CarolinaVasquez2000/FarmaBot/README.md

<!-- Imagen del encabezado centrada -->
<p align="center">
  FarmaBot Banner
</p>

# 💊 FarmaBot

**FarmaBot** El proyecto consiste en el desarrollo de un robot capaz de realizar la recolección de cajas de medicamentos específicos desde una estantería de farmacia, basándose en las instrucciones proporcionadas por un usuario. El robot navegará a lo largo de un camino predefinido y será capaz de manipular y transportar los medicamentos solicitados hasta una zona de recepción.
<p align="center">
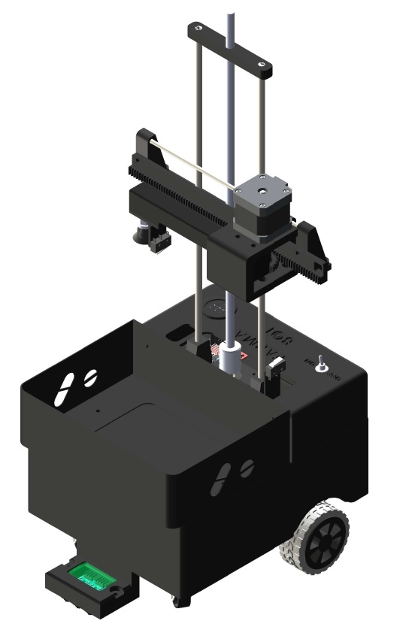
[picture p1: Imagenes y videos/CARRO FARMABOT.jpg]
FarmaBot Banner
  
</p>
<p align="center">
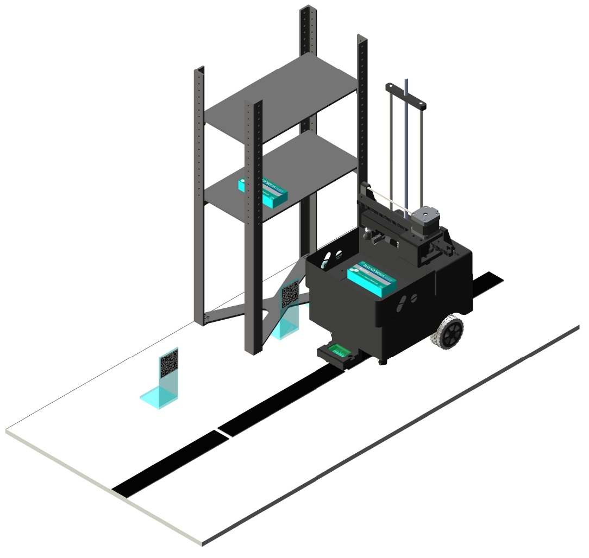
[picture p2: Imagenes y videos/CARRO CON ESTANTERIA.jpg]
  
</p>
<p align="center">
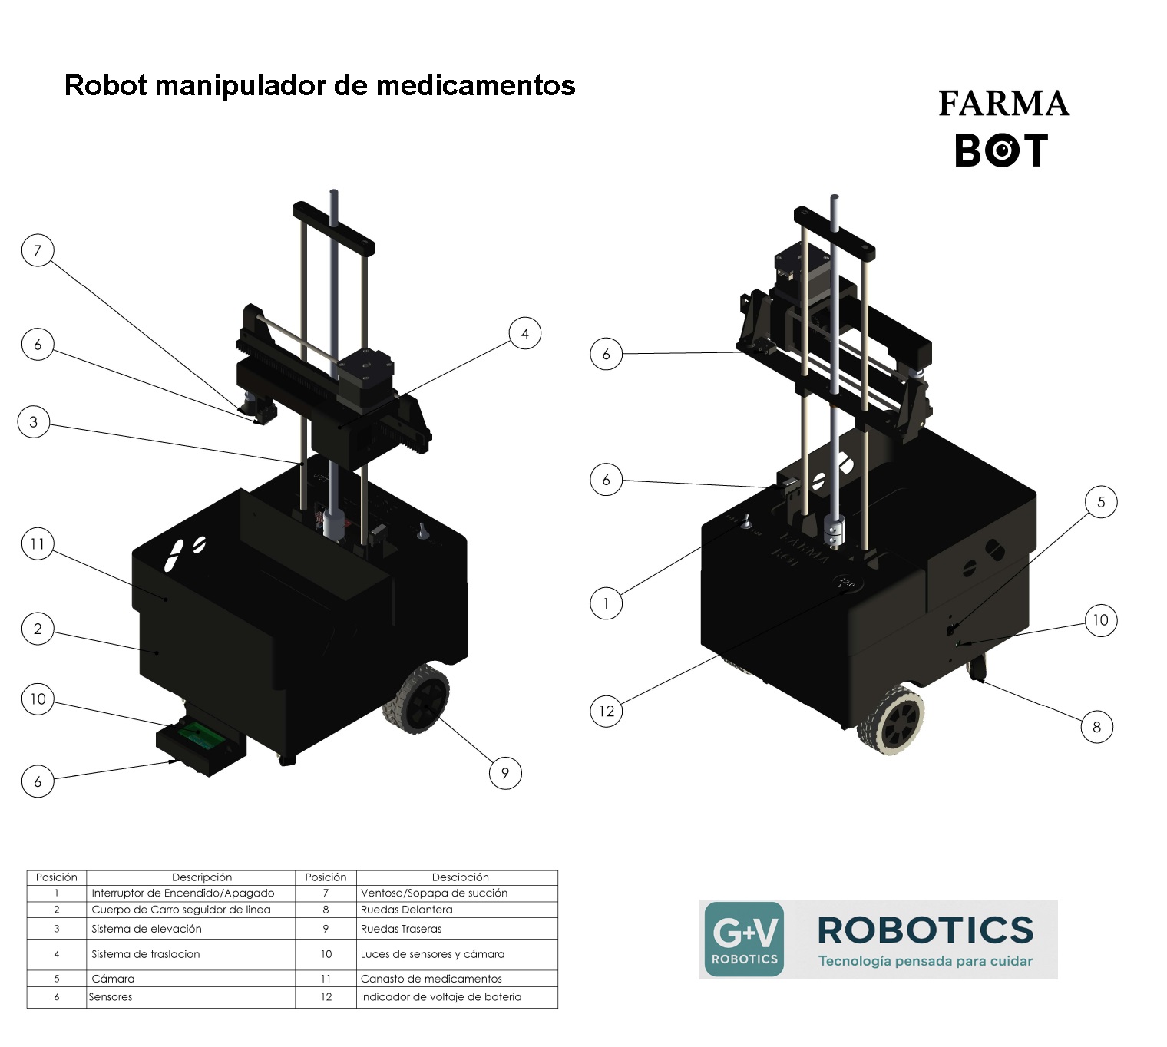
[picture p3: Imagenes y videos/PARTES.jpg]
  
</p>
---

## 👥 Integrantes

- Matías Nicolás Gabio  
- Carolina Vasquez

---

## 👨‍🏫 Profesores

- Ezequiel Blanca  
- Cristian Leandro Lukaszewicz  
- Juan Ignacio Szombach
