CarolinaVasquez2000/FarmaBot/Planos e informacion mécanica/Especificación técnica de productos comerciales mecanicos/29 - RUEDA LIBRE.pdf

DATASHEET GENERADO A PARTIR DE LA INFORMACION DE LA PAGINA DEL FABRICANTE

## Rueda Loca Tipo Pivot

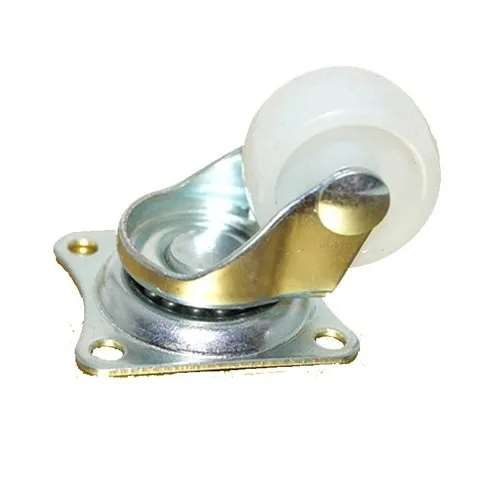
[picture p45: figure]

Altura: 35mm
Diámetro rueda: 24mm
Ancho rueda: 13mm
Peso: 32,6 g

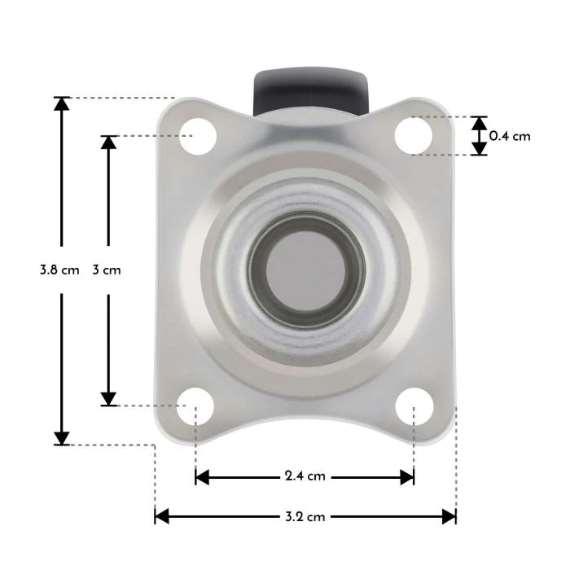
[picture p46: figure]
