CarolinaVasquez2000/FarmaBot/Planos e informacion mécanica/Especificación técnica de productos comerciales mecanicos/30 - LLANTA DE RUEDA MOTRIZ.pdf

DATASHEET GENERADO A PARTIR DE LA INFORMACION DE LA PAGINA DEL FABRICANTE

## Rueda Para Motor Con Encastre Roboca Arduino

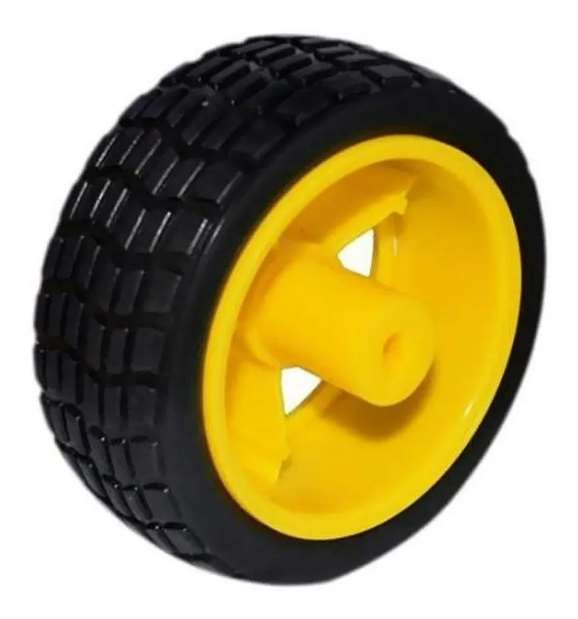
[picture p47: figure]

Agujero central: 5.3 x 3.66mm Tamaño de llanta: 65 x 28mm Peso: 32gr
