CarolinaVasquez2000/FarmaBot/Planos e informacion mécanica/Especificación técnica de productos comerciales mecanicos/39 - 50 - VARILLA ROSCADA ASCENSO - TUERCA THSTL 8 MM TIPO ACME TRAPEZOIDAL.pdf

DATASHEET GENERADO A PARTIR DE LA INFORMACION DE LA PAGINA DEL FABRICANTE

## Husillo Eje Z Con Tuerca Original Ender 3 V2

Largo 380 mm
THSTL 8 mm po ACME

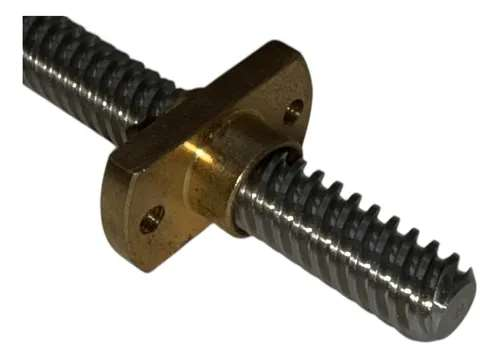
[picture p48: figure]
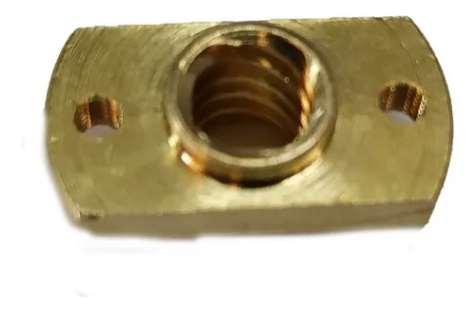
[picture p49: figure]

Tuerca para Varilla Tornillo THSL T8
