CarolinaVasquez2000/FarmaBot/Planos e informacion mécanica/Especificación técnica de productos comerciales mecanicos/41 - RACORD M8 ACOPLE.pdf

DATASHEET GENERADO A PARTIR DE LA INFORMACION DE LA PAGINA DEL FABRICANTE

## Acople Racor M8

CARACTERISTICAS:

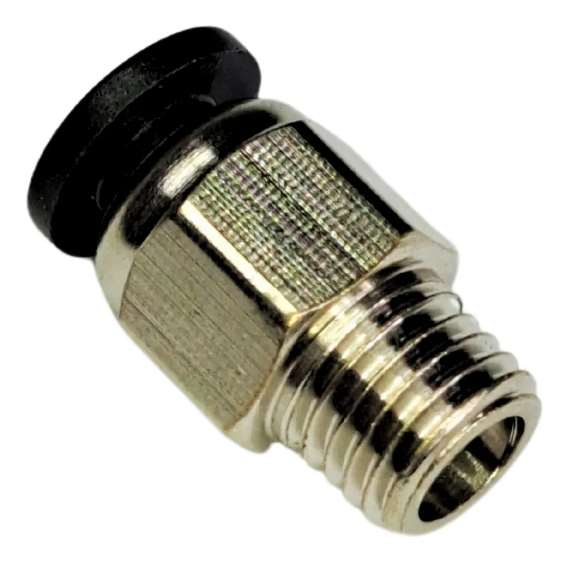
[picture p50: figure]

Acople neumaco racor modelo M6 SIN TOPE de rosca M8 para manguera de 4mm

DESCRIPCION:
Modelo:M8 SIN TOPE
Rosca: M8
Para Manguera: 4mm
Material: Bronce
