CarolinaVasquez2000/FarmaBot/Planos e informacion mécanica/Especificación técnica de productos comerciales mecanicos/45 - PLACA PERFORADA.pdf

DATASHEET GENERADO A PARTIR DE LA INFORMACION DE LA PAGINA DEL FABRICANTE

## Pcb Placa Protoboard Doble Faz 4x6 Cm Protopo

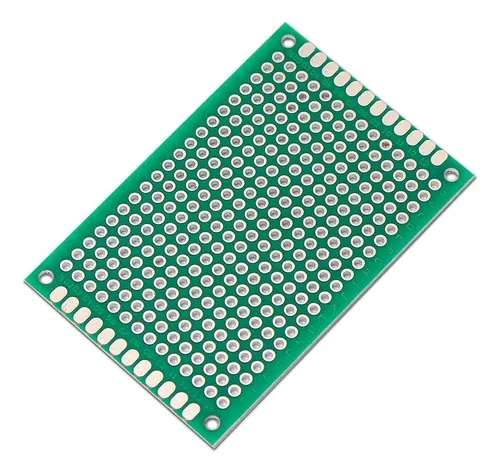
[picture p51: figure]

Pcb Placa Protoboard Doble Faz 4x6 Cm Protopo Fr4 Placa protopo 4x6cm doble faz FR4
