CarolinaVasquez2000/FarmaBot/Planos e informacion mécanica/Especificación técnica de productos comerciales mecanicos/51 - ACOPLE RIGIDO.pdf

DATASHEET GENERADO A PARTIR DE LA INFORMACION DE LA PAGINA DEL FABRICANTE

## Acople Rígido Impresora 3d Creality

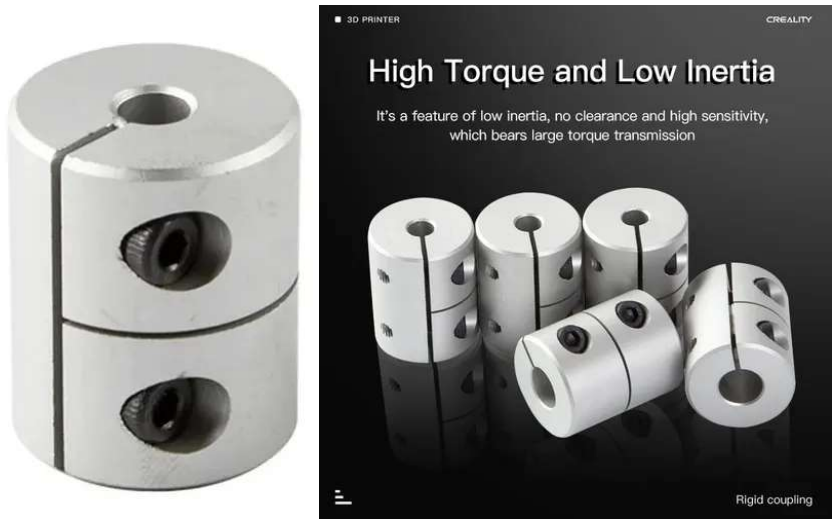
[picture p52: figure]

Descripción:
Alto: 25 mm
Diámetro: 20 mm
Diámetro de orificios: 7,5 mm y 4,5 mm (ajustables) Material: aluminio
