CarolinaVasquez2000/FarmaBot/Planos e informacion mécanica/Especificación técnica de productos comerciales mecanicos/52 - ENGRANAJE HOBBED MK8 MOLETEADO.pdf

DATASHEET GENERADO A PARTIR DE LA INFORMACION DE LA PAGINA DEL FABRICANTE

## Rueda Dentada Hobbed Mk8 Creality 40 Dientes Extrusor

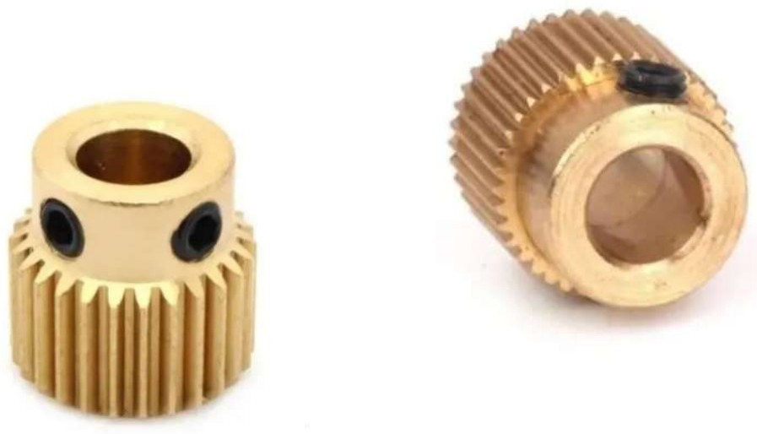
[picture p53: figure]

RUEDA DENTADA DE EXTRUSOR

Color: Dorado
Material: Bronce
Diametro Interior: 5mm
Diametro Exterior: 11mm
Altura: 11mm

### 40 dientes
