CarolinaVasquez2000/FarmaBot/Planos e información eléctrica/Especificación técnica de productos comerciales eléctricos/35 - BATERIA 12 V 4 AMPHORA.pdf

DATASHEET GENERADO A PARTIR DE LA INFORMACION DE LA PAGINA DEL FABRICANTE

BATERIA DE GEL 12V 4A PRESS MICROSWICH LLAVE SIMPLE INVERSORA 5A 250V CON PALANCA 15mm 1° CALIDAD

DISTANCIA AGUJERO A AGUJERO : 10mm

BATERIA GEL 12VOLT 4Ah
MODELO: PR1240

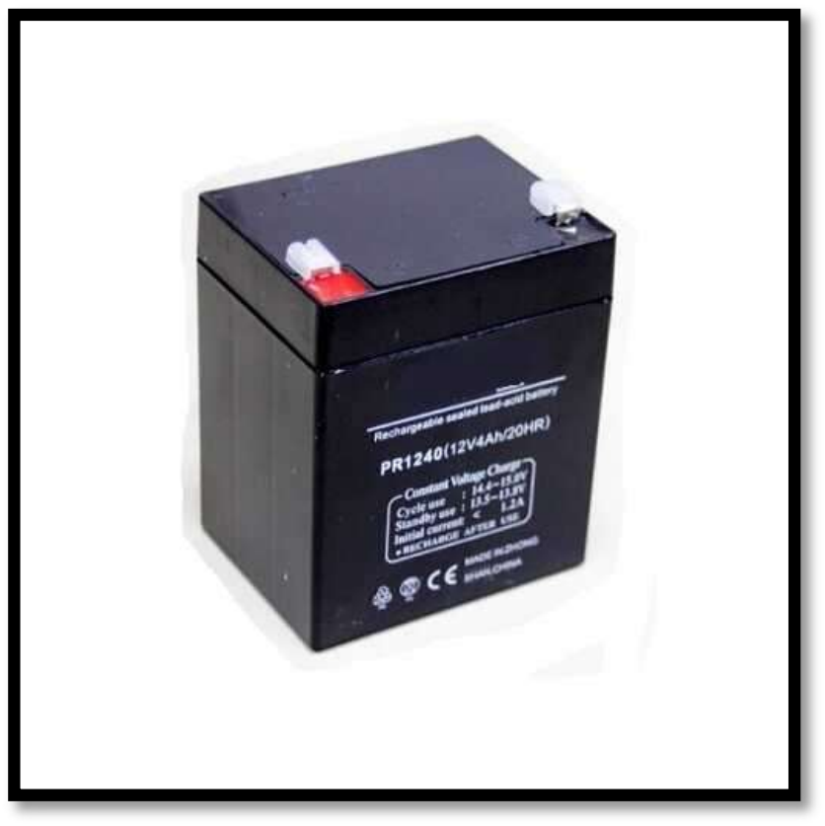
[picture p54: figure]

BATERIA MARCA PRESS 12V 4A PLOMO ACIDO
SELLADA DE PLOMO CALCIO

CARGA FLOTANTE: 13.5 - 13.8 CORRIENTE INICIAL: SIN LÍMITE CARGA CÍCLICA: 14,4 - 15v CORRIENTE INICIAL: 1,2A Max

Largo:90MM
Ancho:70MM
Altura:101MM
Tipo de conector: FO-01
