CarolinaVasquez2000/FarmaBot/Planos e información eléctrica/Especificación técnica de productos comerciales eléctricos/47 - INDICADOR DE VOLTAJE.pdf

DATASHEET GENERADO A PARTIR DE LA INFORMACION DE LA PAGINA DEL FABRICANTE

## Medidor Voltaje Panel Digital 3 Digitos 30mm 4v A 100v

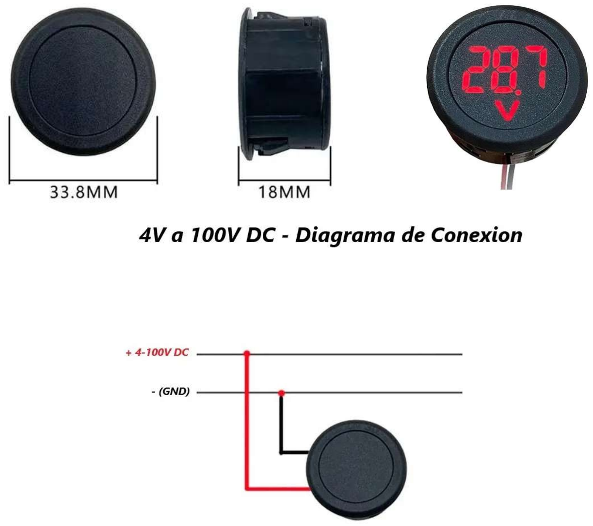
[picture p55: figure]

Especificaciones:
- Volmetro Digital
- 3 Dígitos
- Cables de Conexión: 2 (Dos)
- Tamaño: 30mm
- Voltaje de Alimentación: 3.8V a 100V DC
- Voltaje de Medición en Led: 4V a 100V DC
- Consumo: 15mA
- Margen de error volmetro: 0.1%
- Tiempo de refresco: 300ms
- Largo de Cable: 20cm
- Dimensión para Montaje: 30mm
- Peso: 26gr
