CarolinaVasquez2000/FarmaBot/Planos e información eléctrica/Especificación técnica de productos comerciales eléctricos/48 - MOTOR PASO A PASO NEMA 17 42-40.pdf

DATASHEET GENERADO A PARTIR DE LA INFORMACION DE LA PAGINA DEL FABRICANTE

## MOTOR PASO A PASO NEMA 17 42-40 CREALITY

ESPECIFICACIONES:
Ángulo de paso: 1,8 grados Pasos: 200
Tensión nominal: 4.83V
Clasificación actual: 1.5A

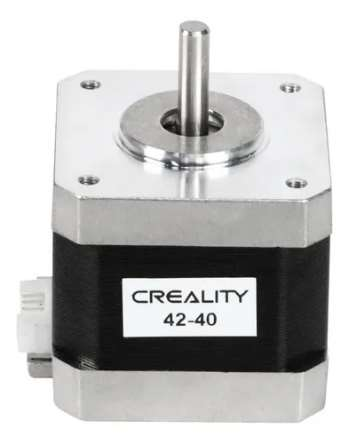
[picture p56: figure]

Velocidad nominal: 1-1000rpm Velocidad nominal: 1-1000tpm Par de torsión nominal: 0.4NM Temperatura de trabajo: -20 - 50C Longitud: 40mm
Peso 290 g

DATASHEET GENERADO A PARTIR DE LA INFORMACION DE LA PAGINA DEL FABRICANTE

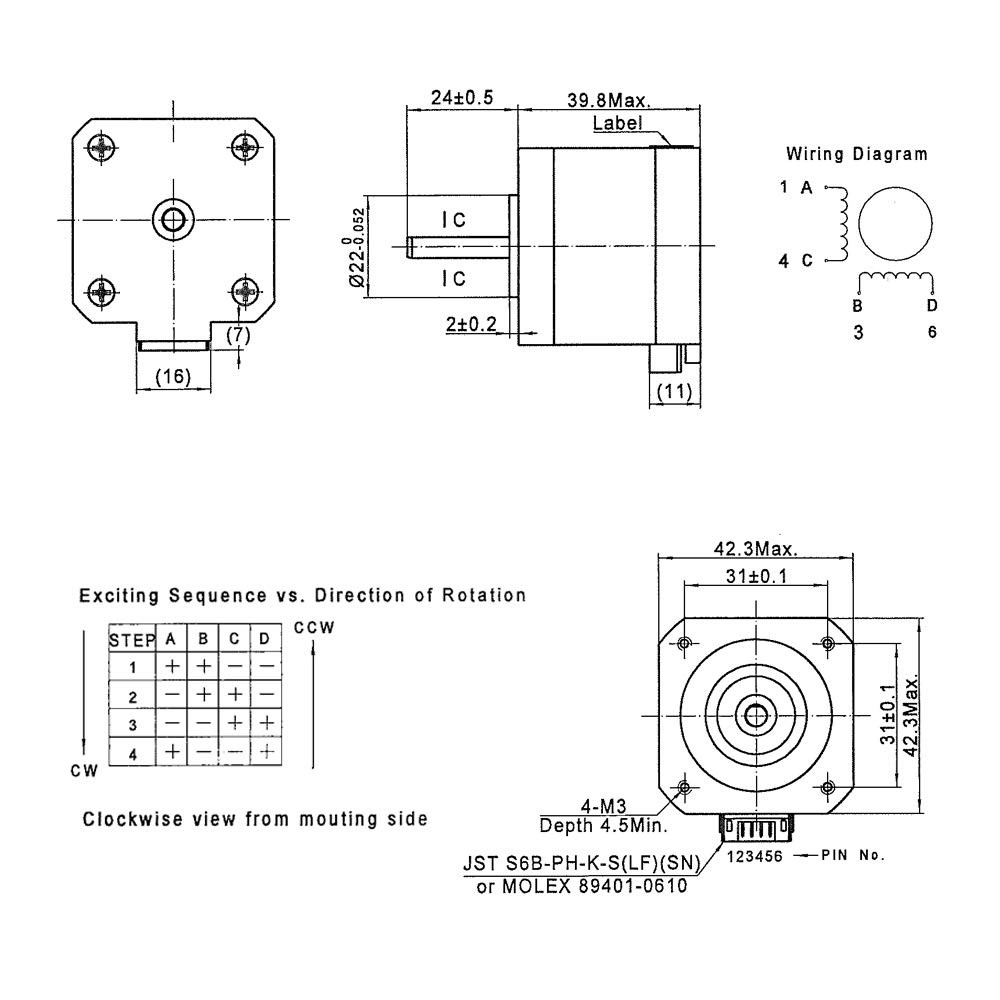
[picture p57: figure]
