CarolinaVasquez2000/FarmaBot/Planos e información eléctrica/Especificación técnica de productos comerciales eléctricos/49 - MOTOR PASO A PASO NEMA 17 42-34.pdf

## MOTOR PASO A PASO NEMA 17 42-34

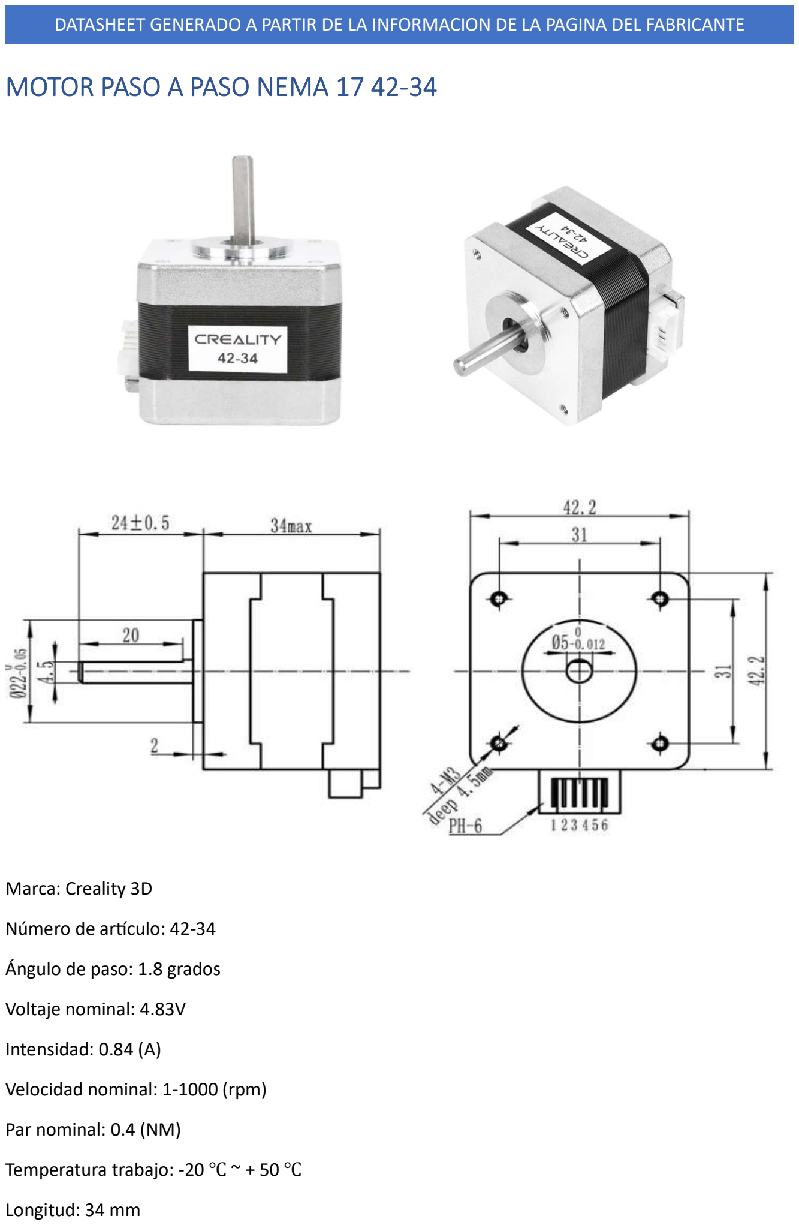
[picture p58: page 1]

DATASHEET GENERADO A PARTIR DE LA INFORMACION DE LA PAGINA DEL FABRICANTE

Marca: Creality 3D
Número de arculo: 42-34
Ángulo de paso: 1.8 grados Voltaje nominal: 4.83V
Intensidad: 0.84 (A)
Velocidad nominal: 1-1000 (rpm) Par nominal: 0.4 (NM)
Temperatura trabajo: -20 ℃ ~ + 50 ℃ Longitud: 34 mm
