CarolinaVasquez2000/FarmaBot/Consultas realizadas/CONSTANCIA DE CONSULTA REALIZADA A MARTIN GONZALEZ.pdf

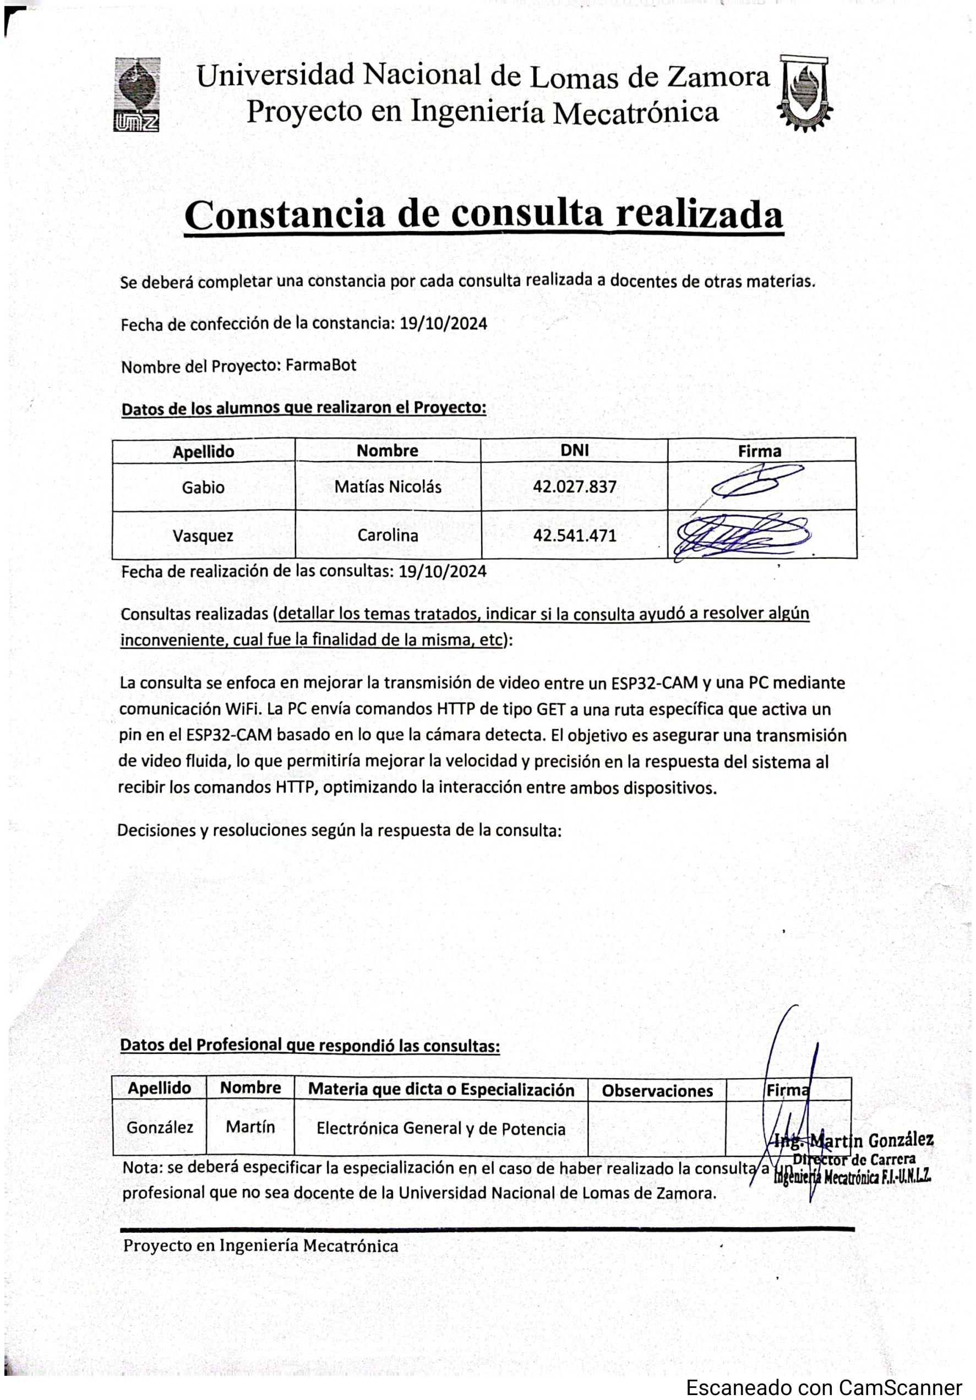
[picture p59: page 1]
