CarolinaVasquez2000/FarmaBot/Consultas realizadas/CONSTANCIA DE CONSULTA REALIZADA A MATIAS JOEL HIRAK.pdf

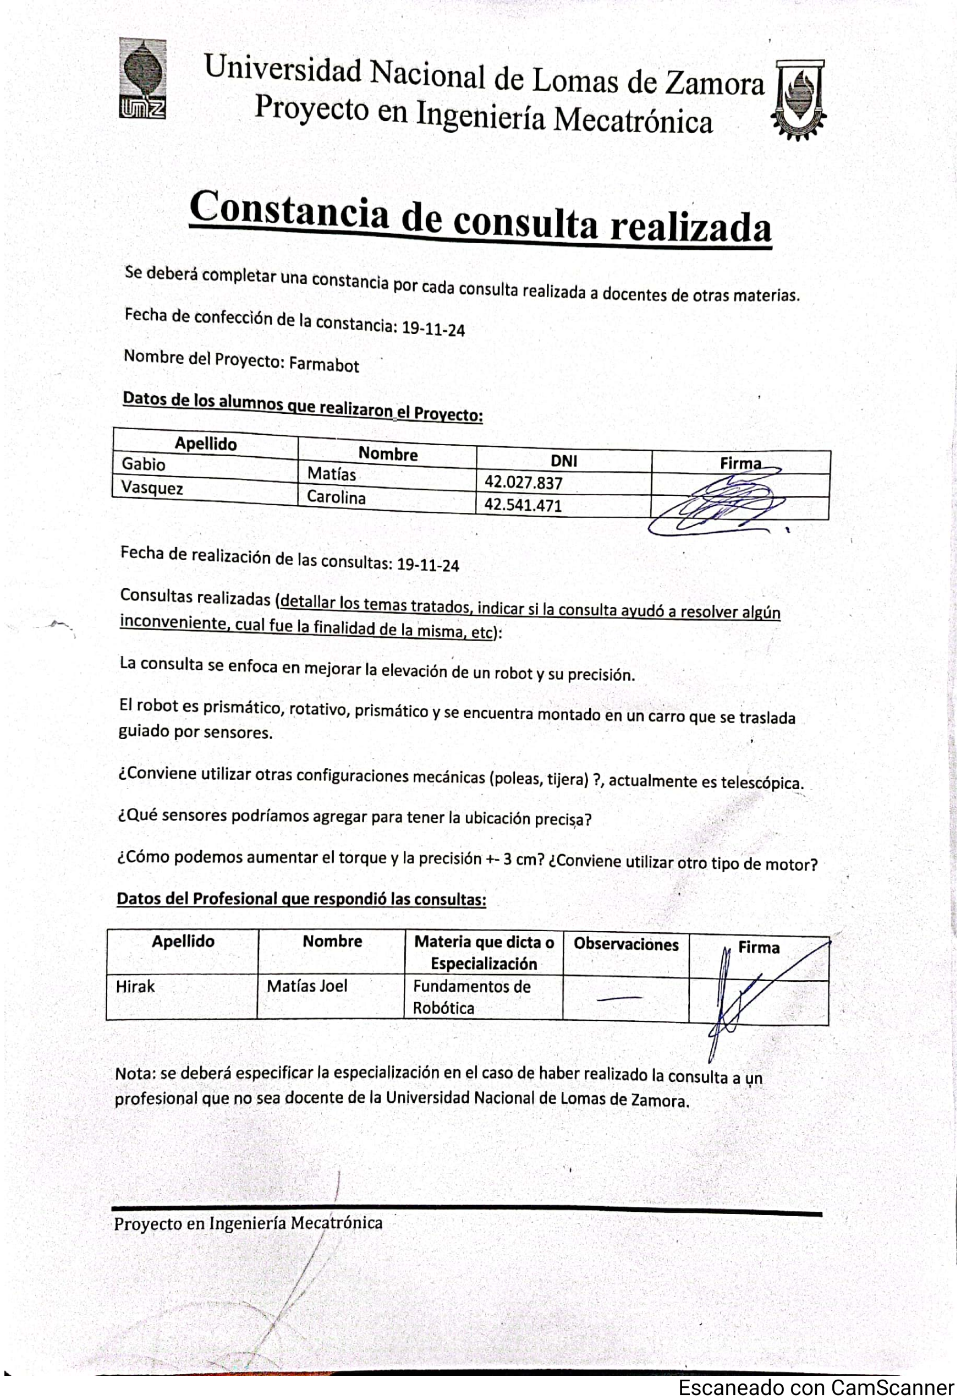
[picture p60: page 1]
