CarolinaVasquez2000/FarmaBot/Planos e informacion mécanica/Planos Mecanicos/01 - BASE DE CARRO.pdf

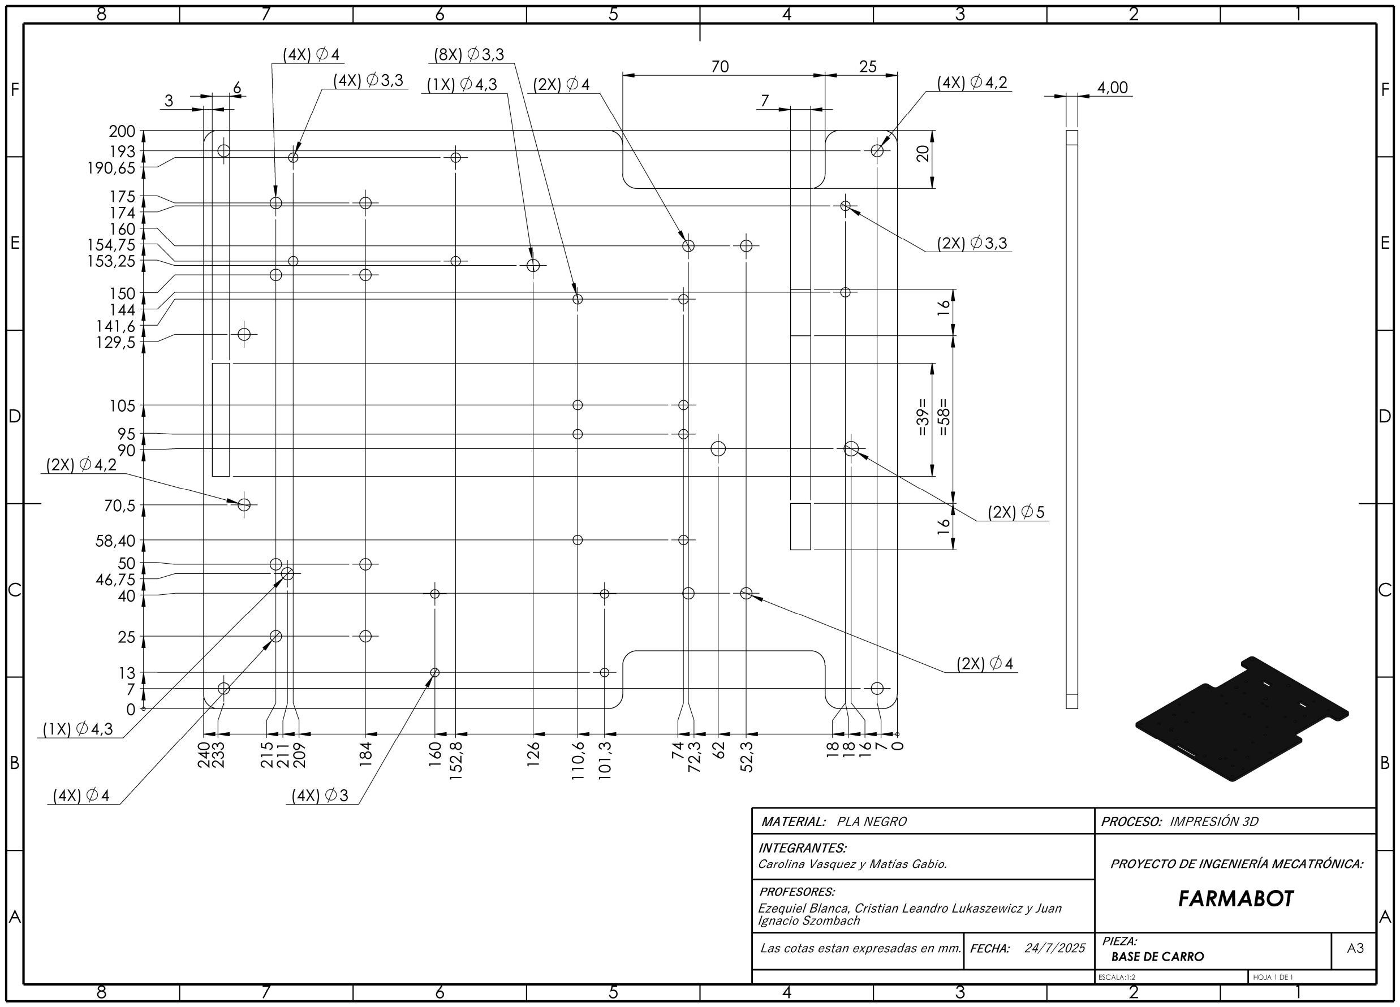
[picture p61: page 1]
