CarolinaVasquez2000/FarmaBot/Planos e informacion mécanica/Planos Mecanicos/02 - SOPORTE DE RUEDAS.pdf

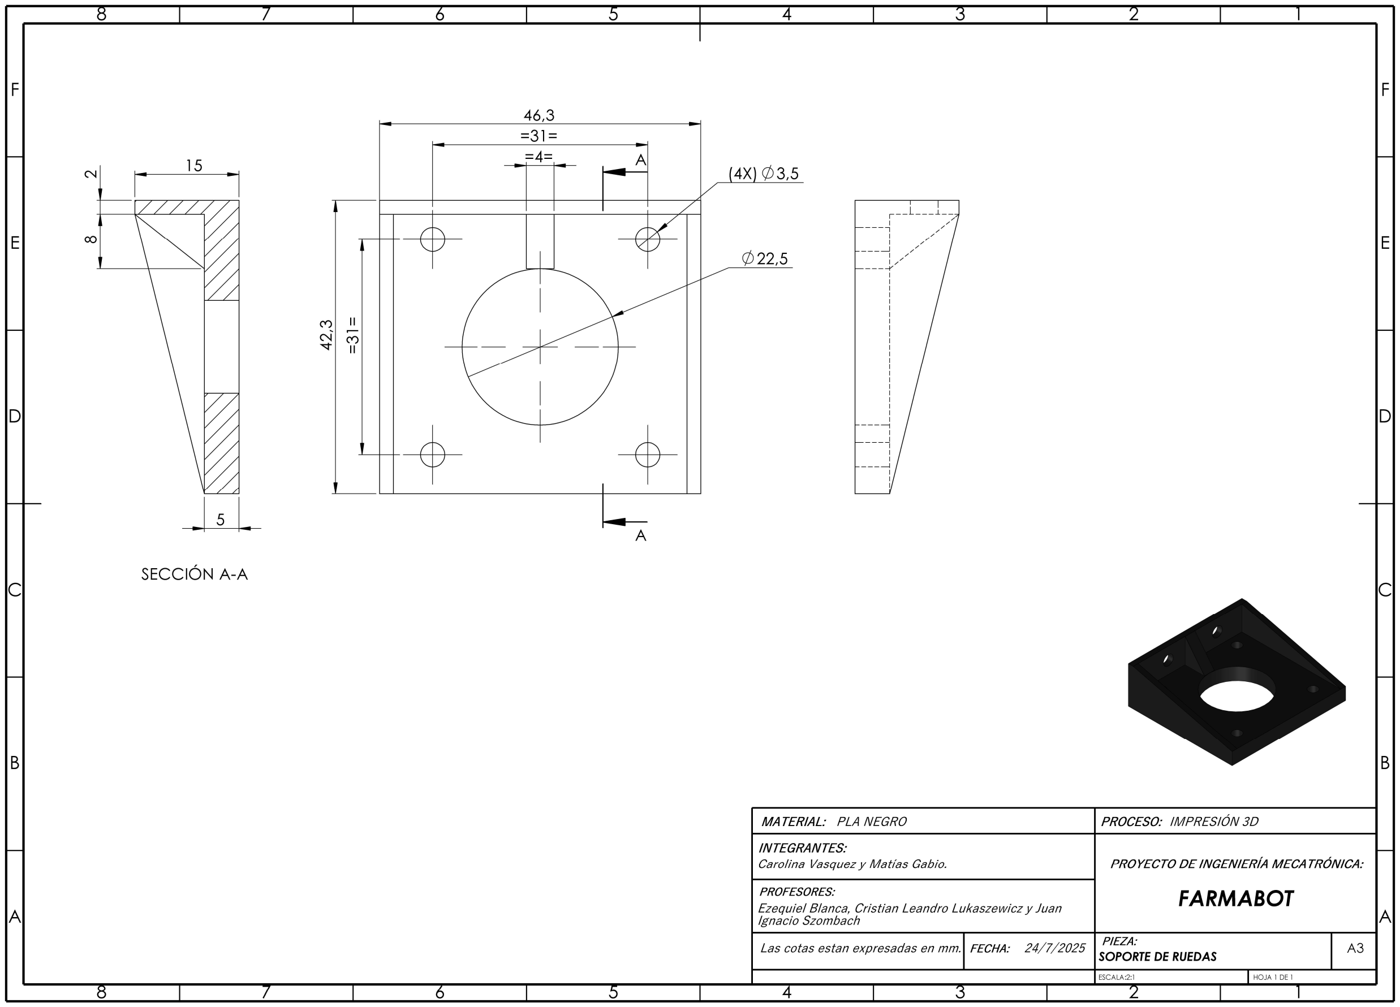
[picture p62: page 1]
