CarolinaVasquez2000/FarmaBot/Planos e informacion mécanica/Planos Mecanicos/04 - SOPORTE DE SENSORES.pdf

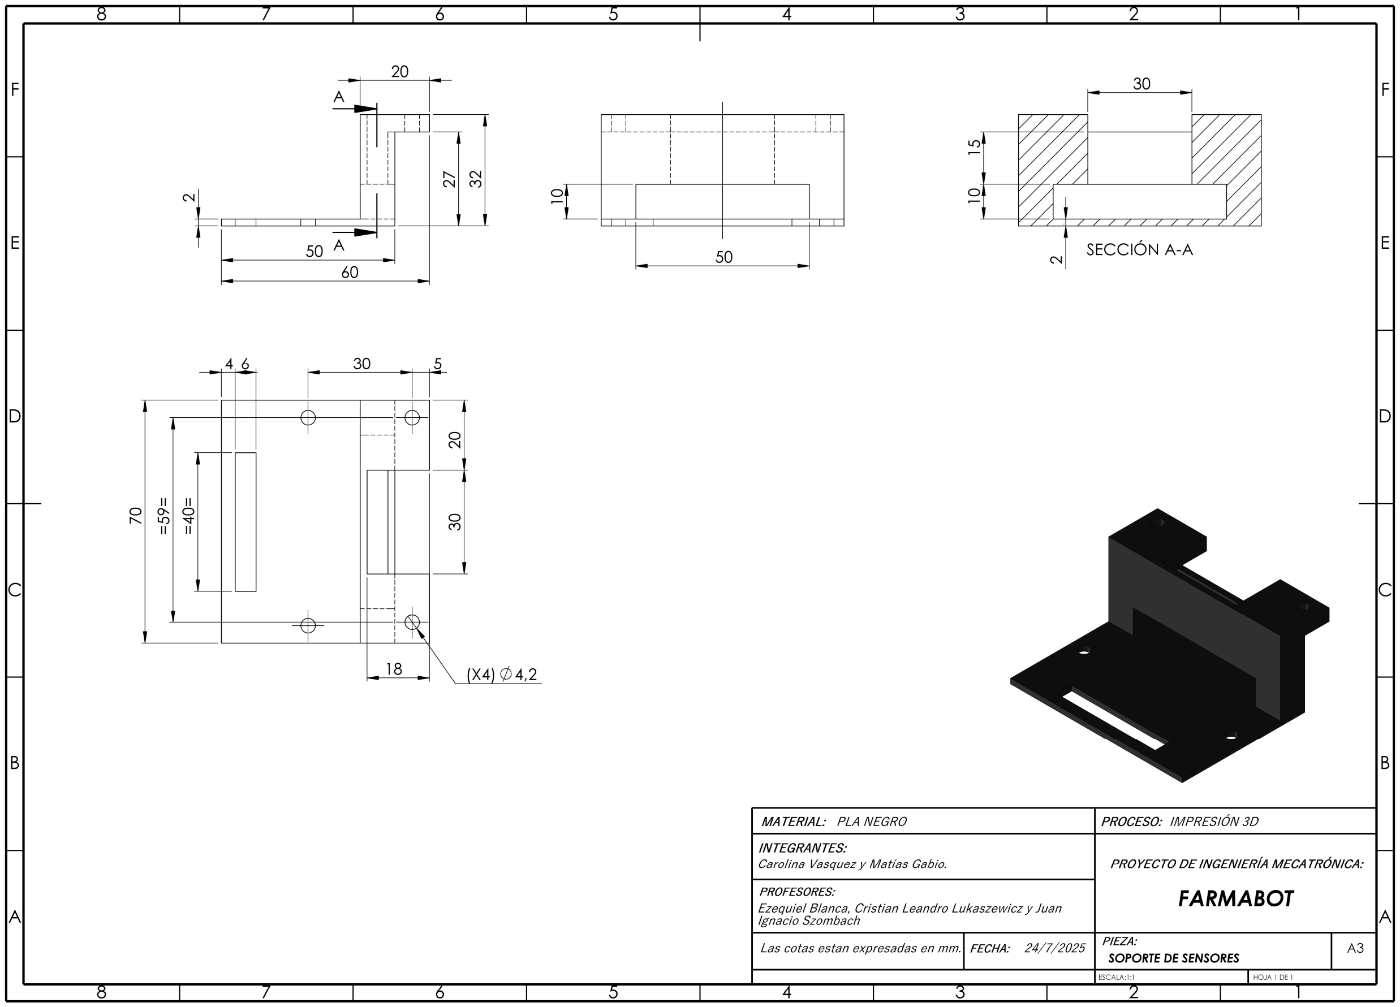
[picture p63: page 1]
