CarolinaVasquez2000/FarmaBot/Planos e informacion mécanica/Planos Mecanicos/05 - BASE DE RUEDA.pdf

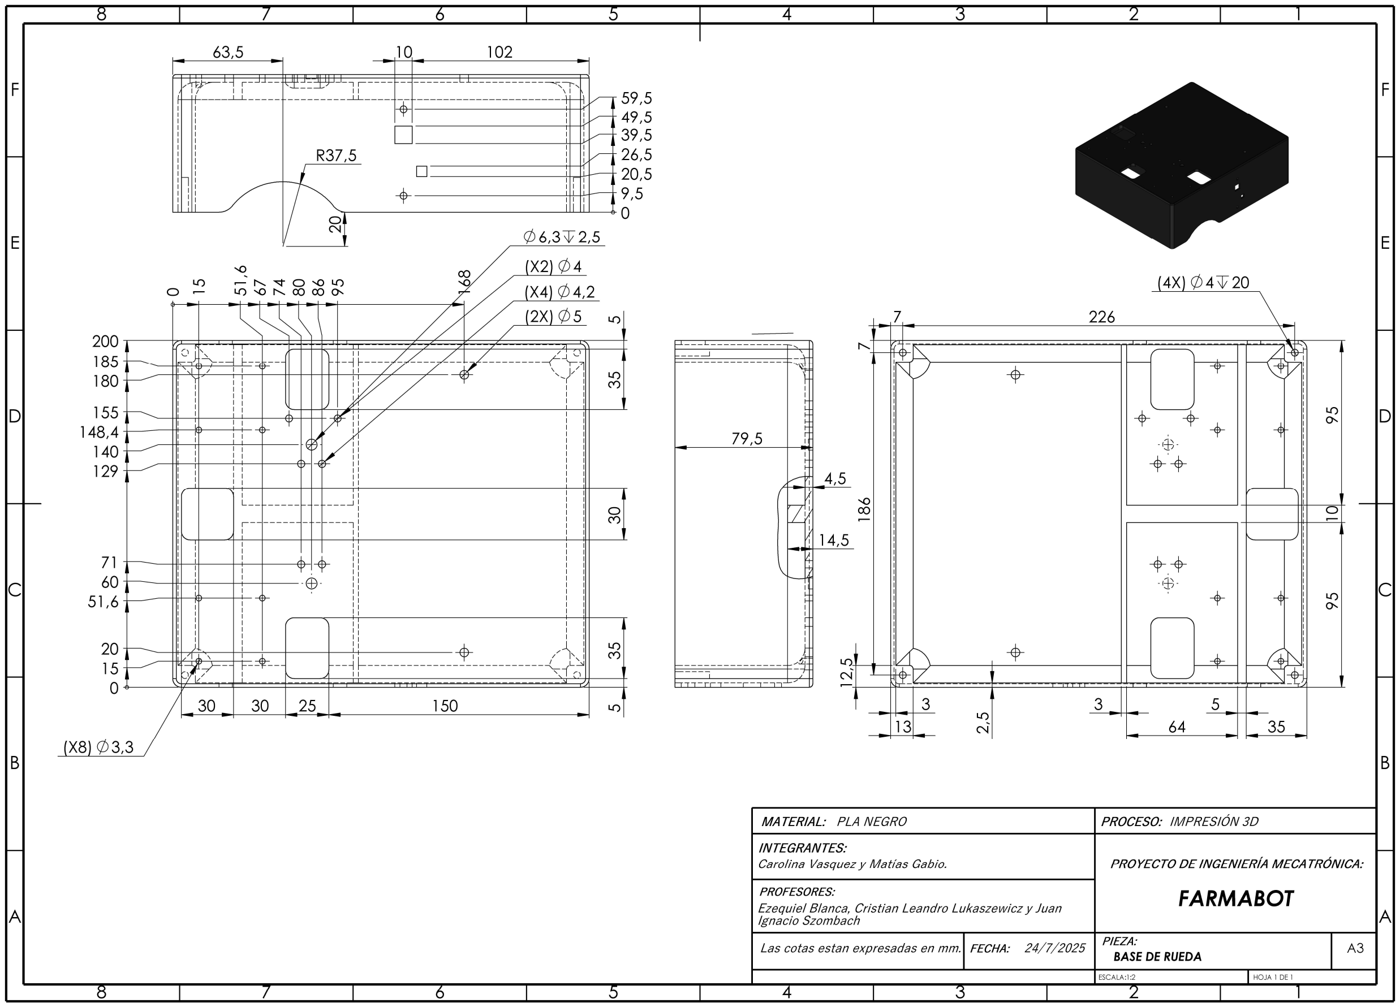
[picture p64: page 1]
