CarolinaVasquez2000/FarmaBot/Planos e informacion mécanica/Planos Mecanicos/06 - FIJACION DE MOTOR DE ASCENSO.pdf

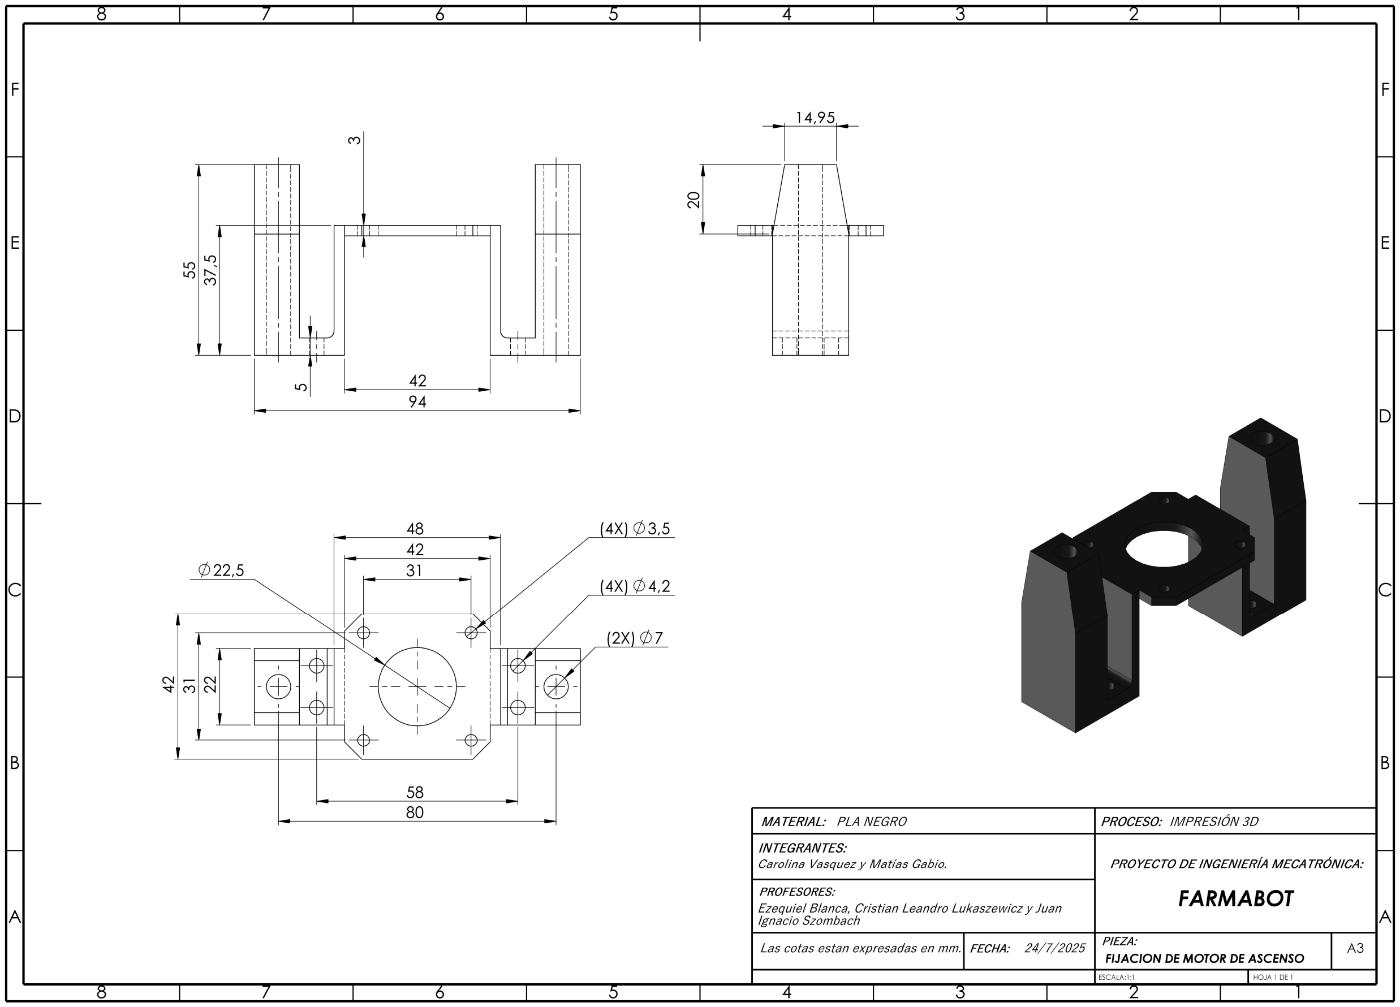
[picture p65: page 1]
