CarolinaVasquez2000/FarmaBot/Planos e informacion mécanica/Planos Mecanicos/07 - LLANTA Y ACOPLE DE RUEDA MOTRIZ.pdf

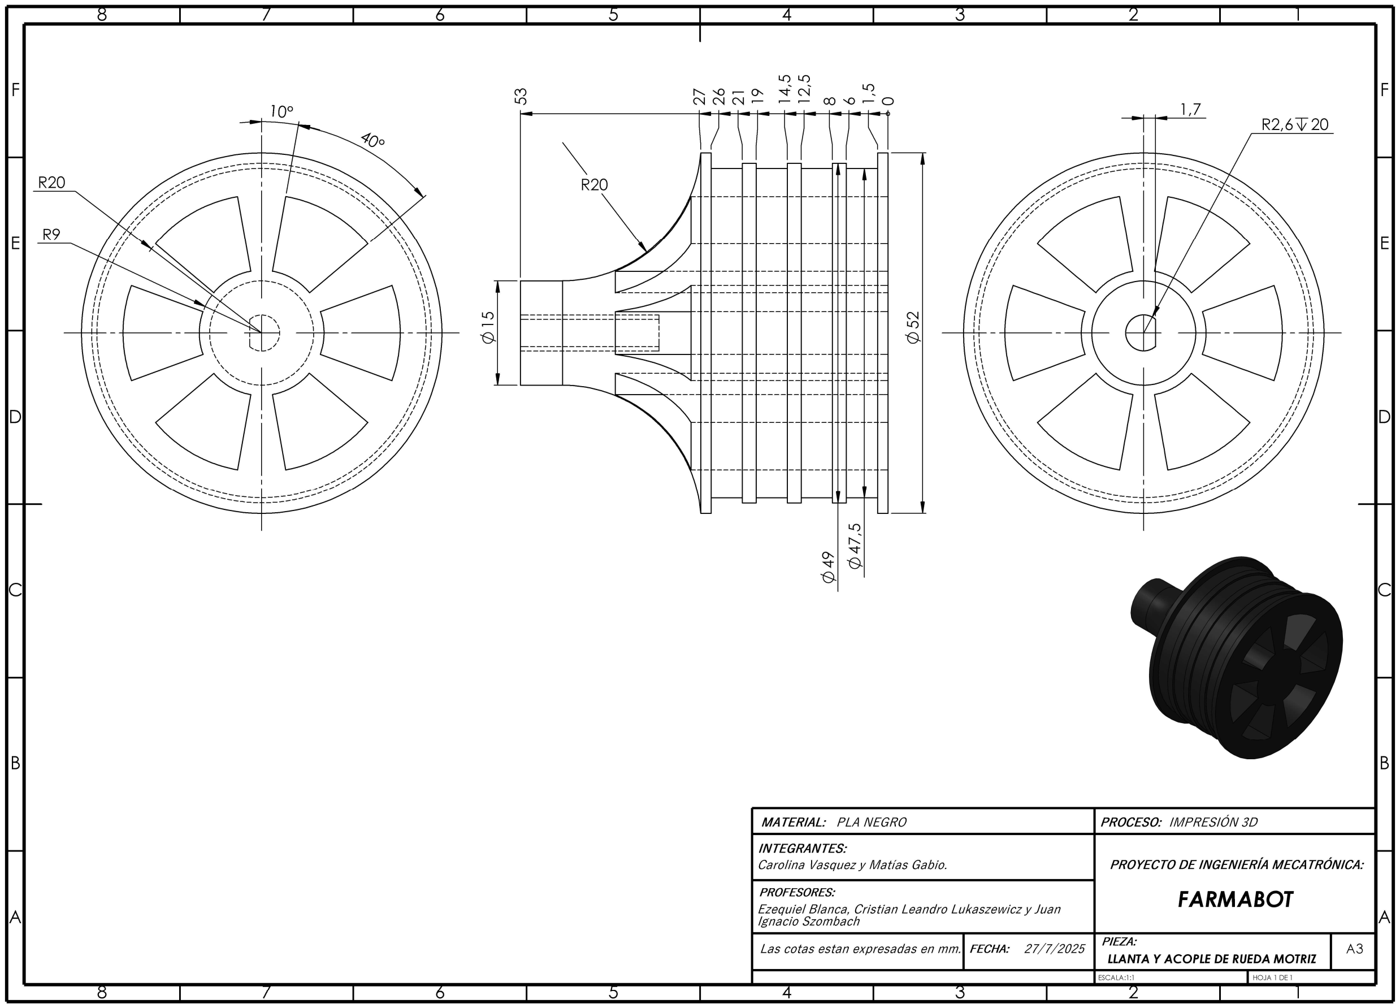
[picture p66: page 1]
