CarolinaVasquez2000/FarmaBot/Planos e informacion mécanica/Planos Mecanicos/08 - CAJON DE MEDICAMENTOS.pdf

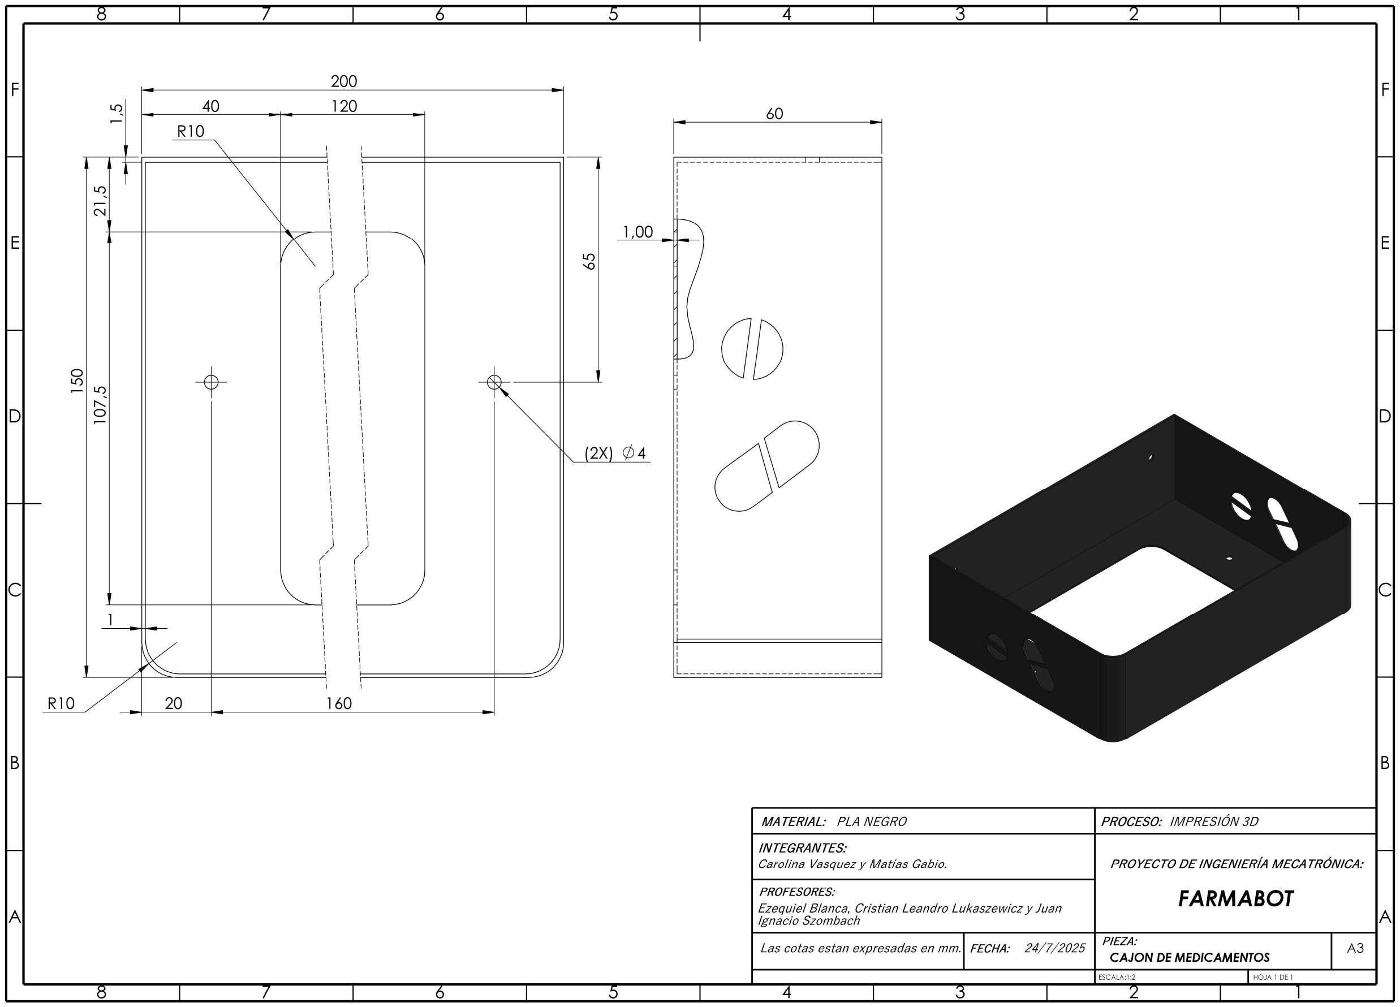
[picture p67: page 1]
