CarolinaVasquez2000/FarmaBot/Planos e informacion mécanica/Planos Mecanicos/09 - SOPORTE MEDIO.pdf

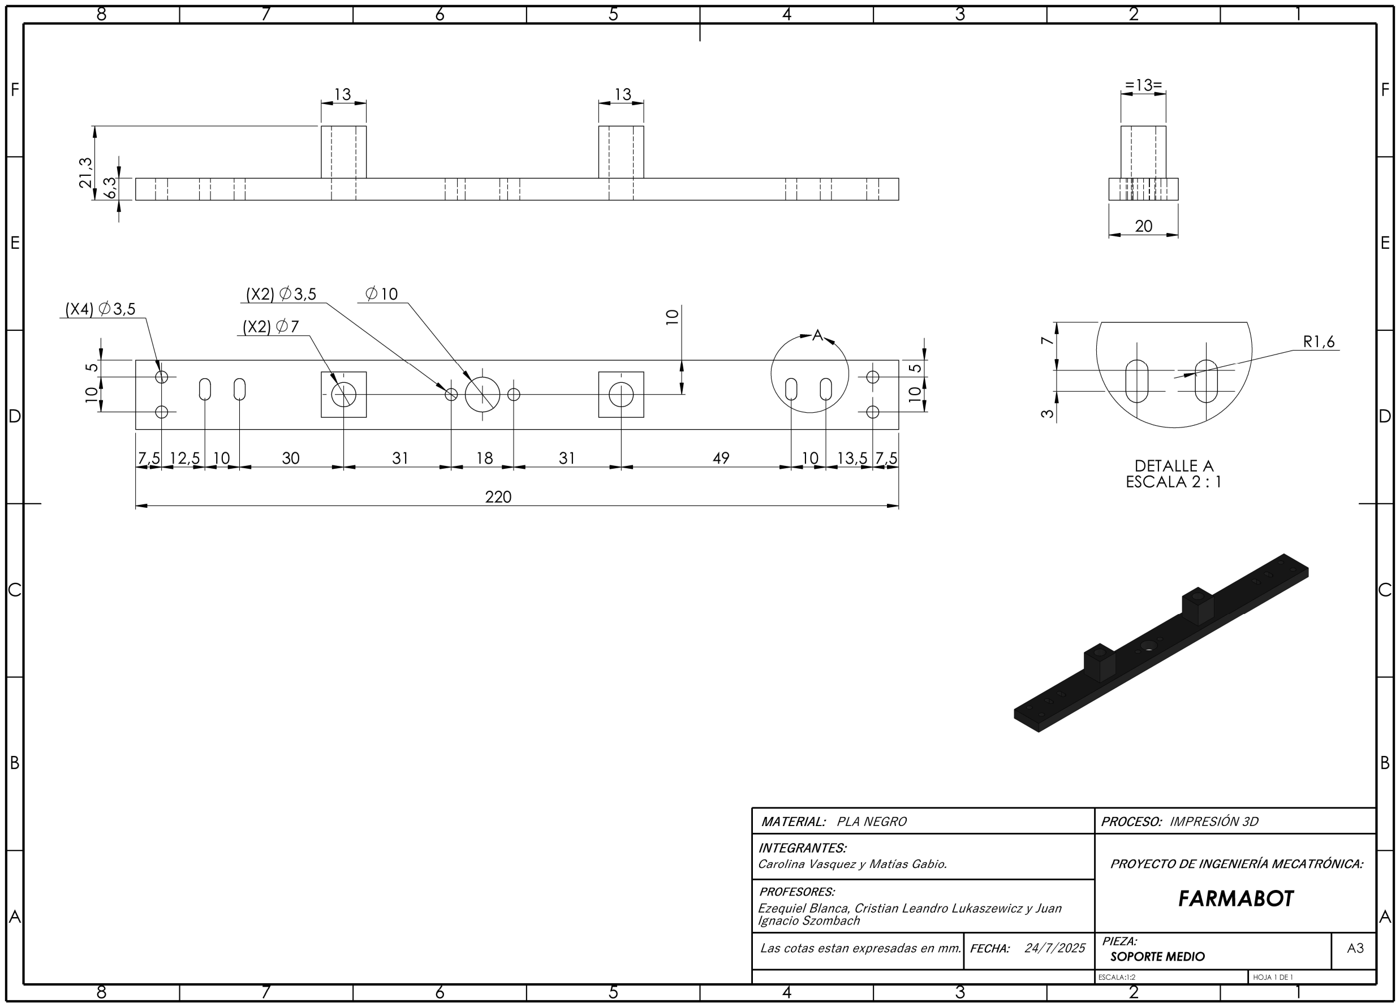
[picture p68: page 1]
