CarolinaVasquez2000/FarmaBot/Planos e informacion mécanica/Planos Mecanicos/10 - CREMALLERA.pdf

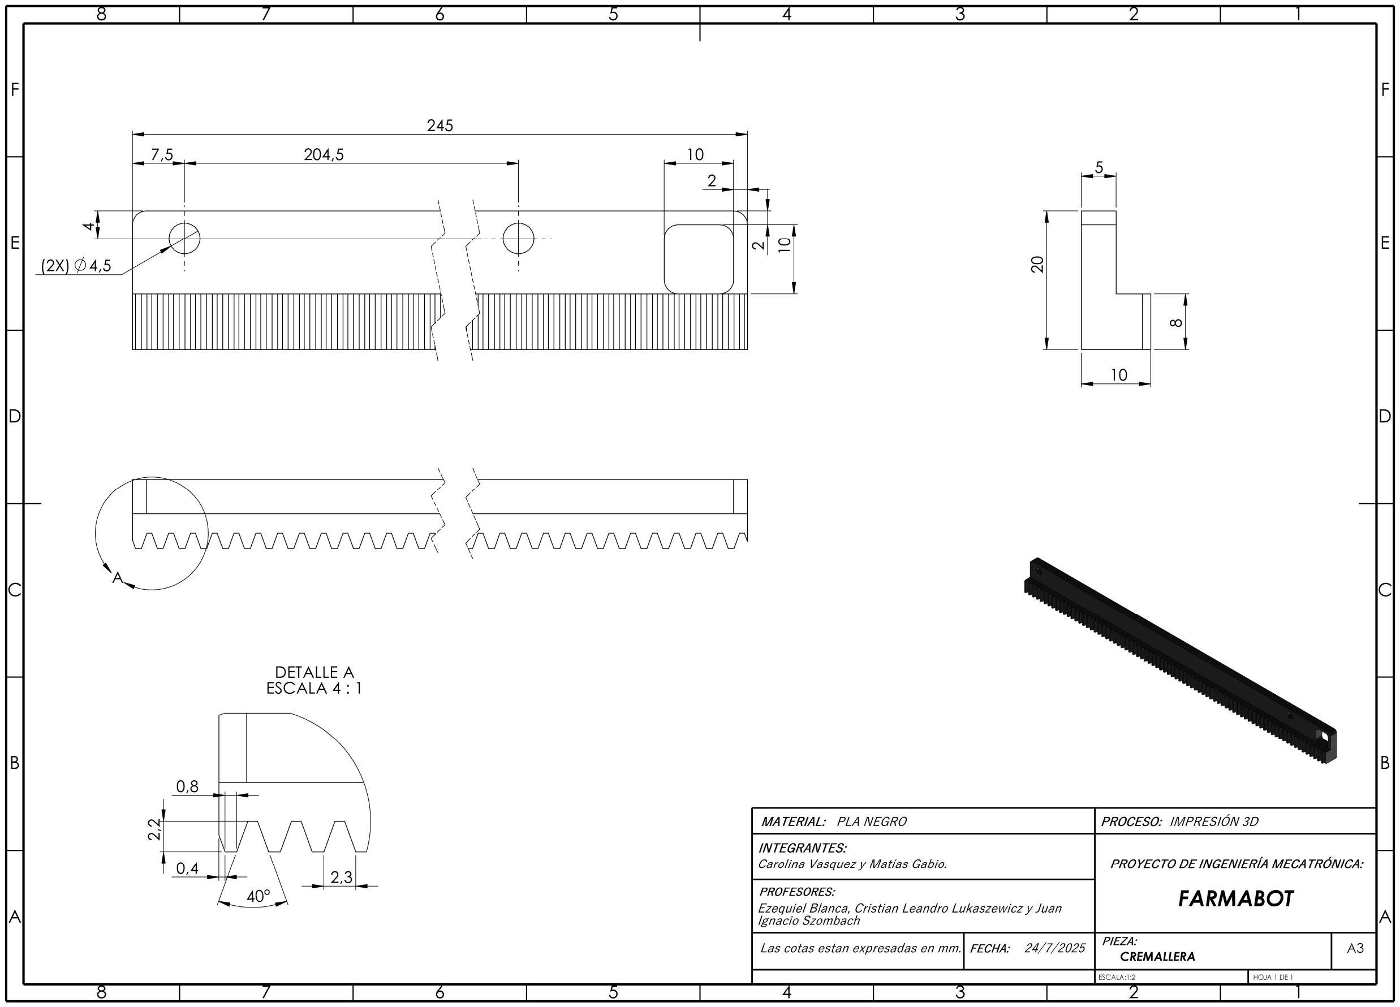
[picture p69: page 1]
