CarolinaVasquez2000/FarmaBot/Planos e informacion mécanica/Planos Mecanicos/11 - ENGRANAJE DE CREMALLERA CON ACOPLE.pdf

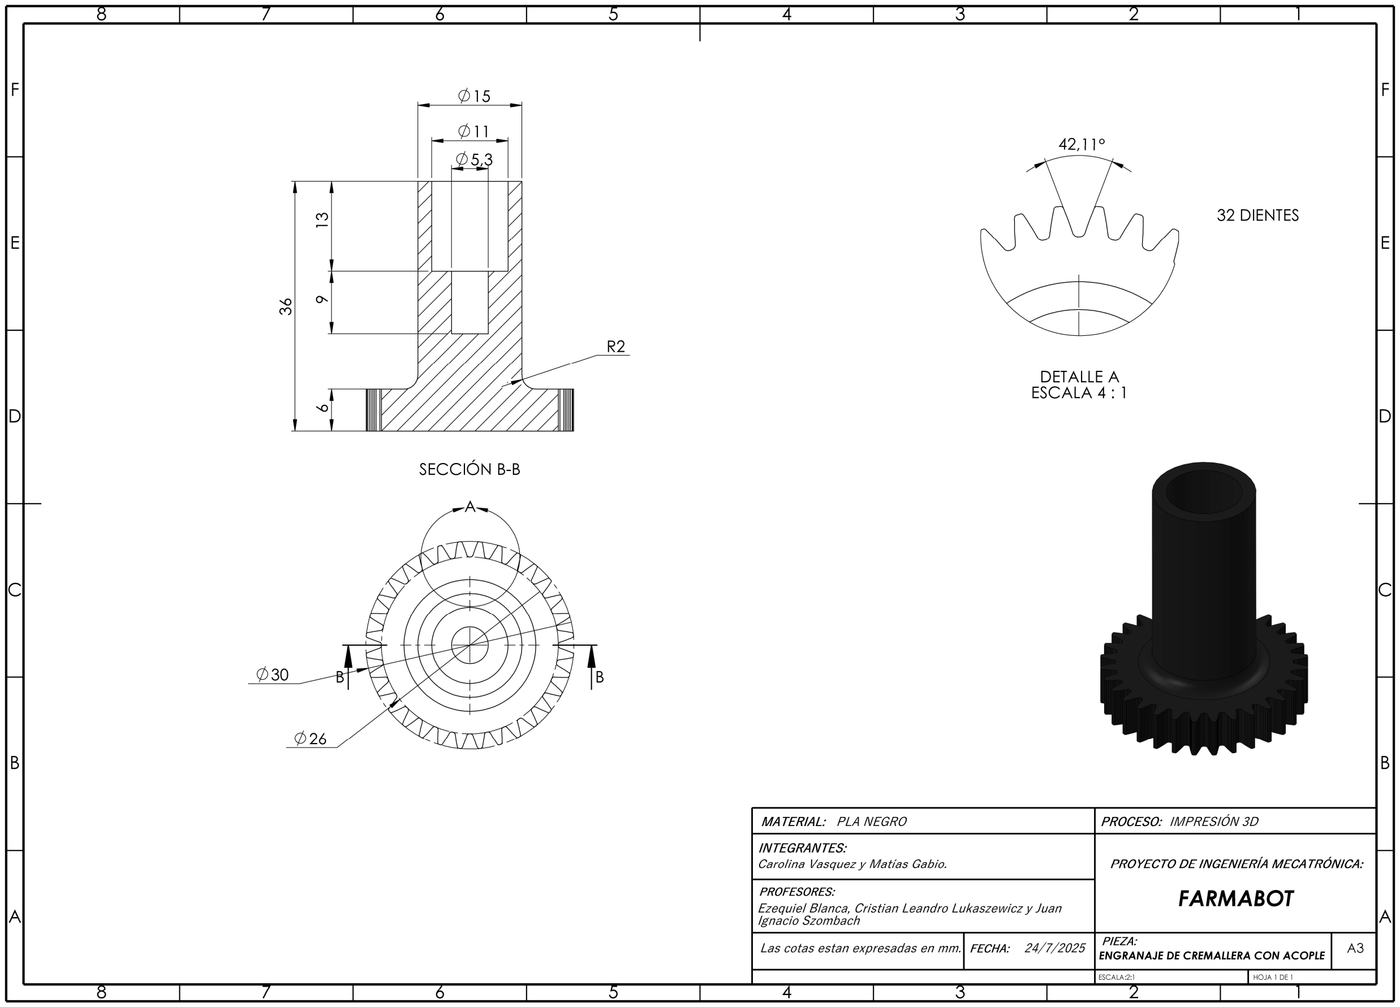
[picture p70: page 1]
