CarolinaVasquez2000/FarmaBot/Planos e informacion mécanica/Planos Mecanicos/12 - SOPORTE DE SUCCION.pdf

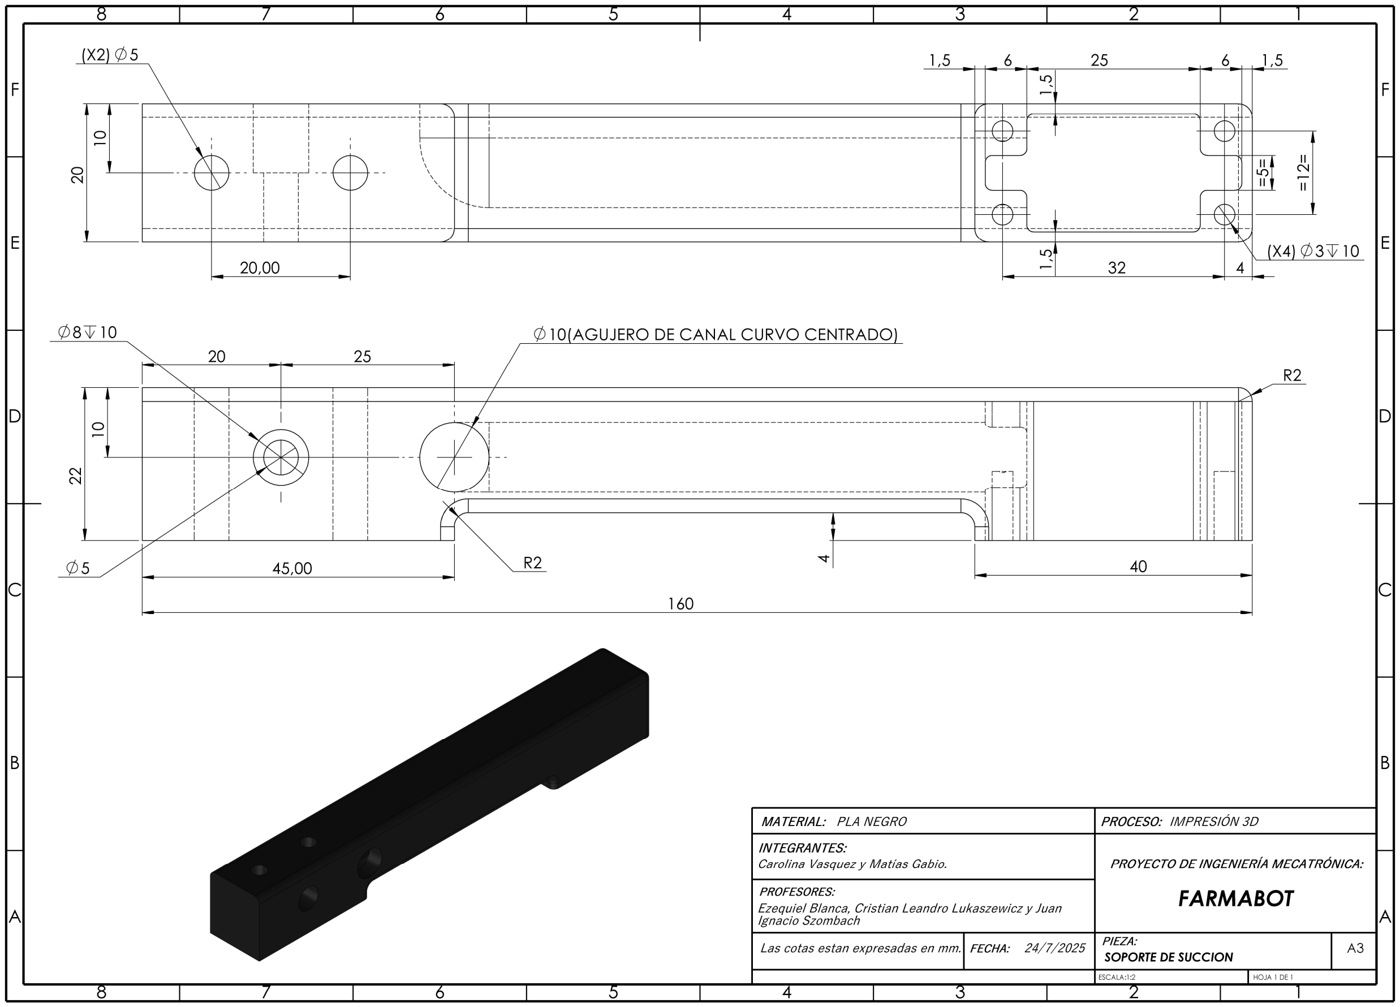
[picture p71: page 1]
