CarolinaVasquez2000/FarmaBot/Planos e informacion mécanica/Planos Mecanicos/13 - SOPORTE DE SOPAPA Y MICROSWITCH.pdf

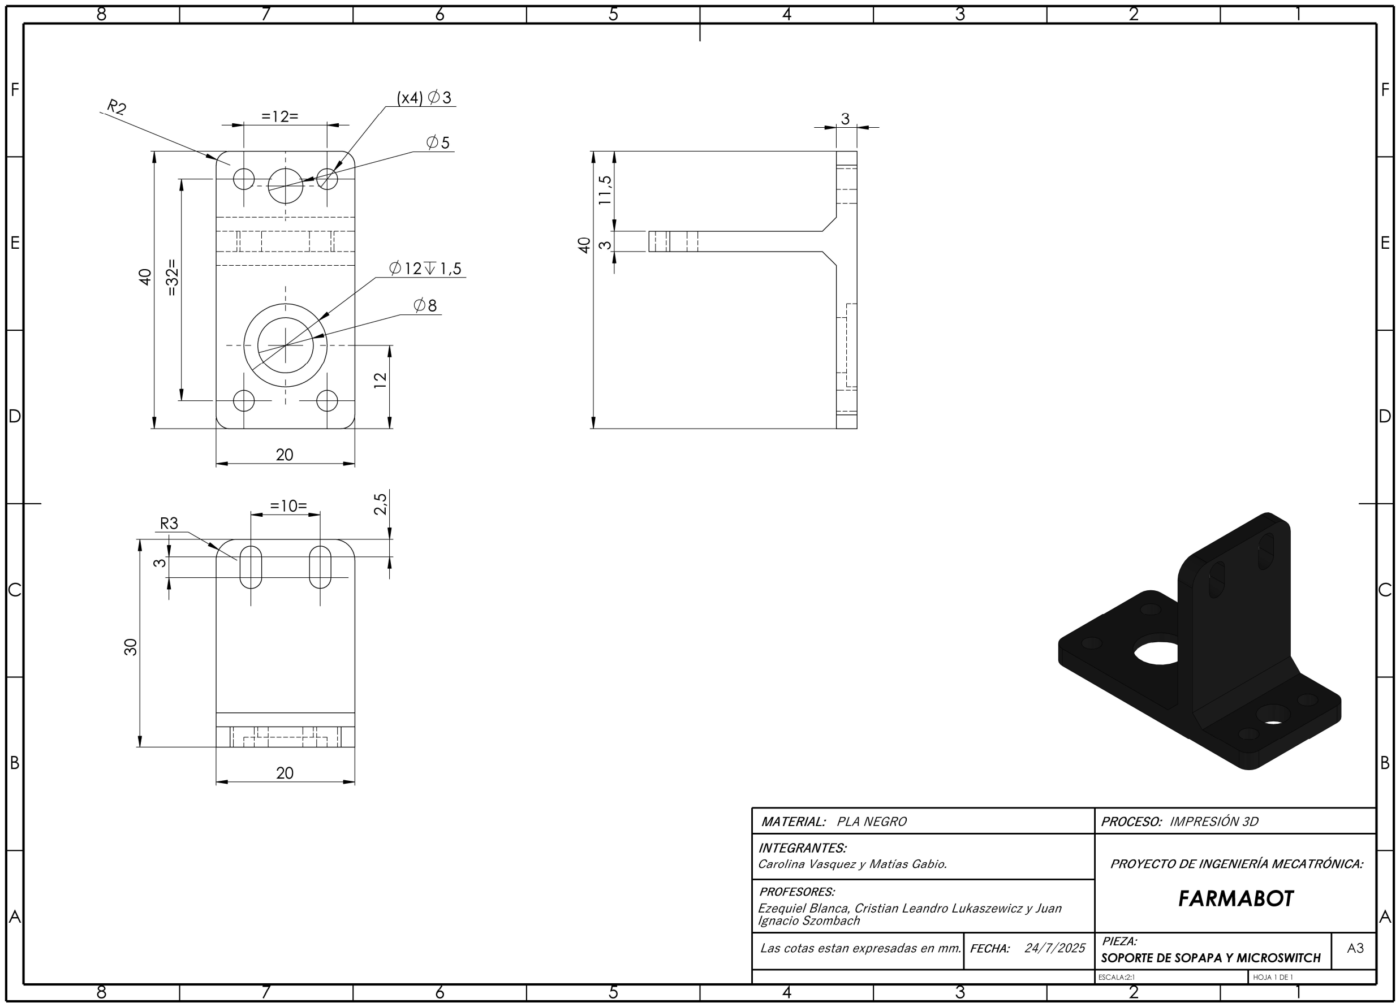
[picture p72: page 1]
