CarolinaVasquez2000/FarmaBot/Planos e informacion mécanica/Planos Mecanicos/14 - DISTANCIADOR DE VARILLAS DERECHO.pdf

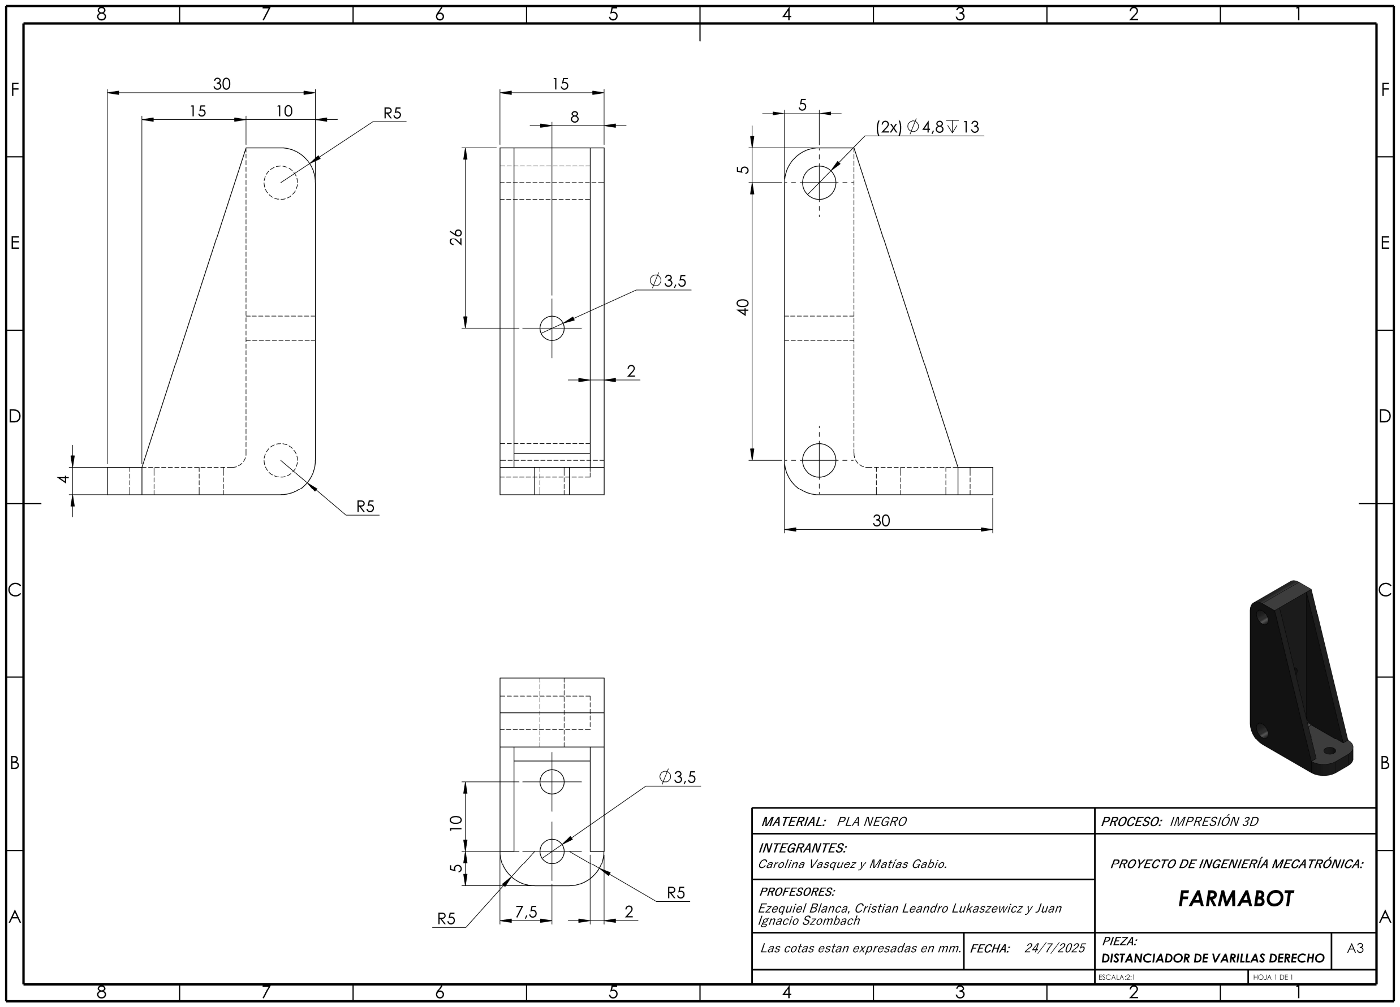
[picture p73: page 1]
