CarolinaVasquez2000/FarmaBot/Planos e informacion mécanica/Planos Mecanicos/15 - DISTANCIADOR DE VARILLAS IZQUIERDO.pdf

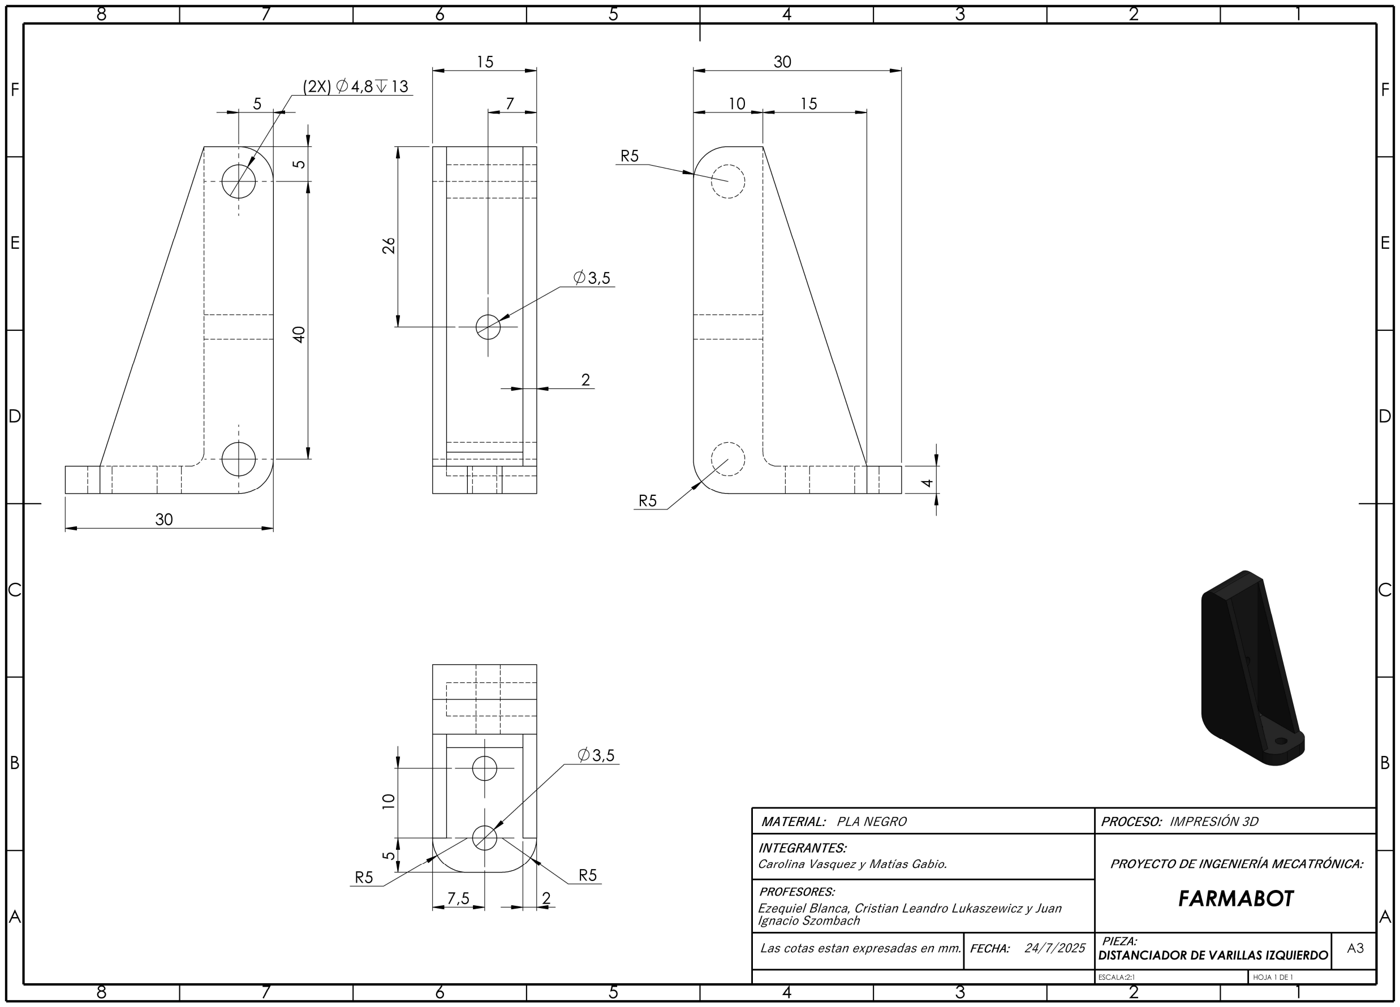
[picture p74: page 1]
