CarolinaVasquez2000/FarmaBot/Planos e informacion mécanica/Planos Mecanicos/16 - SOPORTE DE MOTOR.pdf

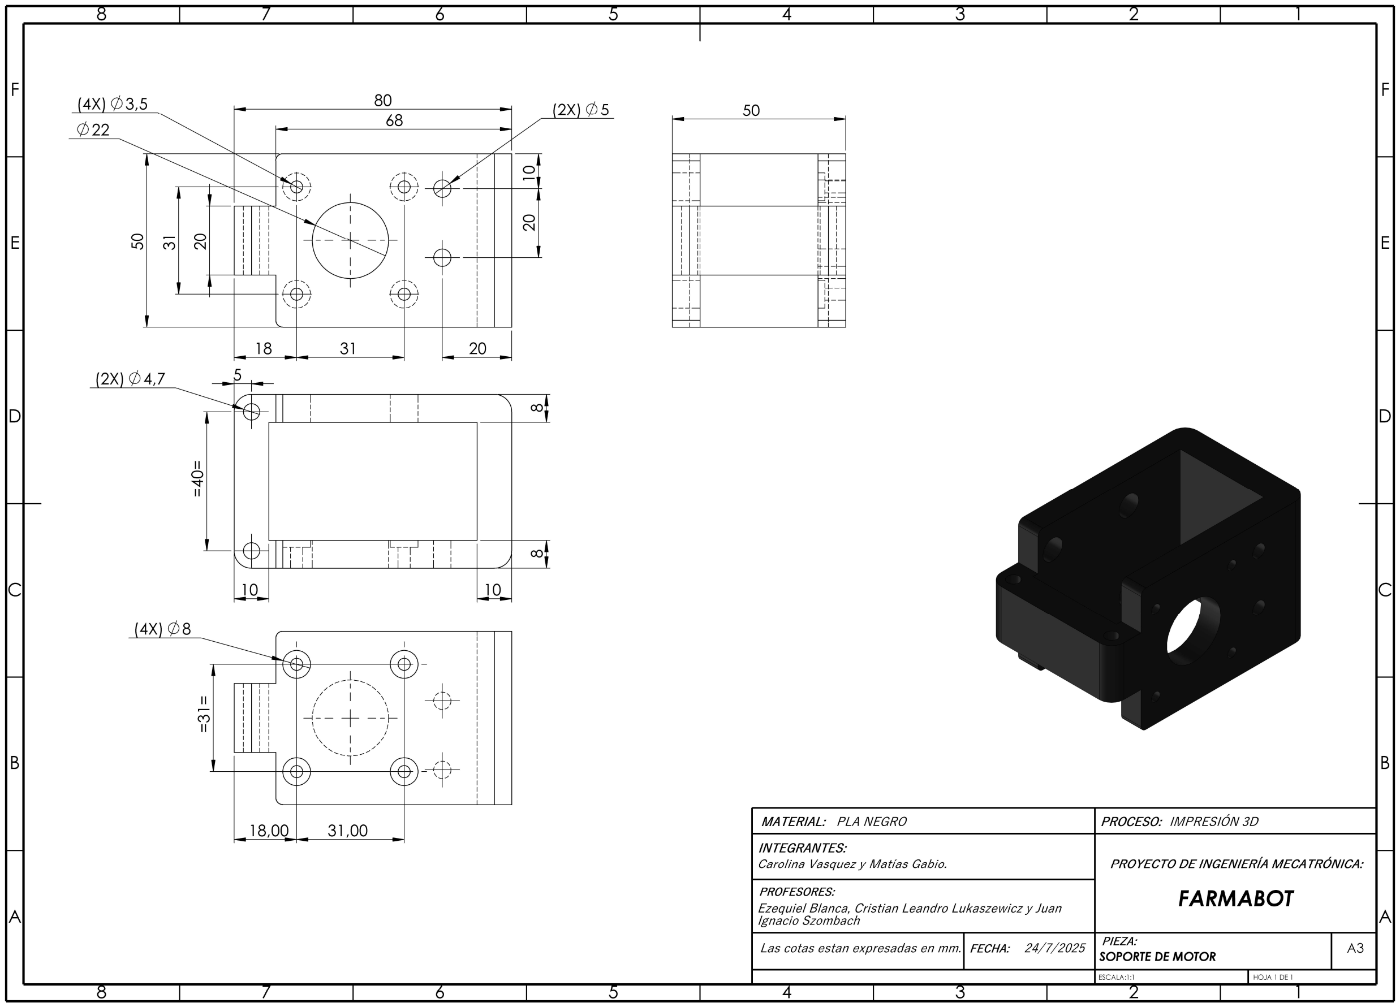
[picture p75: page 1]
