CarolinaVasquez2000/FarmaBot/Planos e informacion mécanica/Planos Mecanicos/17 - UNION DE VARILLAS.pdf

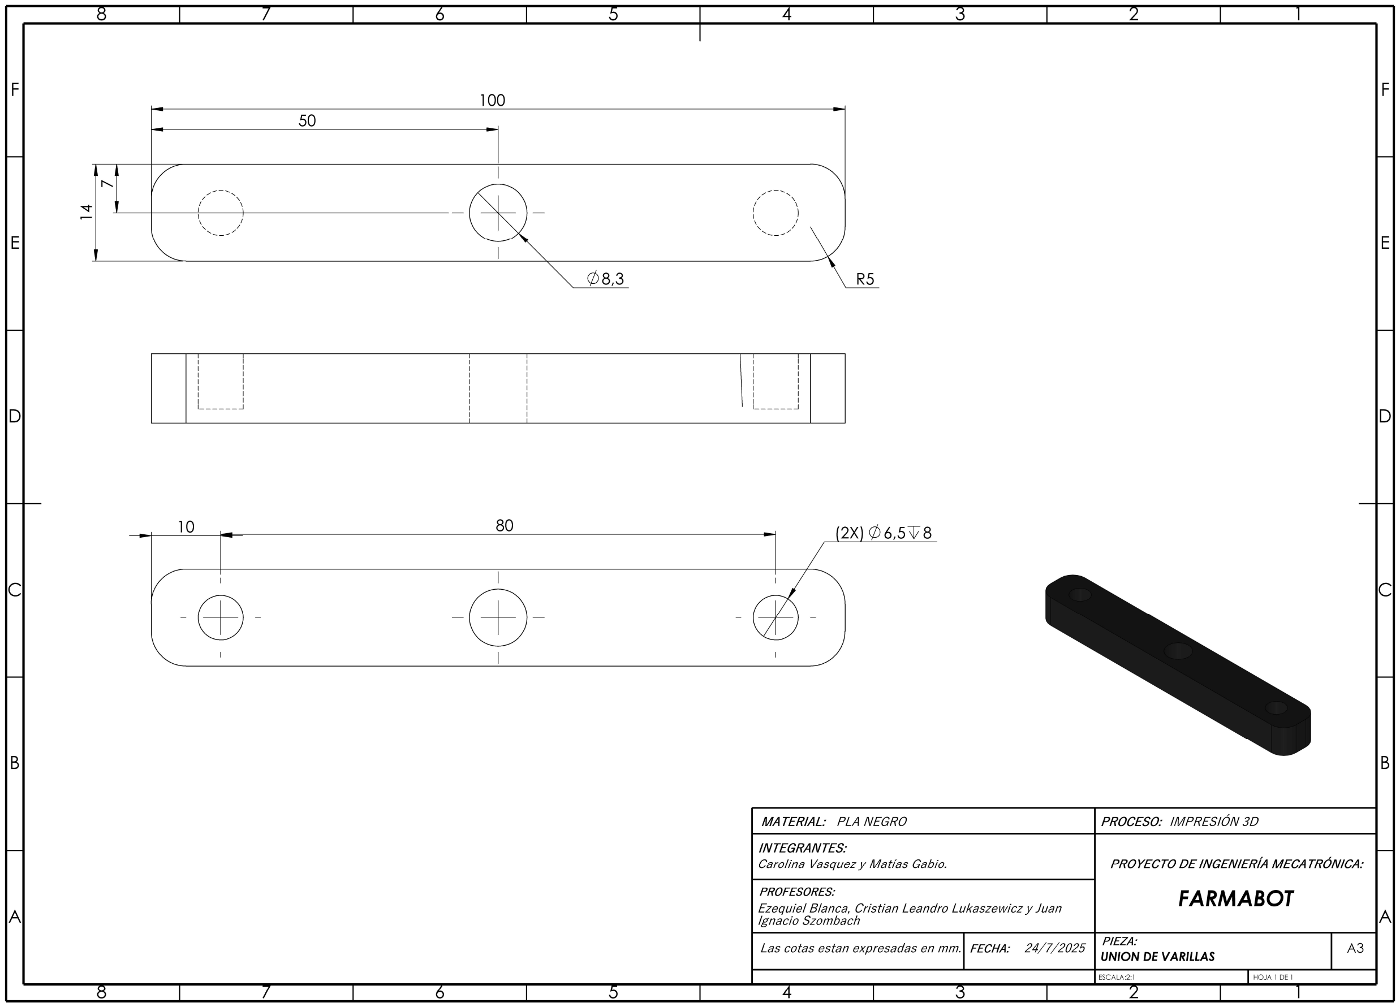
[picture p76: page 1]
