CarolinaVasquez2000/FarmaBot/Planos e informacion mécanica/Planos Mecanicos/18 - SOPORTE DE ESP 32 CAM.pdf

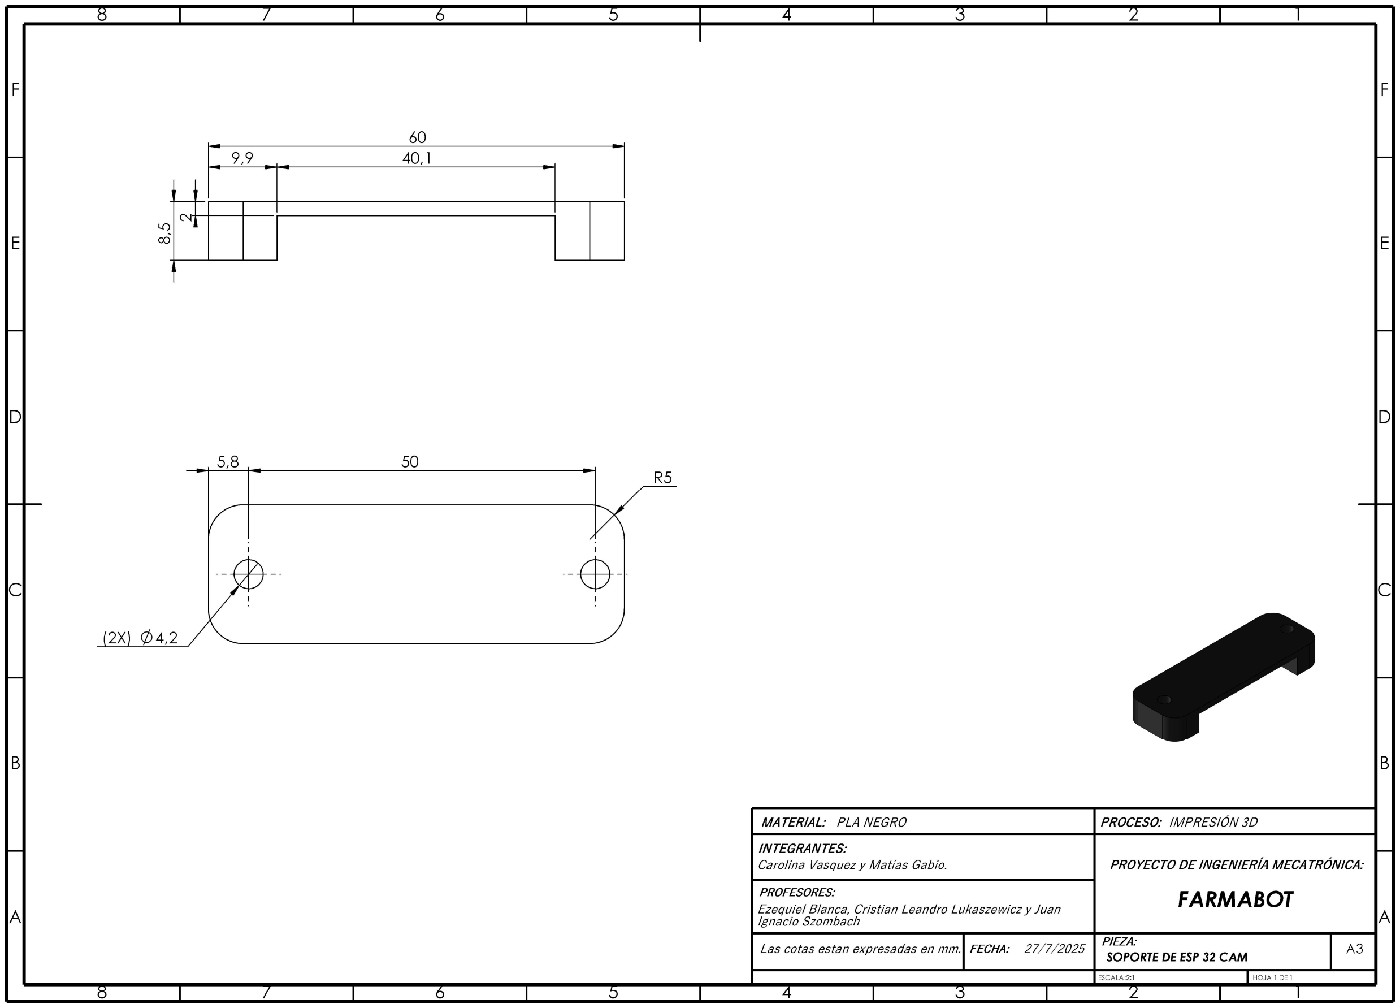
[picture p77: page 1]
