CarolinaVasquez2000/FarmaBot/Planos e informacion mécanica/Planos Mecanicos/19 - SOPORTE DE MICROSWITCH.pdf

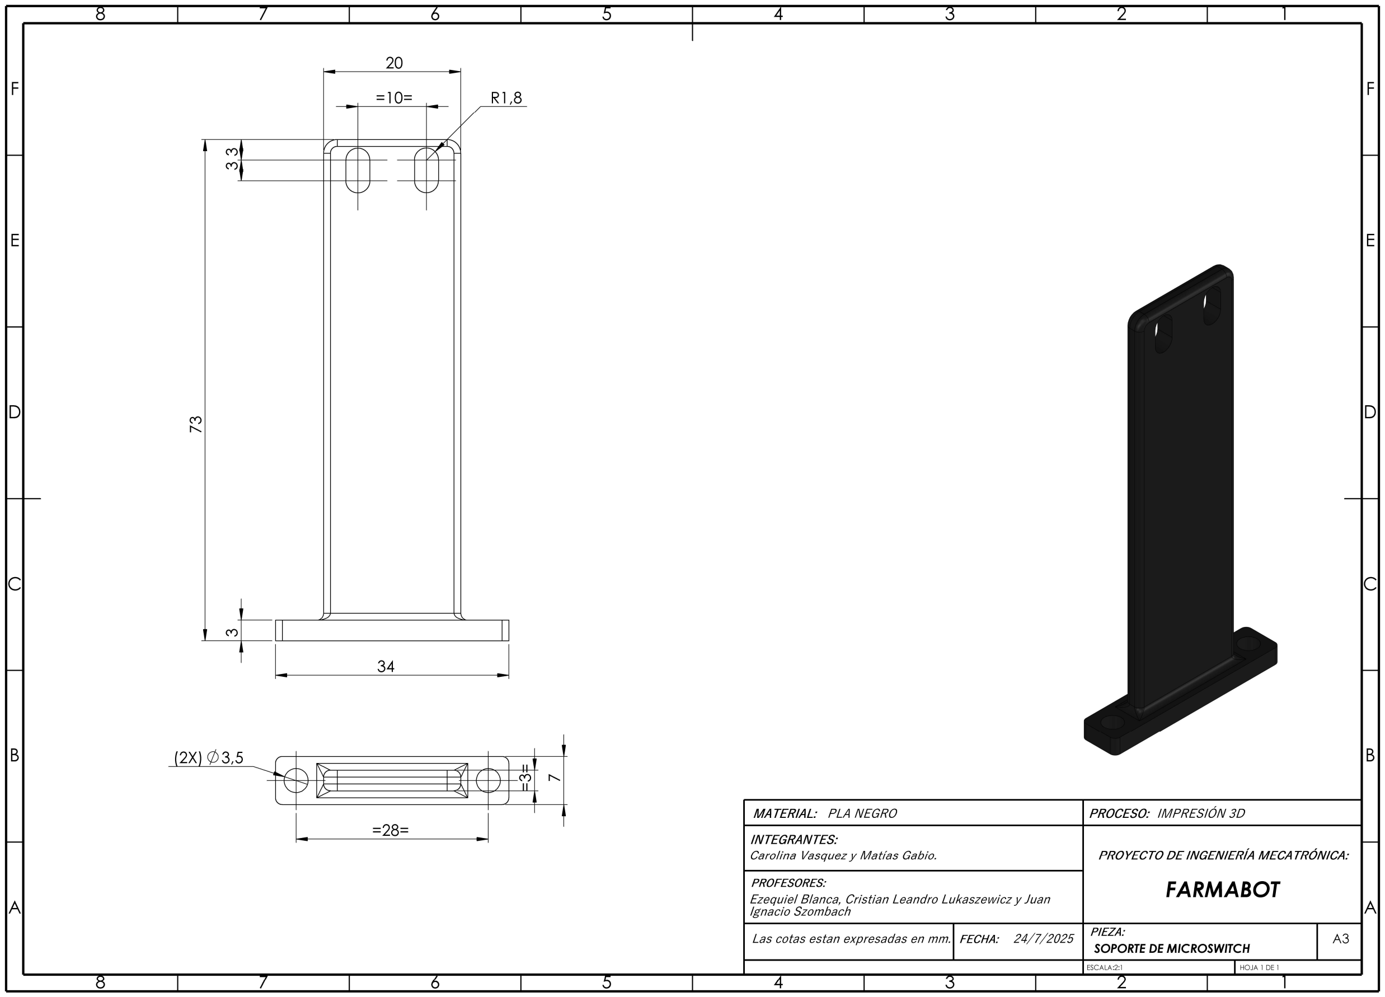
[picture p78: page 1]
