CarolinaVasquez2000/FarmaBot/Planos e informacion mécanica/Planos Mecanicos/20 - AISLANTE PLACA.pdf

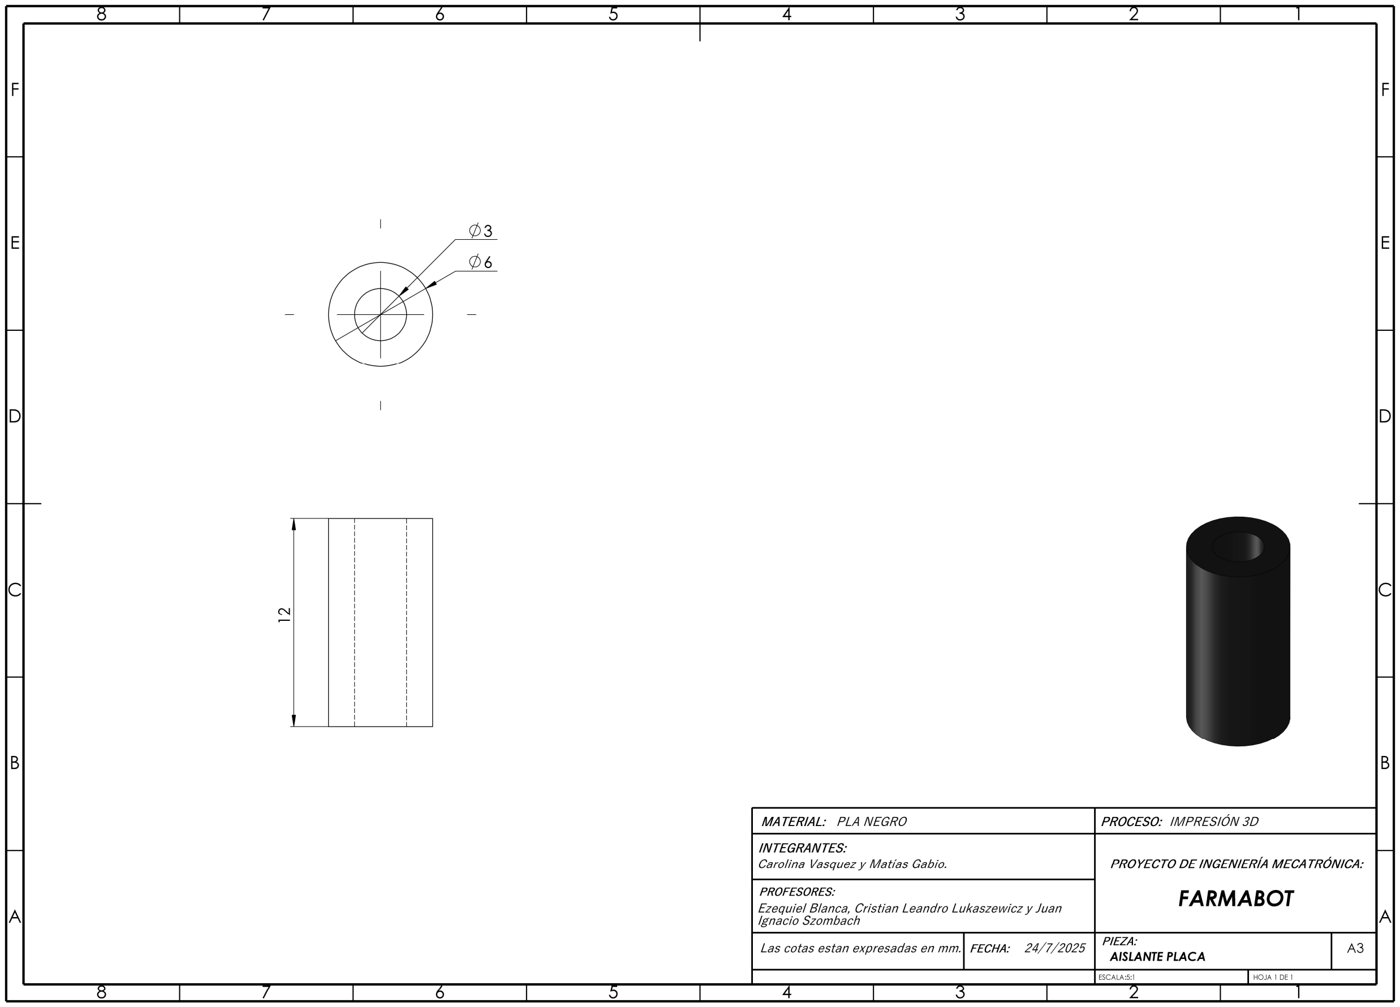
[picture p79: page 1]
