CarolinaVasquez2000/FarmaBot/Planos e informacion mécanica/Planos Mecanicos/21 - TAPA SUPERIOR.pdf

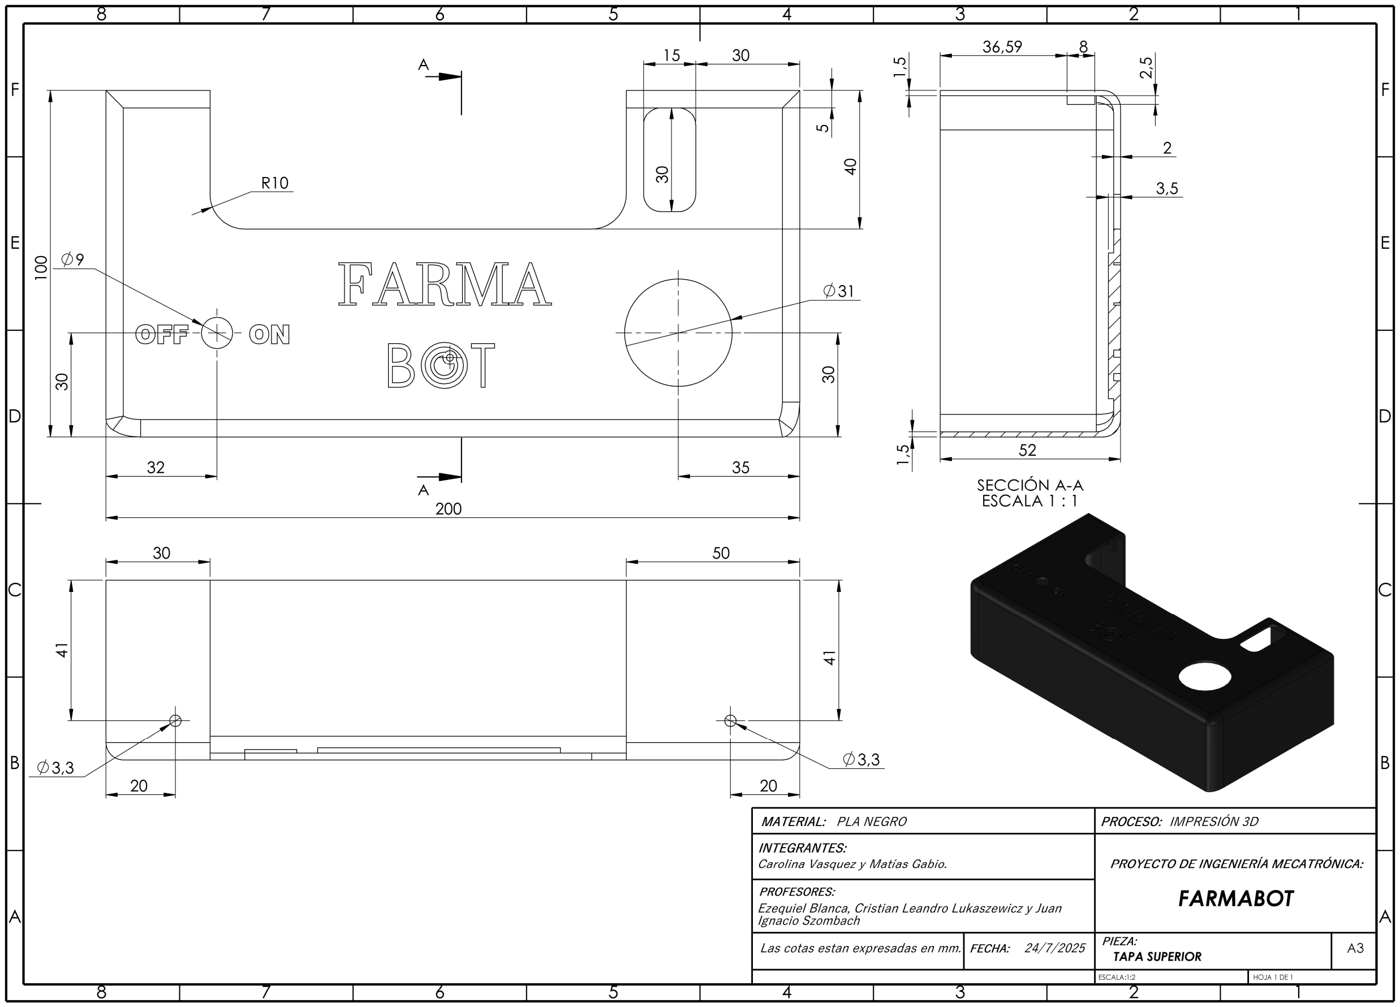
[picture p80: page 1]
