CarolinaVasquez2000/FarmaBot/Planos e informacion mécanica/Planos Mecanicos/22 - SOPORTE BATERIA.pdf

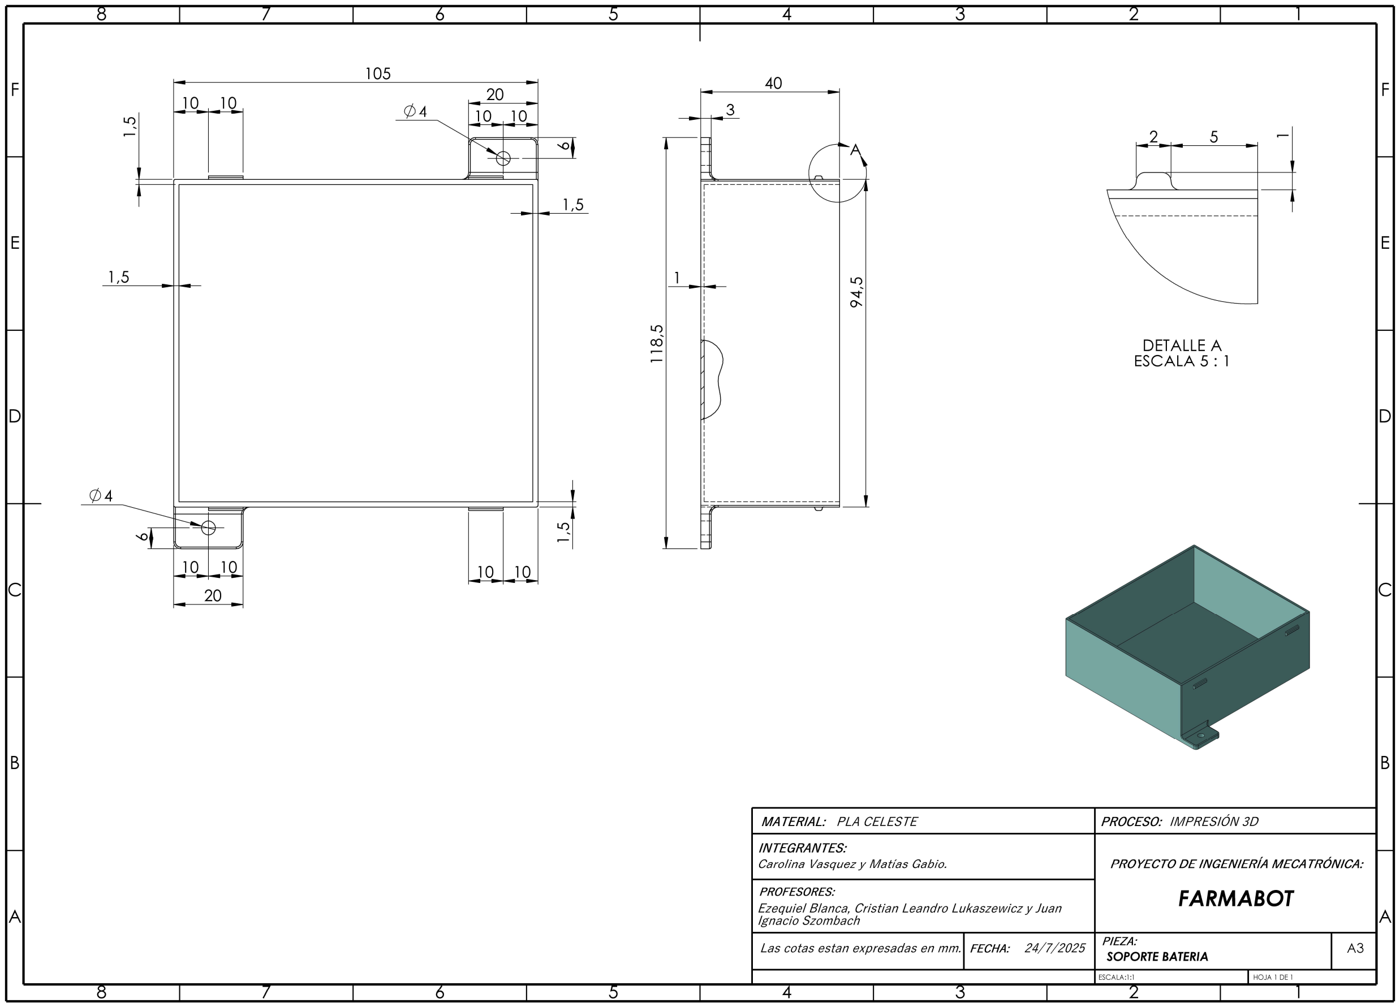
[picture p81: page 1]
