CarolinaVasquez2000/FarmaBot/Planos e informacion mécanica/Planos Mecanicos/23 - TAPA DE SOPORTE DE BATERIA.pdf

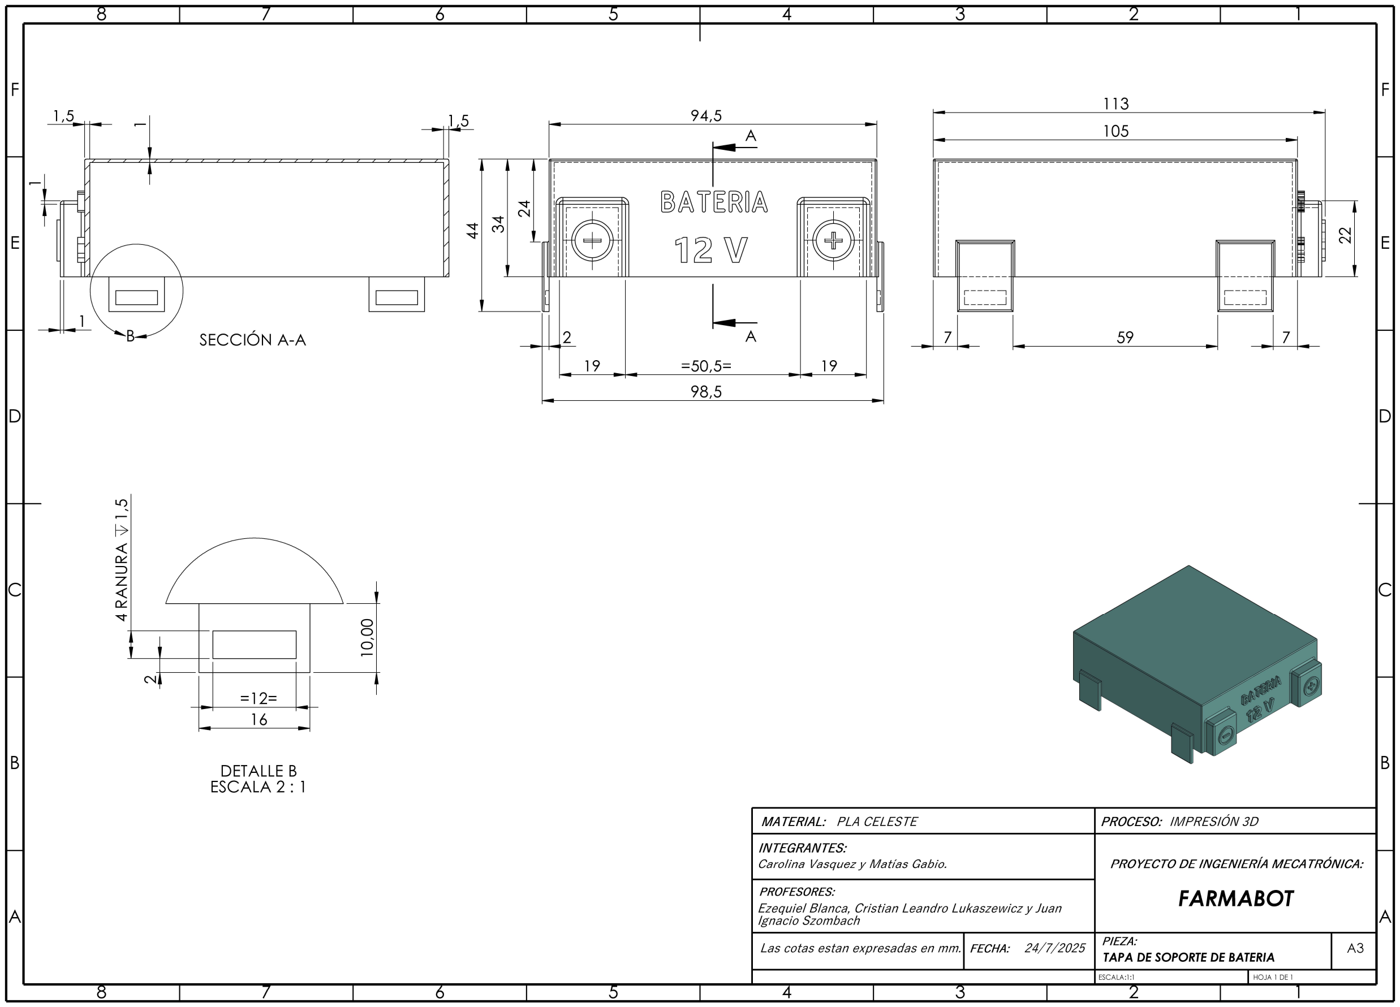
[picture p82: page 1]
