CarolinaVasquez2000/FarmaBot/Planos e informacion mécanica/Planos Mecanicos/24 - TAPA DE SENSORES TRANSPARENTE.pdf

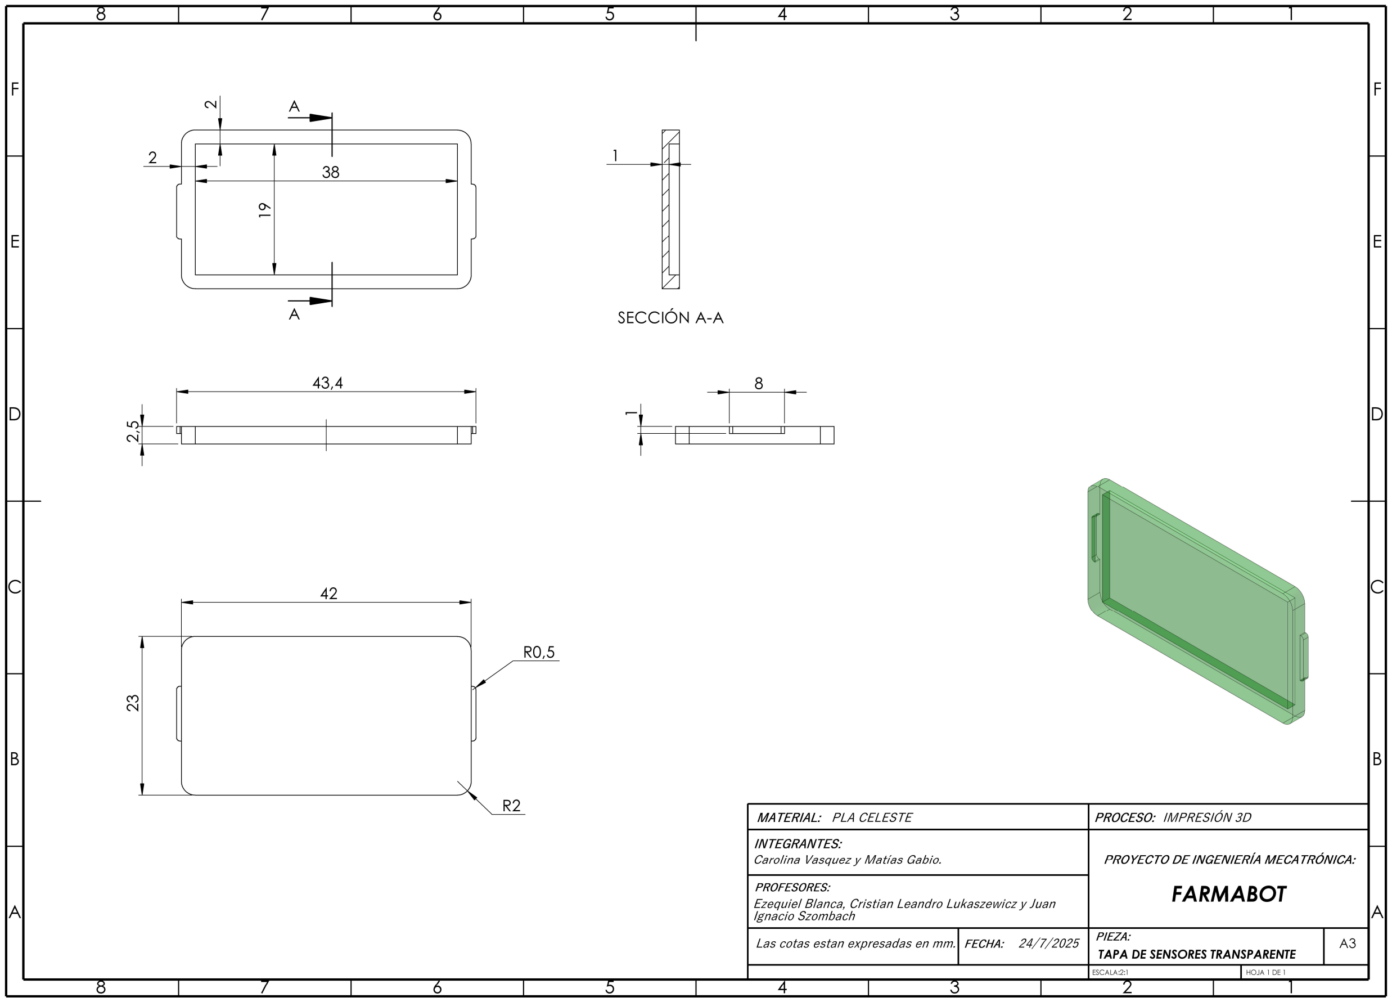
[picture p83: page 1]
