CarolinaVasquez2000/FarmaBot/Planos e informacion mécanica/Planos Mecanicos/25 - VARILLA DE GUIA ASCENSO.pdf

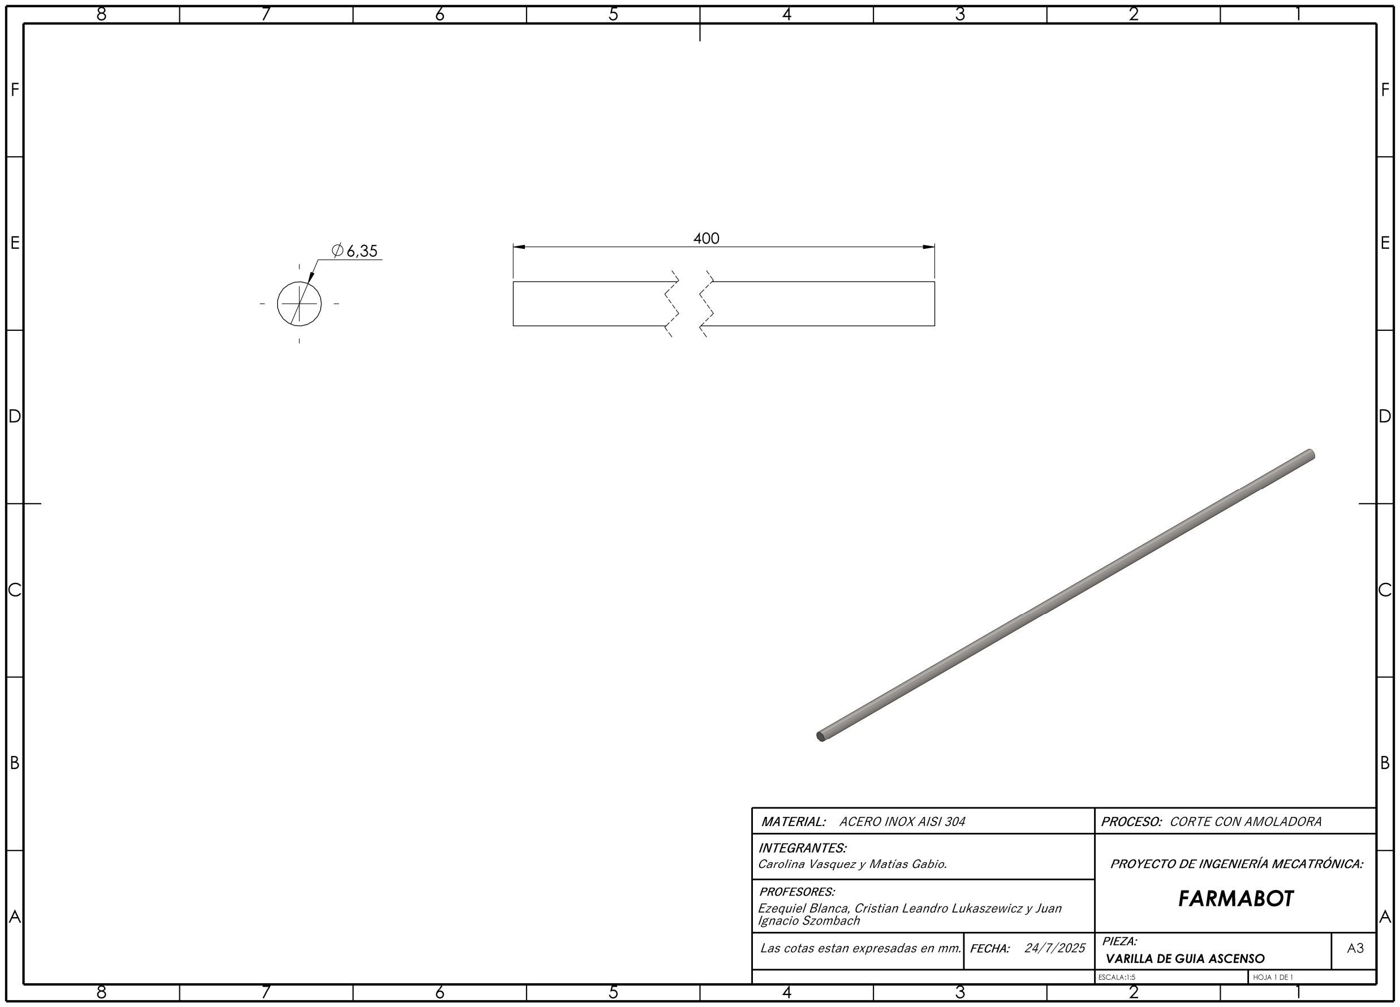
[picture p84: page 1]
