CarolinaVasquez2000/FarmaBot/Planos e informacion mécanica/Planos Mecanicos/26 - VARILLA DE GUIA TRASLACION.pdf

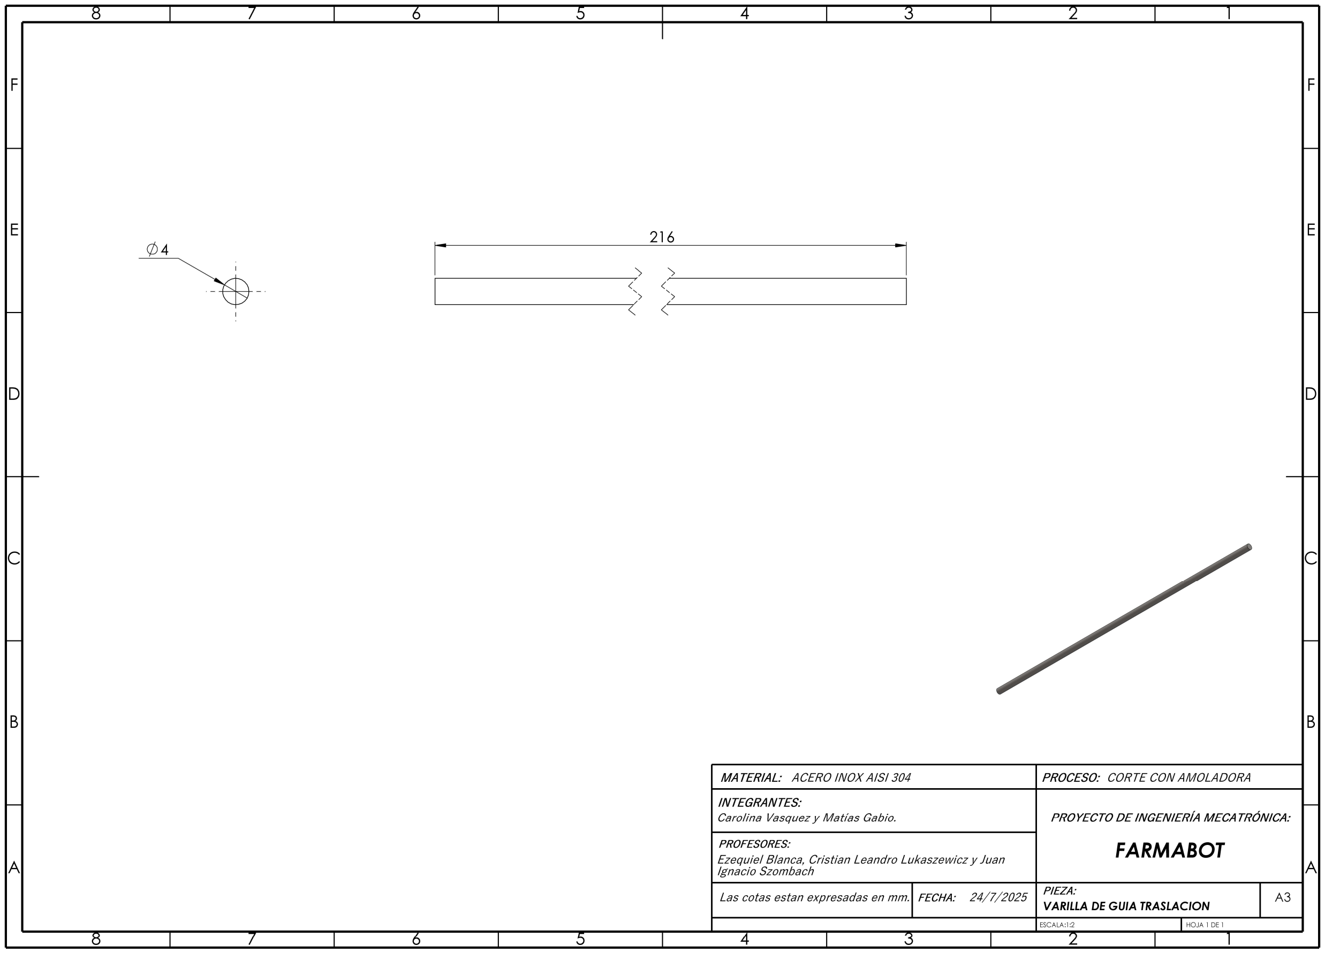
[picture p85: page 1]
