CarolinaVasquez2000/FarmaBot/Imagenes y videos/CARRO CON ESTANTERIA IMAGEN DEL VIDEO.jpg

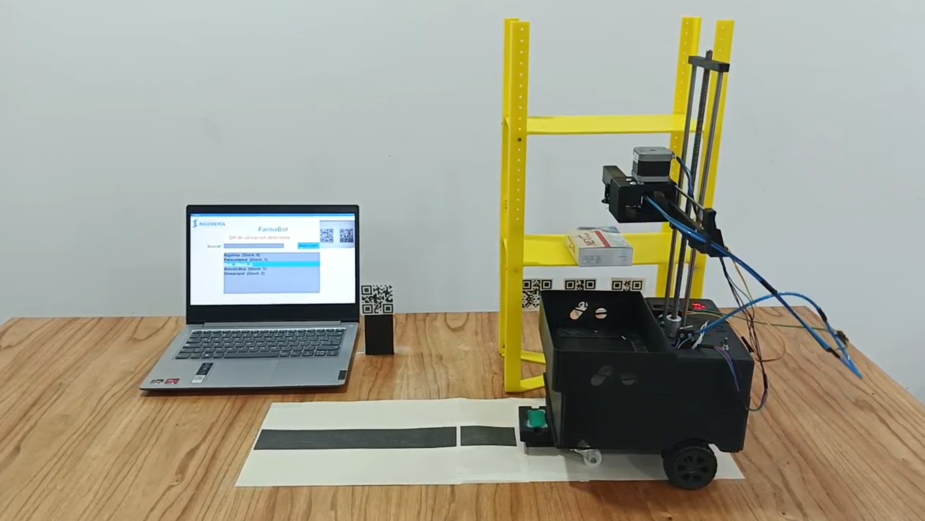
Imagenes y videos/CARRO CON ESTANTERIA IMAGEN DEL VIDEO.jpg
