CarolinaVasquez2000/FarmaBot/Imagenes y videos/FARMABOT IMAGEN REAL (1).jpeg

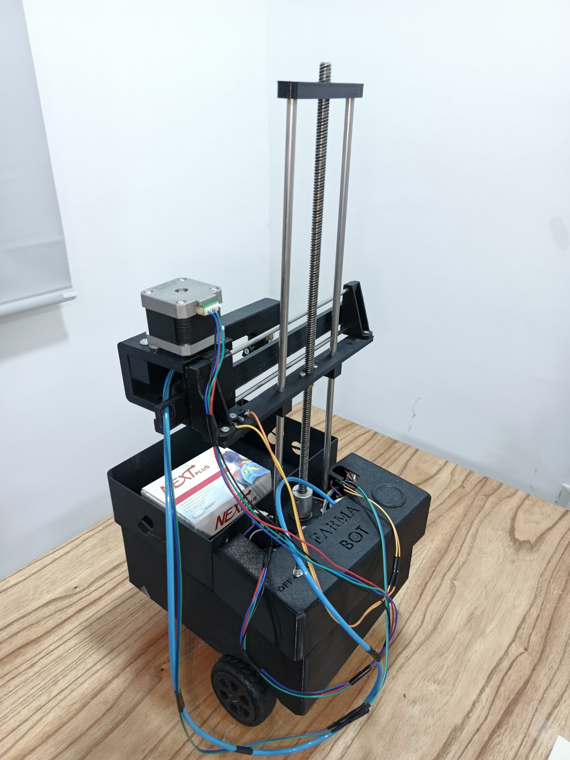
Imagenes y videos/FARMABOT IMAGEN REAL (1).jpeg
