CarolinaVasquez2000/FarmaBot/Imagenes y videos/FARMABOT IMAGEN REAL (2).jpeg

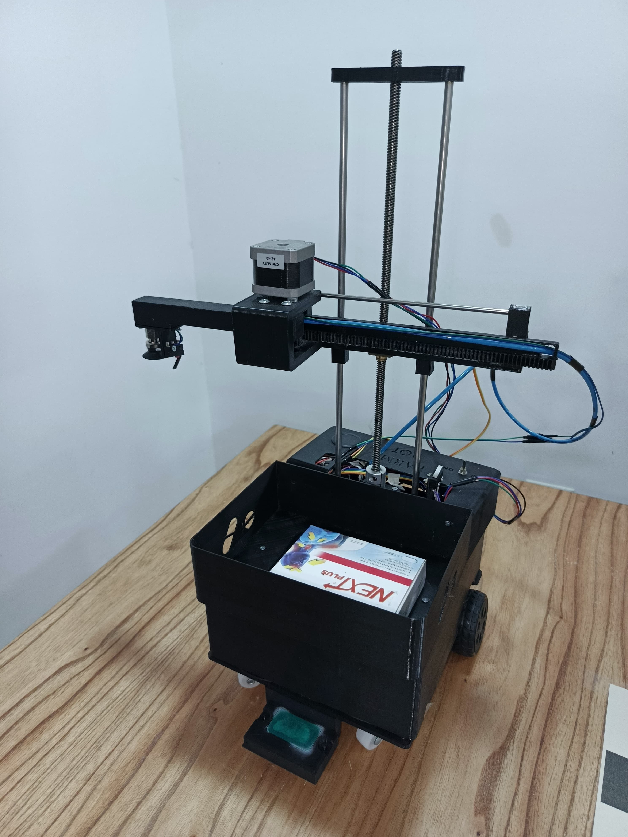
Imagenes y videos/FARMABOT IMAGEN REAL (2).jpeg
