CarolinaVasquez2000/FarmaBot/Imagenes y videos/FARMABOT IMAGEN REAL (3).jpeg

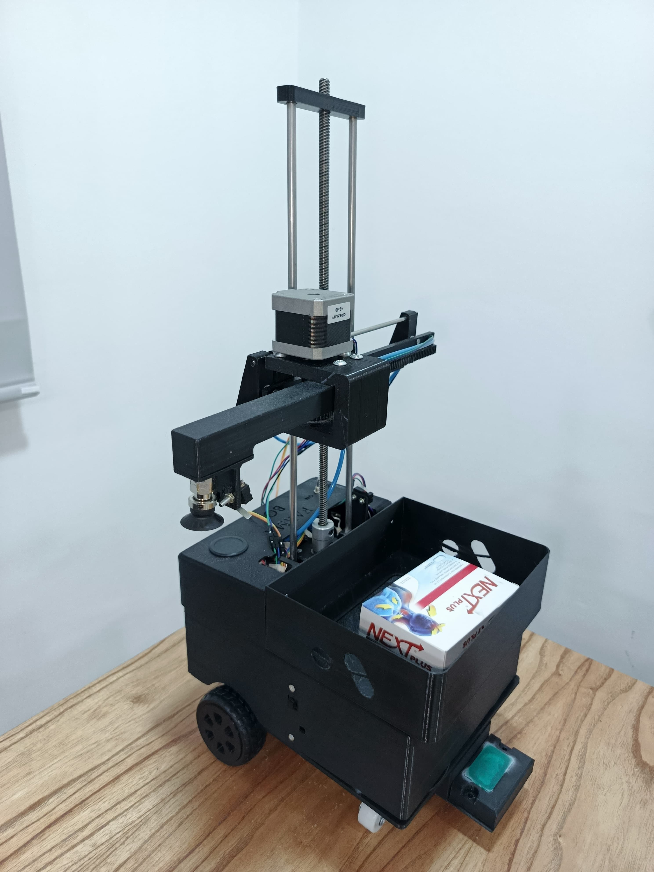
Imagenes y videos/FARMABOT IMAGEN REAL (3).jpeg
