CarolinaVasquez2000/FarmaBot/Imagenes y videos/FARMABOT IMAGEN REAL (4).jpeg

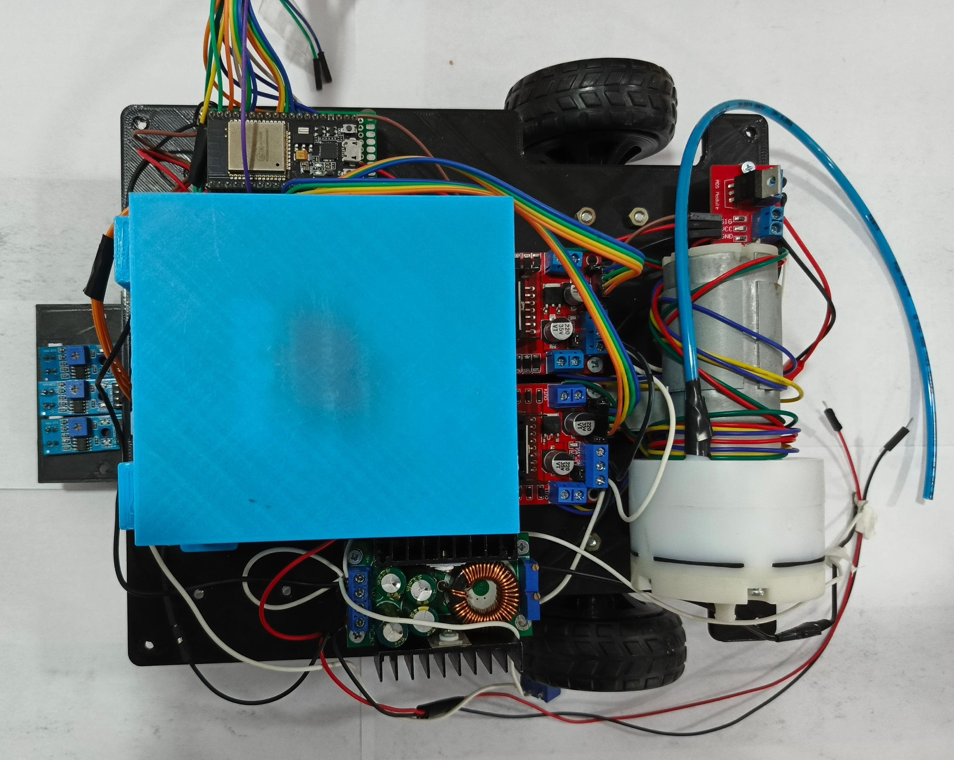
Imagenes y videos/FARMABOT IMAGEN REAL (4).jpeg
