CarolinaVasquez2000/FarmaBot/Imagenes y videos/FARMABOT IMAGEN REAL (5).jpeg

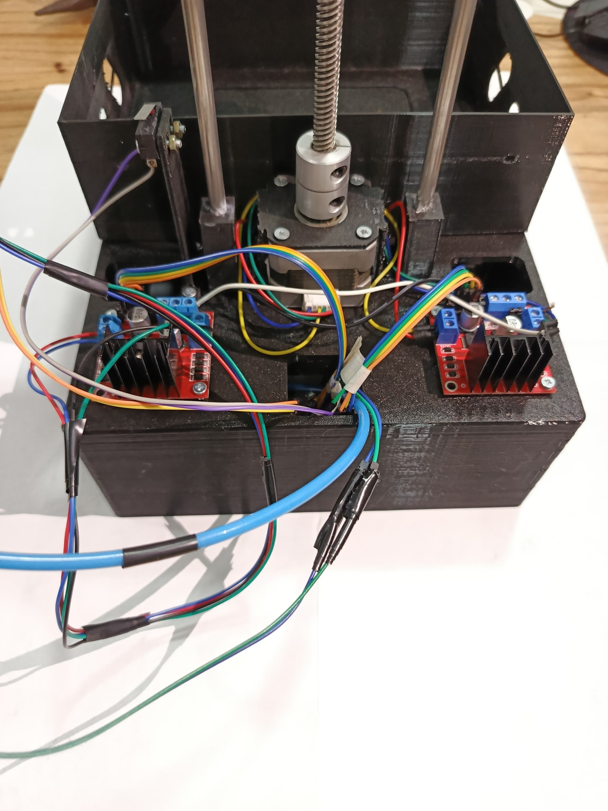
Imagenes y videos/FARMABOT IMAGEN REAL (5).jpeg
