CarolinaVasquez2000/FarmaBot/Imagenes y videos/FARMABOT IMAGEN REAL (6).jpeg

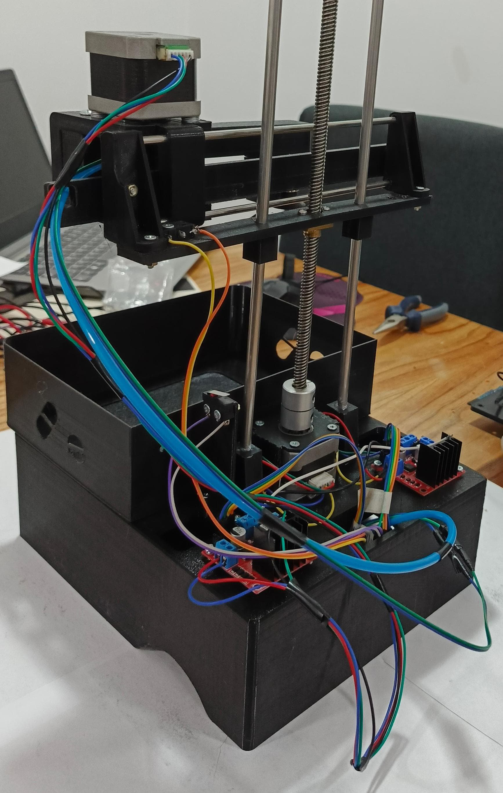
Imagenes y videos/FARMABOT IMAGEN REAL (6).jpeg
