CarolinaVasquez2000/FarmaBot/Planos e información eléctrica/Especificación técnica de productos comerciales eléctricos/34 - SENSOR TCRT5000L.jpg

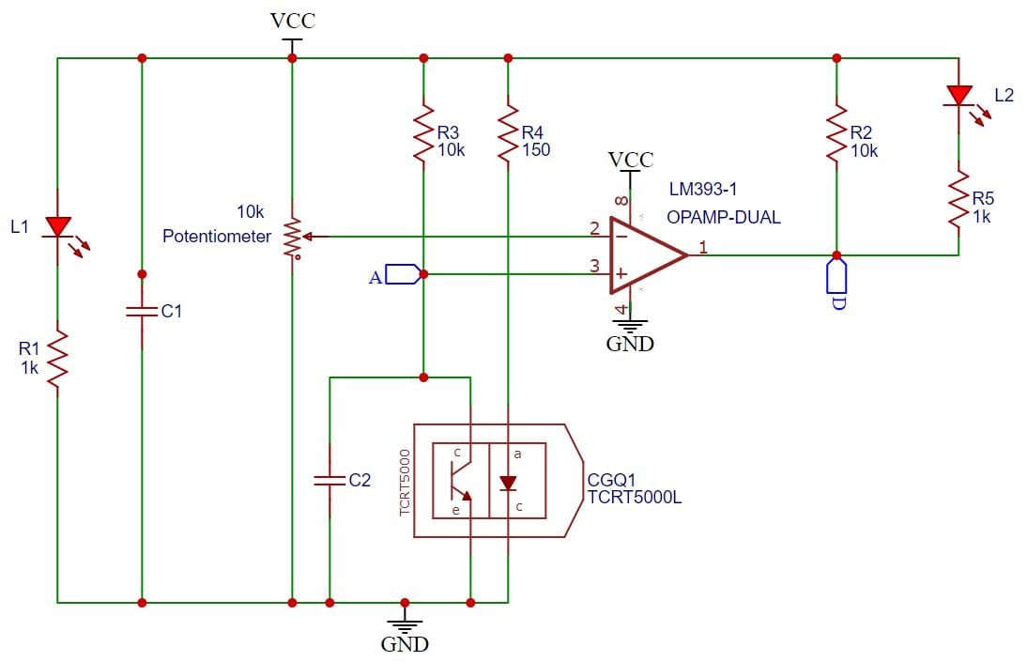
Planos e información eléctrica/Especificación técnica de productos comerciales eléctricos/34 - SENSOR TCRT5000L.jpg
