CarolinaVasquez2000/FarmaBot/Documentos/MANUAL DE USUARIO.pdf

## MANUAL DE USUARIO

# MANUAL DE USUARIO

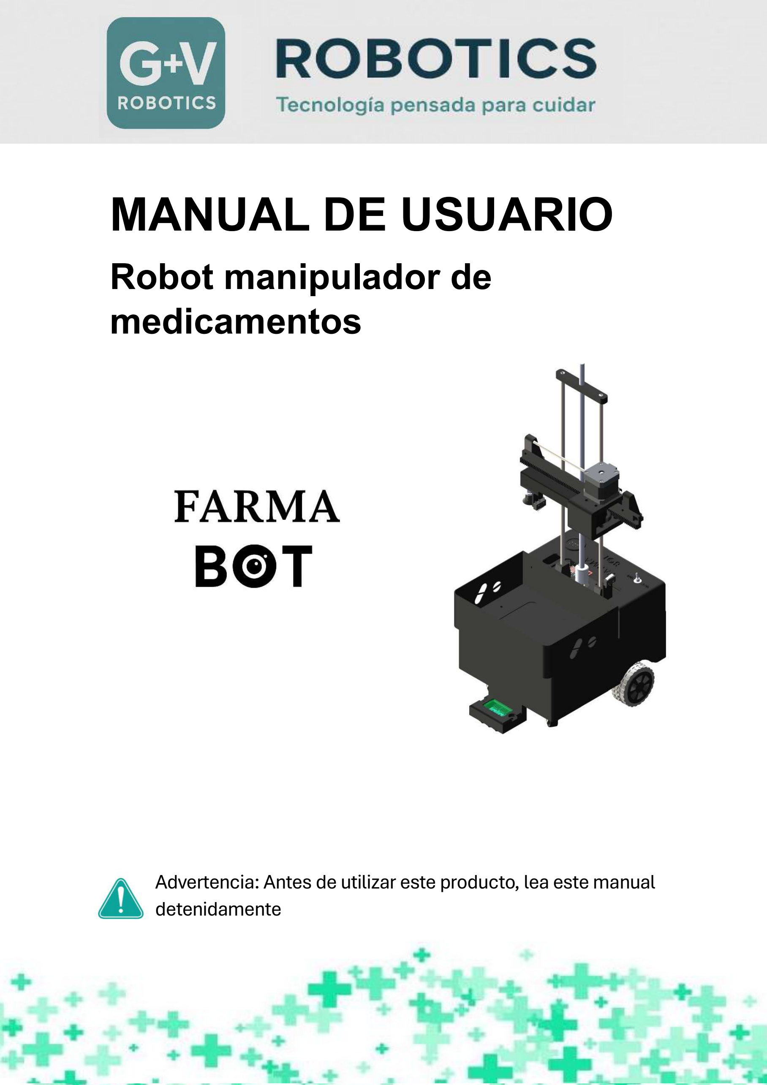
[picture p94: page 1]

1

# Robot manipulador de medicamentos

## Advertencia: Antes de utilizar este producto, lea este manual detenidamente

2

## ÍNDICE

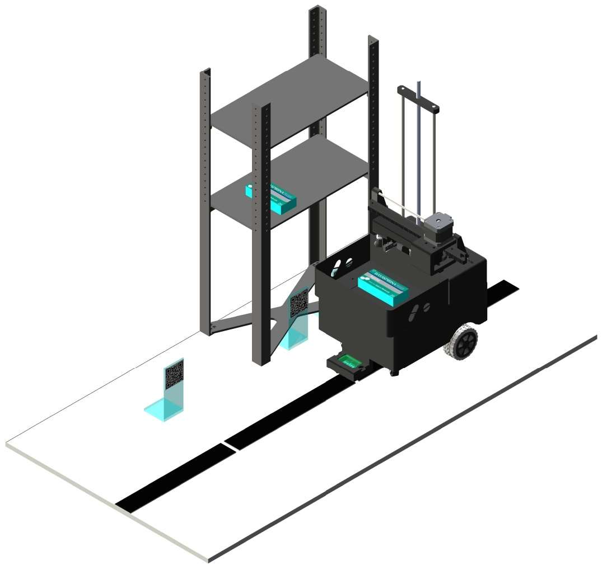
[picture p95: figure]

3

## 1. Introducción

Gracias por adquirir el robot de entrega de medicamentos FarmaBot de G & V. Este dispositivo ha sido desarrollado para facilitar la entrega segura, automatizada y eficiente de medicamentos en farmacias. Este manual le proporcionará toda la información necesaria para su correcta utilización.

## 2. Objetivos del sistema

- Asistir al farmacéutico en la recolección automatizada.
- Reducir tiempos muertos y mejorar la eficiencia.
- Automatizar el traslado de medicamentos desde estanterías hasta la zona de recepción.
- Enfocar el tiempo humano en la atención al cliente.

## 3. Descripción del producto

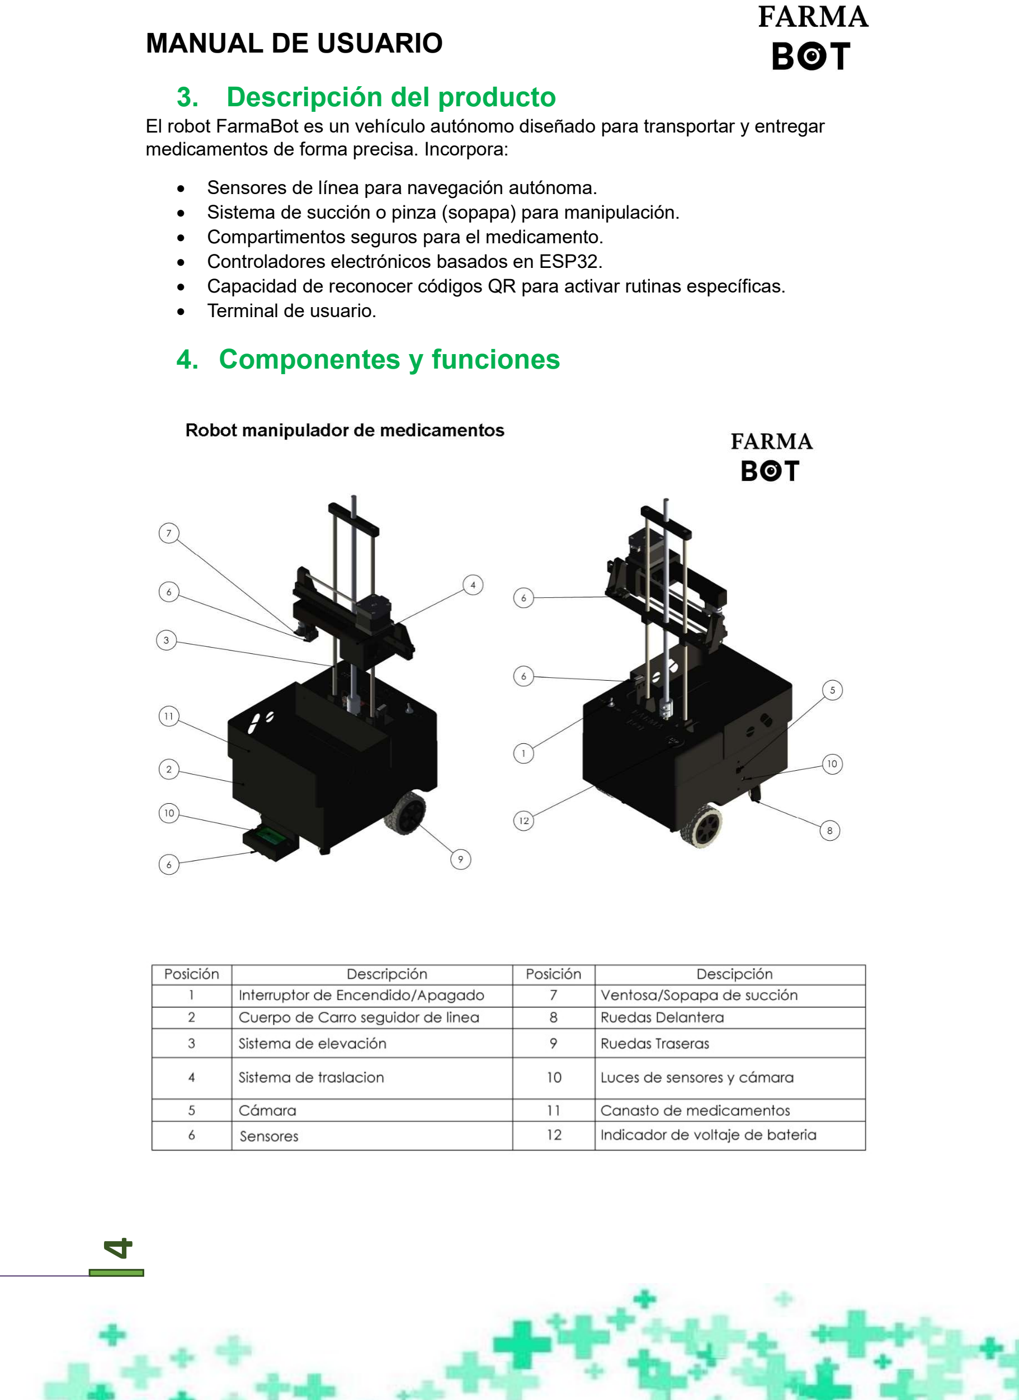
[picture p96: page 4]

4

El robot FarmaBot es un vehículo autónomo diseñado para transportar y entregar medicamentos de forma precisa. Incorpora:
- Sensores de línea para navegación autónoma.
- Sistema de succión o pinza (sopapa) para manipulación.
- Compartimentos seguros para el medicamento.
- Controladores electrónicos basados en ESP32.
- Capacidad de reconocer códigos QR para activar rutinas específicas.
- Terminal de usuario.

## 4. Componentes y funciones

5

## 5. Instrucciones de uso

### 1. Colocar los medicamentos en las estanterías, cargar en el archivo CSV el stock

y ubicación de cada medicamento.

### 2. Colocar los QR de cada ubicación para los medicamentos y un QR para la

ubicación de la recepción del medicamento (donde se encontrará el farmacéutico que lo recibirá)
3. Alinear el botor en la línea de guía del recorrido.
4. Verificar conexión wifi y comunicación con la PC.
5. Encender el robot con el interruptor de encendido.
6. Esperar la rutina de inicialización.

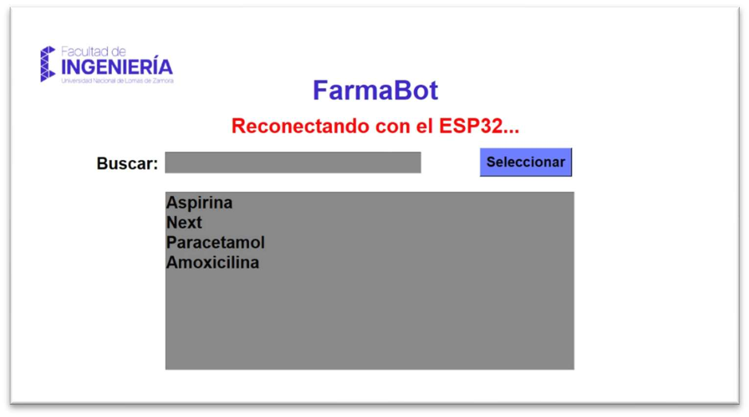
[picture p97: figure]

7. Enviar el comando del robot mediante la terminal.

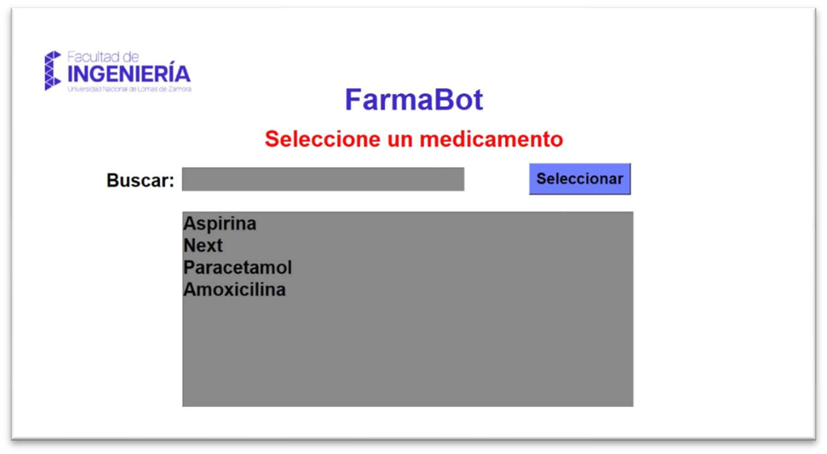
[picture p98: figure]

### 8. El robot comenzará el recorrido y reconocerá el código QR en el destino y

entregará el medicamento en el QR de recepción.
9. El robot indicara que el recorrido finalizo en la terminal.

6

## 6. Mantenimiento

- Limpieza semanal del sensor y caja.
- Verificar estado de las ruedas.
- Comprobar batería y conexiones.

## 7. Seguridad

- No operar en superficies mojadas.
- Solo cargar cajas de medicamentos (el robot no está pensado para levantar frascos, jeringas, etc.).
- No interponerse en la ruta del robot.
- No manipular el robot encendido.

## 8. Solución de problemas

Problema | Posible causa | Solución
El robot no enciende | Batería descargada | Recargar batería
No sigue la línea | Sensor sucio o mal calibrado | Limpiar sensor o recalibrar
No toma el medicamento | Falla en la sopapa | Verificar vacío y conexión
No conecta a WiFi | SSID mal configurado, señal débil | Verificar red, reiniciar módulo, reconfigurar WiFi con código nuevo

## 9. Especificaciones técnicas

- Dimensiones: 281 x 251 x 575 mm
- Peso: 4,3 kg
- Autonomía: 60 minutos
- Voltaje: 12V
- Controlador: ESP32
- Comunicación WiFi
- Motores: DC + Motor paso a paso
- Capacidad: 2 cajas de medicamentos apiladas

G & V Robotics. Dirección: Buenos Aires, Argentina.
