CarolinaVasquez2000/FarmaBot/Documentos/DIAGRAMA DE FLUJO .pdf

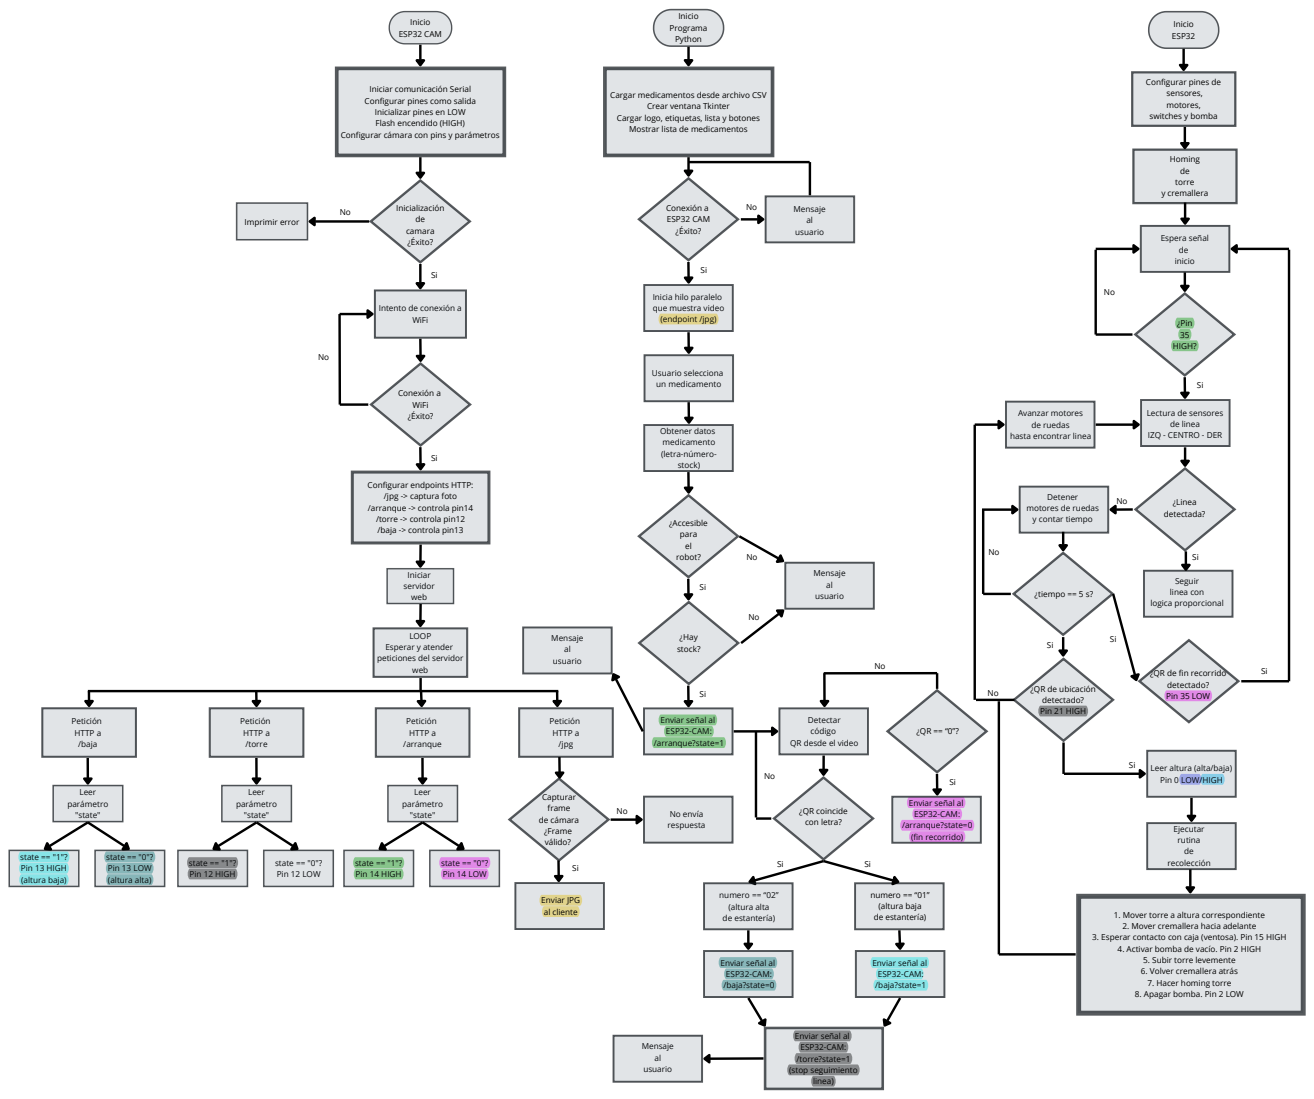
[picture p99: page 1]
Inicialización de camara ¿Éxito?; Imprimir error; Iniciar servidor; web; Inicio ESP32 CAM; Inicio Programa Python; Usuario selecciona un medicamento; ¿Accesible para el robot?; Obtener datos medicamento (letra-número- stock); ¿Hay stock?; Mensaje; Conexión a ESP32 CAM ¿Éxito?; Petición HTTP a; /jpg; Capturar frame de cámara ¿Frame válido?; Enviar JPG al cliente; No envía respuesta; /arranque; Leer parámetro; "state"; /torre; /baja; (altura baja); (altura alta); Mensaje al usuario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

Iniciar comunicación Serial
Configurar pines como salida
Inicializar pines en LOW
Flash encendido (HIGH)

Configurar pines de
sensores, motores,

Cargar medicamentos desde archivo CSV

Crear ventana Tkinter
Cargar logo, etiquetas, lista y botones
Mostrar lista de medicamentos

Configurar cámara con pins y parámetros

al usuario No

Inicia hilo paralelo
que muestra video
(endpoint /jpg)

Intento de conexión a WiFi

Conexión a WiFi ¿Éxito?

Avanzar motores de ruedas

Lectura de sensores
de linea
IZQ - CENTRO - DER

hasta encontrar linea

Configurar endpoints HTTP:
/jpg -> captura foto
/arranque -> controla pin14
/torre -> controla pin12
/baja -> controla pin13

detectada? No Detener motores de ruedas

LOOP
Esperar y atender
peticiones del servidor

¿QR de fin recorrido
detectado? Pin 35 LOW

¿QR de ubicación
detectado? Pin 21 HIGH

Enviar señal al ESP32-CAM: /arranque?state=1

QR desde el video

Leer altura (alta/baja) Pin 0 LOW/HIGH

Enviar señal al ESP32-CAM: /arranque?state=0

state == "1"? Pin 13 HIGH

state == "0"? Pin 13 LOW

state == "1"? Pin 12 HIGH

state == "0"? Pin 12 LOW

state == "1"? Pin 14 HIGH

state == "0"? Pin 14 LOW

1. Mover torre a altura correspondiente
2. Mover cremallera hacia adelante
3. Esperar contacto con caja (ventosa). Pin 15 HIGH
4. Activar bomba de vacío. Pin 2 HIGH
5. Subir torre levemente
6. Volver cremallera atrás
7. Hacer homing torre
8. Apagar bomba. Pin 2 LOW

Enviar señal al ESP32-CAM: /baja?state=0

Enviar señal al ESP32-CAM: /baja?state=1

Enviar señal al ESP32-CAM: /torre?state=1
