CarolinaVasquez2000/FarmaBot/Planos e informacion mécanica/Planos Mecanicos/03 - TAPA DE SENSORES.pdf

E E

F F

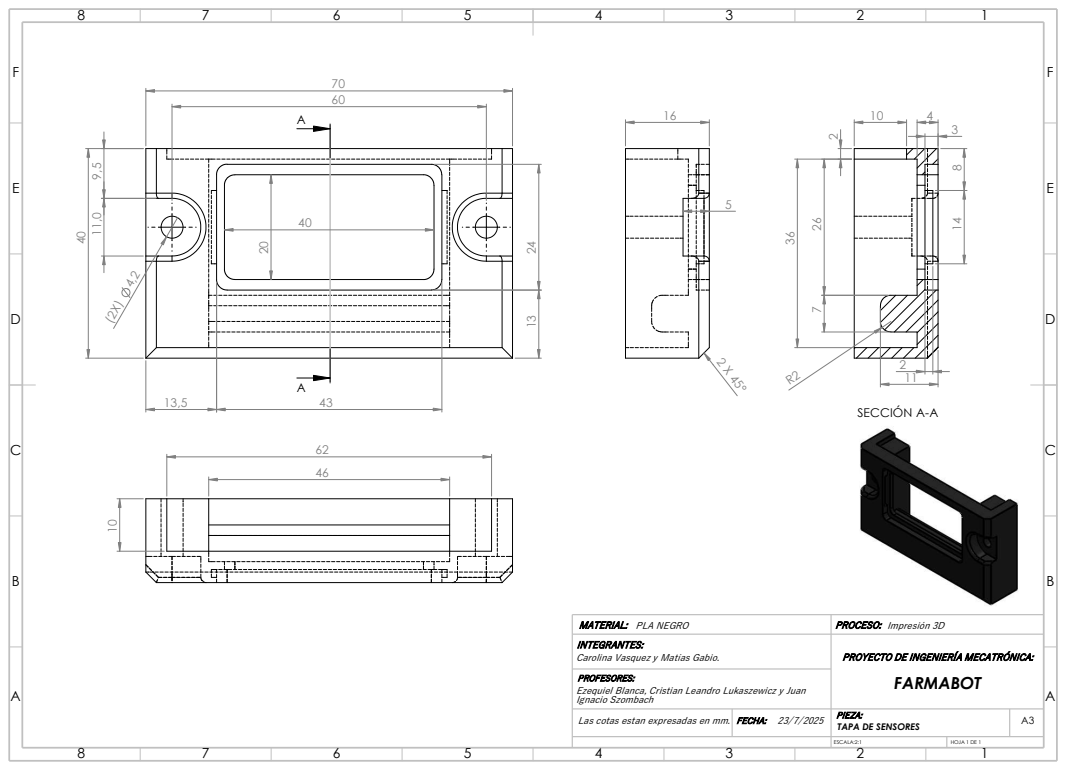
[picture p100: page 1]
Impresión 3D ²⁴; SECCIÓN A-A

MATERIAL: PLA NEGRO | PROCESO:
INTEGRANTES: Carolina Vasquez y Matías Gabio. | PROYECTO DE INGENIERÍA MECATRÓNICA: FARMABOT

PROFESORES:
Ezequiel Blanca, Cristian Leandro Lukaszewicz y Juan
Ignacio Szombach

23/7/2025 FECHA: | PIEZA: Las cotas estan expresadas en mm. TAPA DE SENSORES | A3

ESCALA:2:1 | HOJA 1 DE 1
