CarolinaVasquez2000/FarmaBot/Planos e información eléctrica/Especificación técnica de productos comerciales eléctricos/46 - ESP 32.pdf

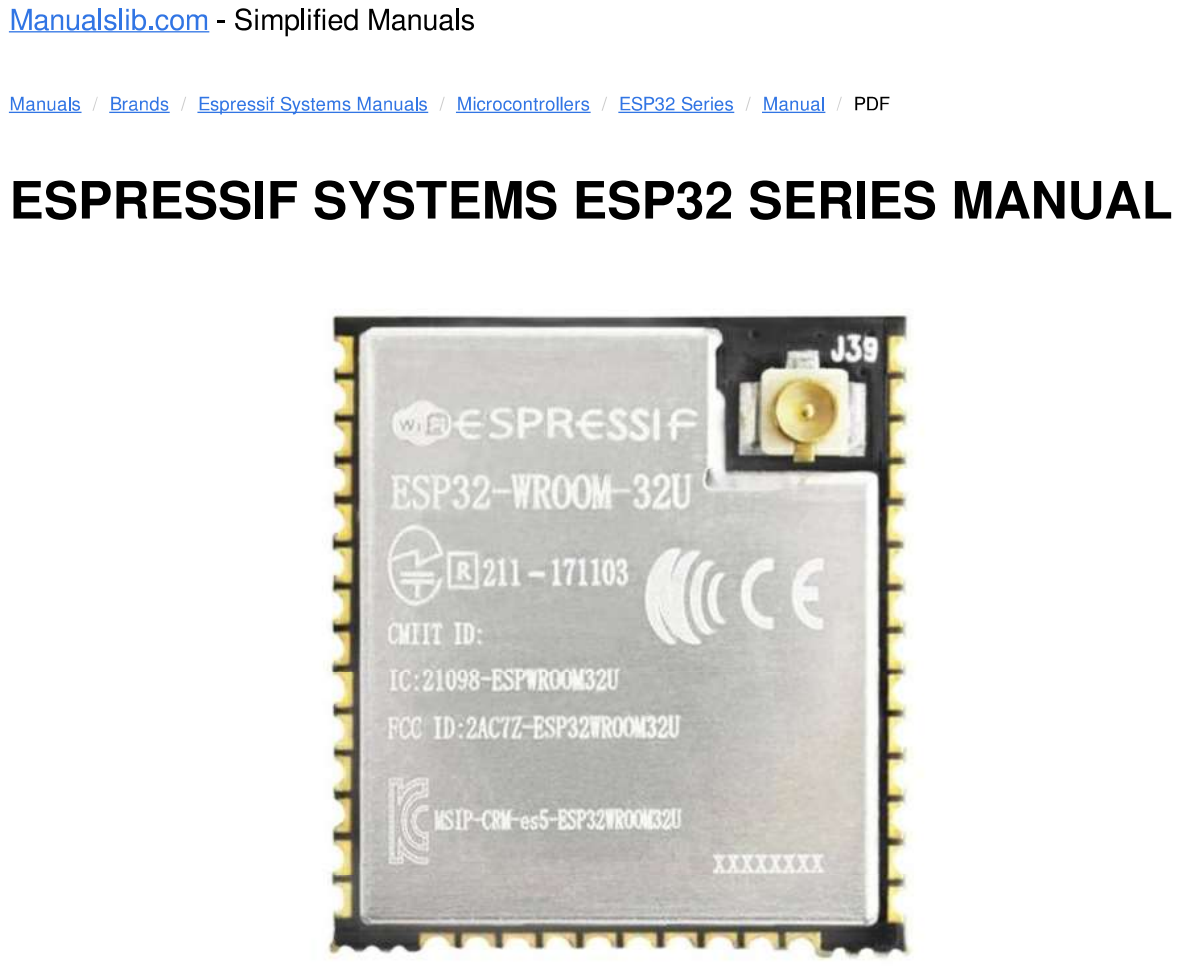
[picture p101: page 1]

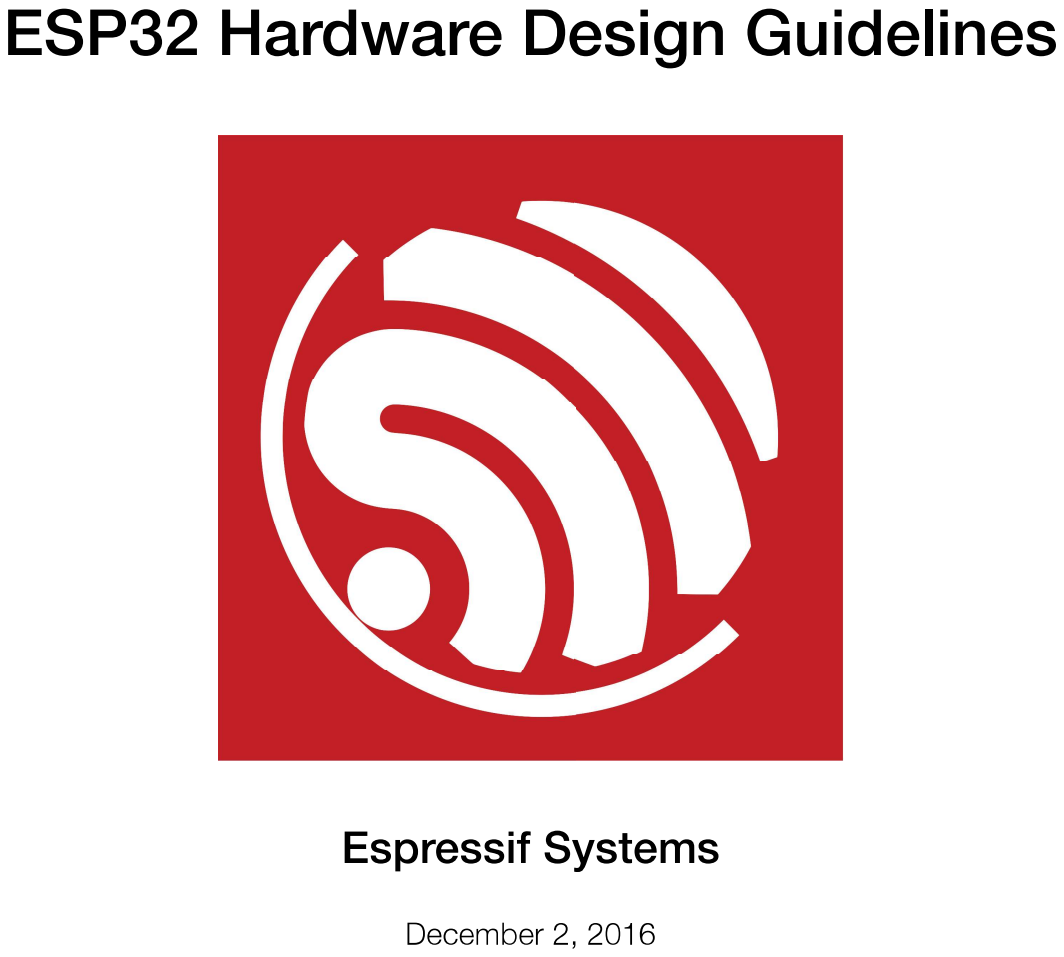
[picture p102: page 2]

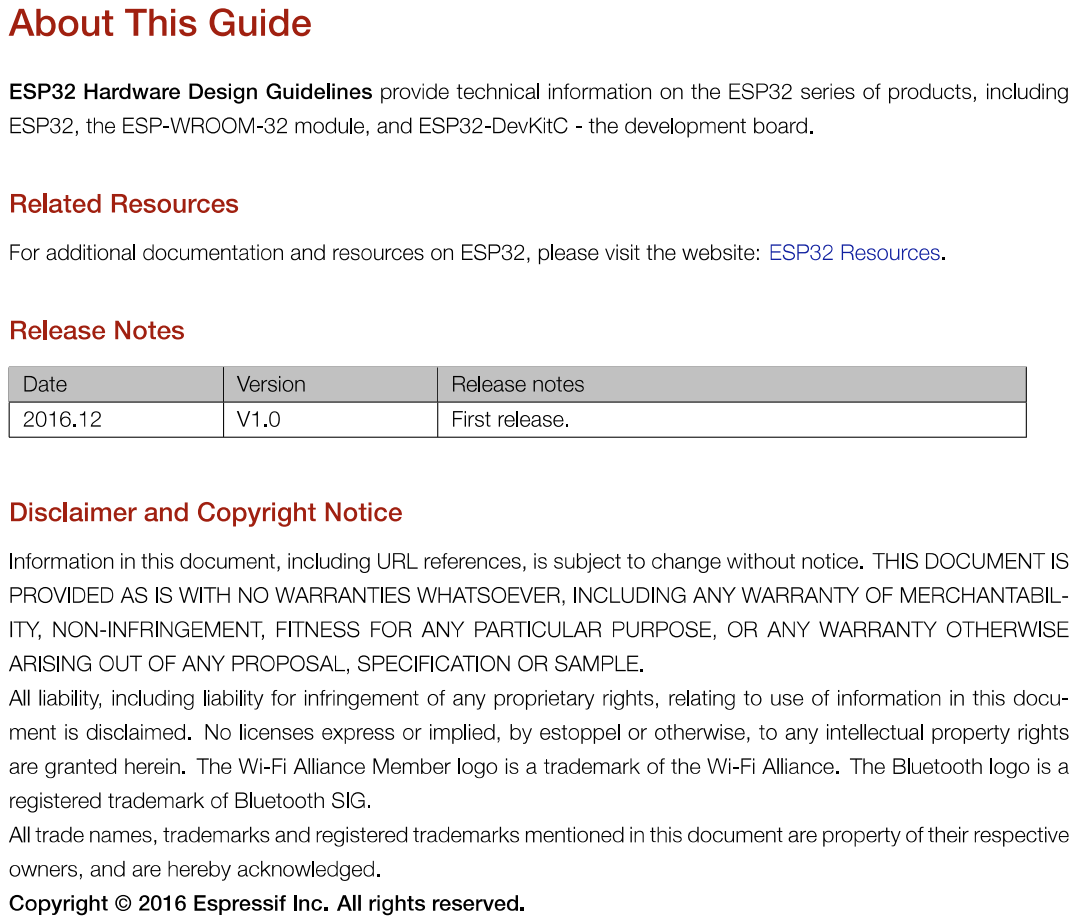
[picture p103: page 3]

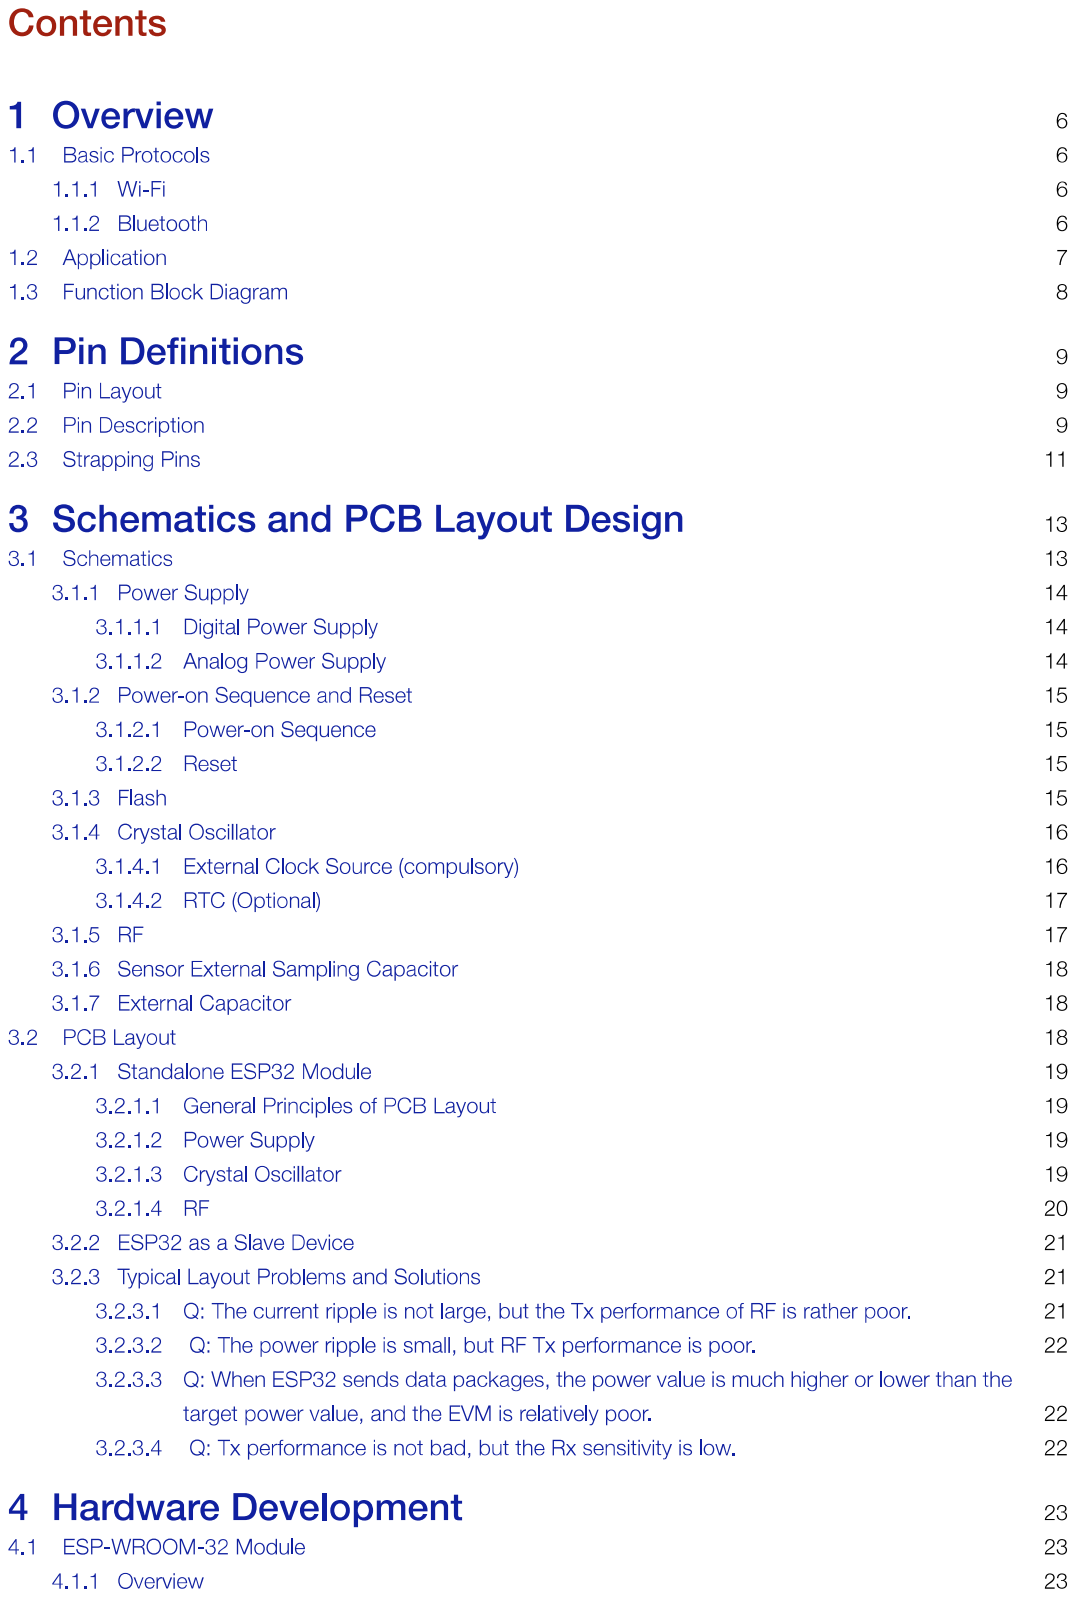
[picture p104: page 4]

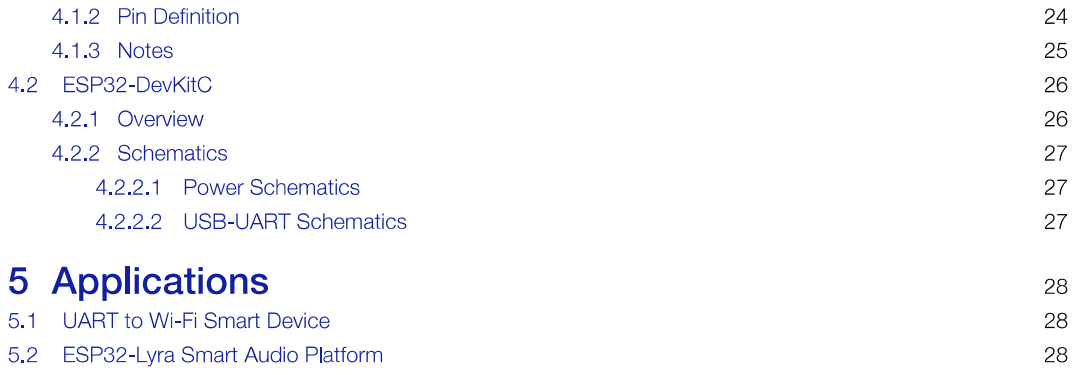
[picture p105: page 5]

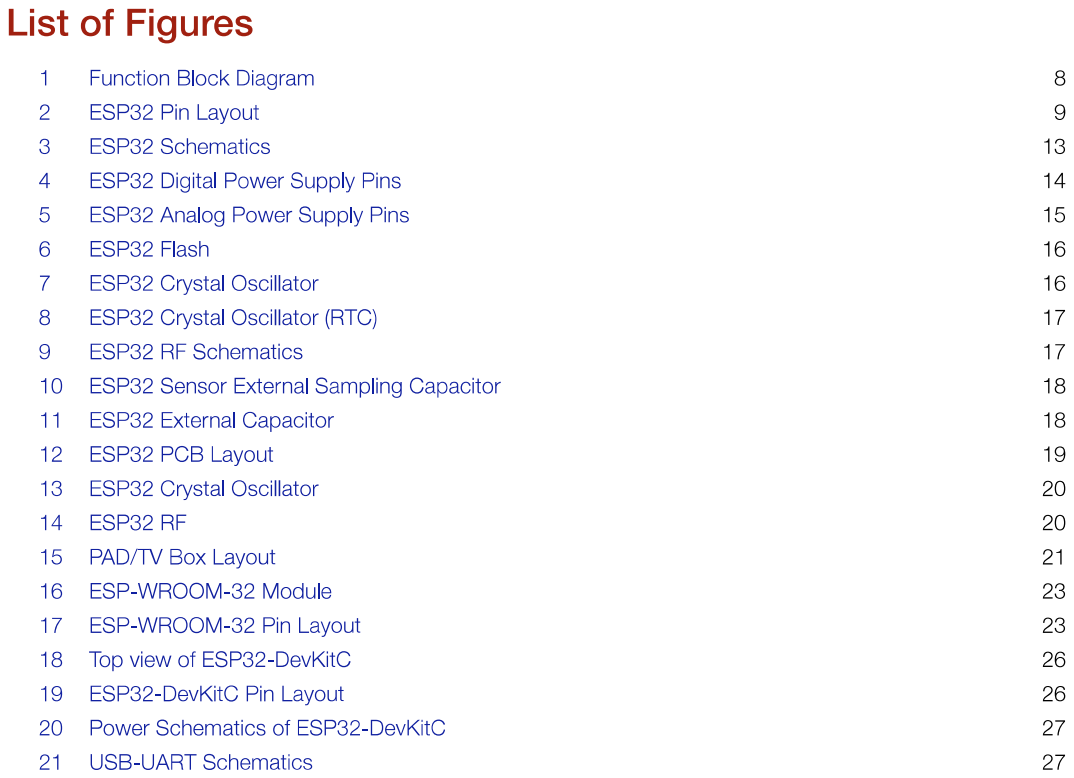
[picture p106: page 7]

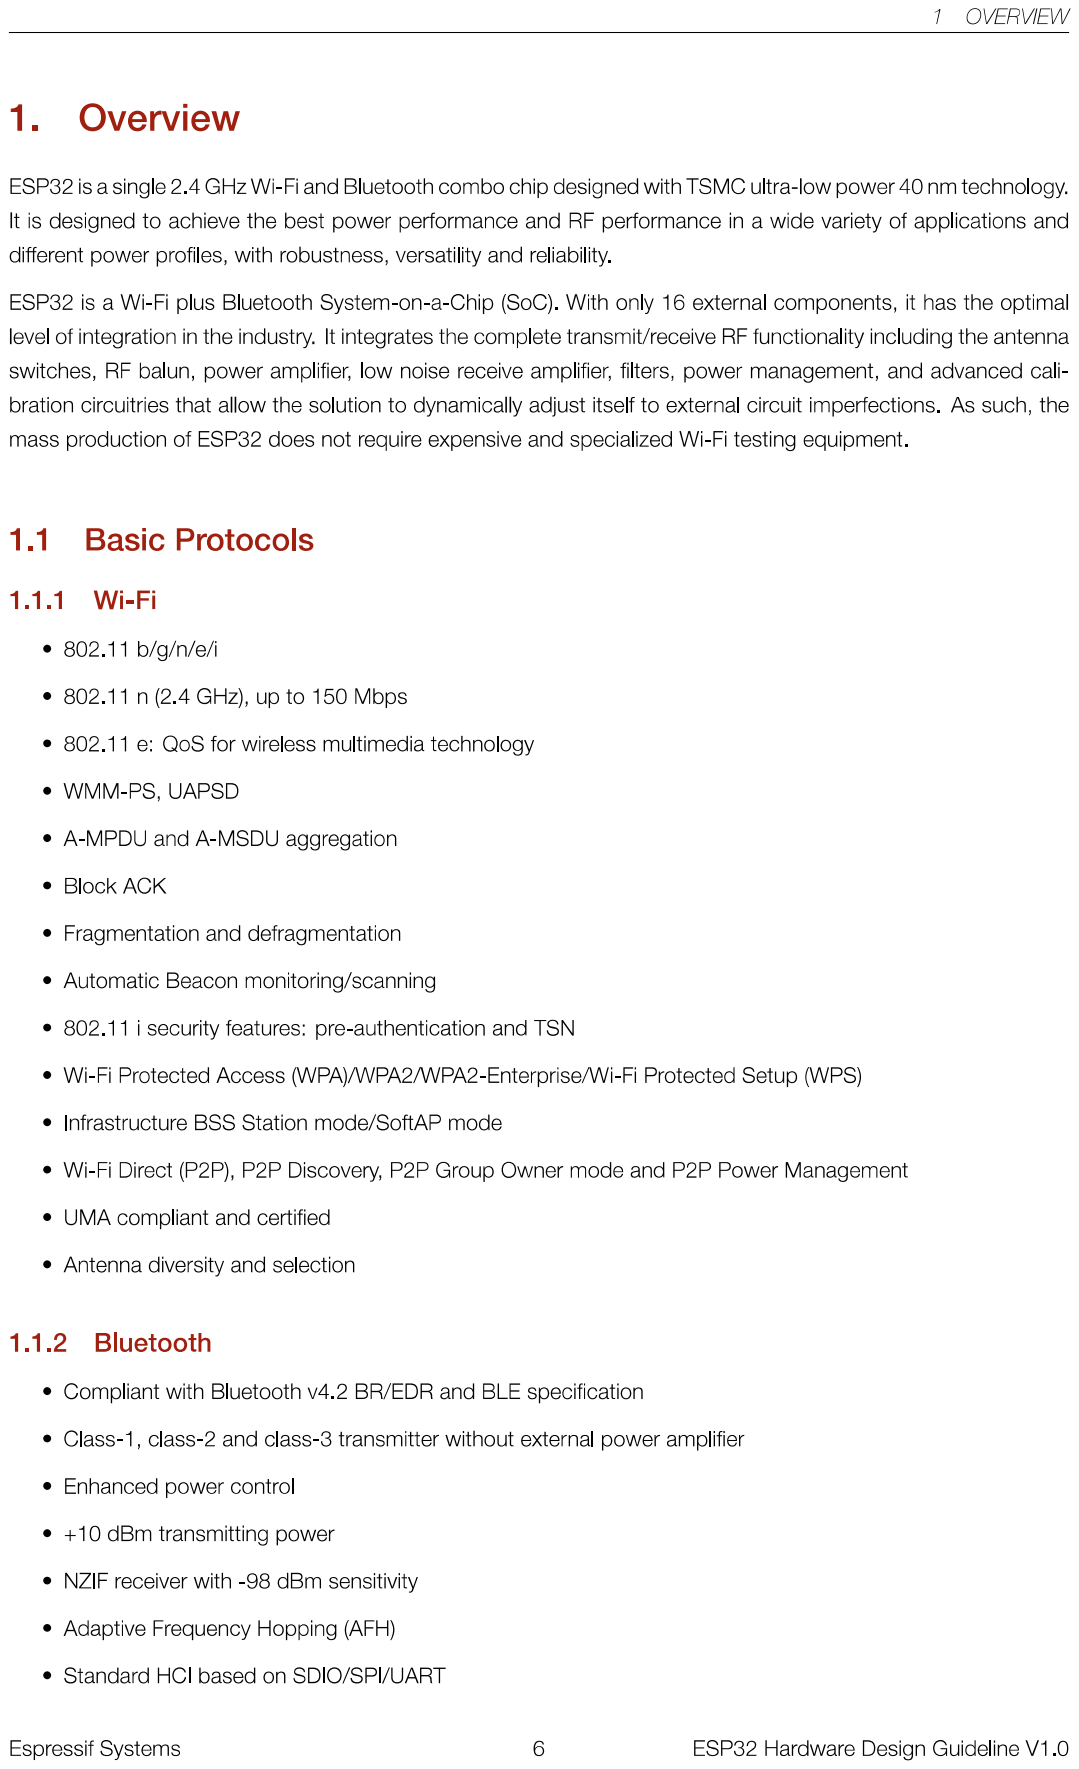
[picture p107: page 8]

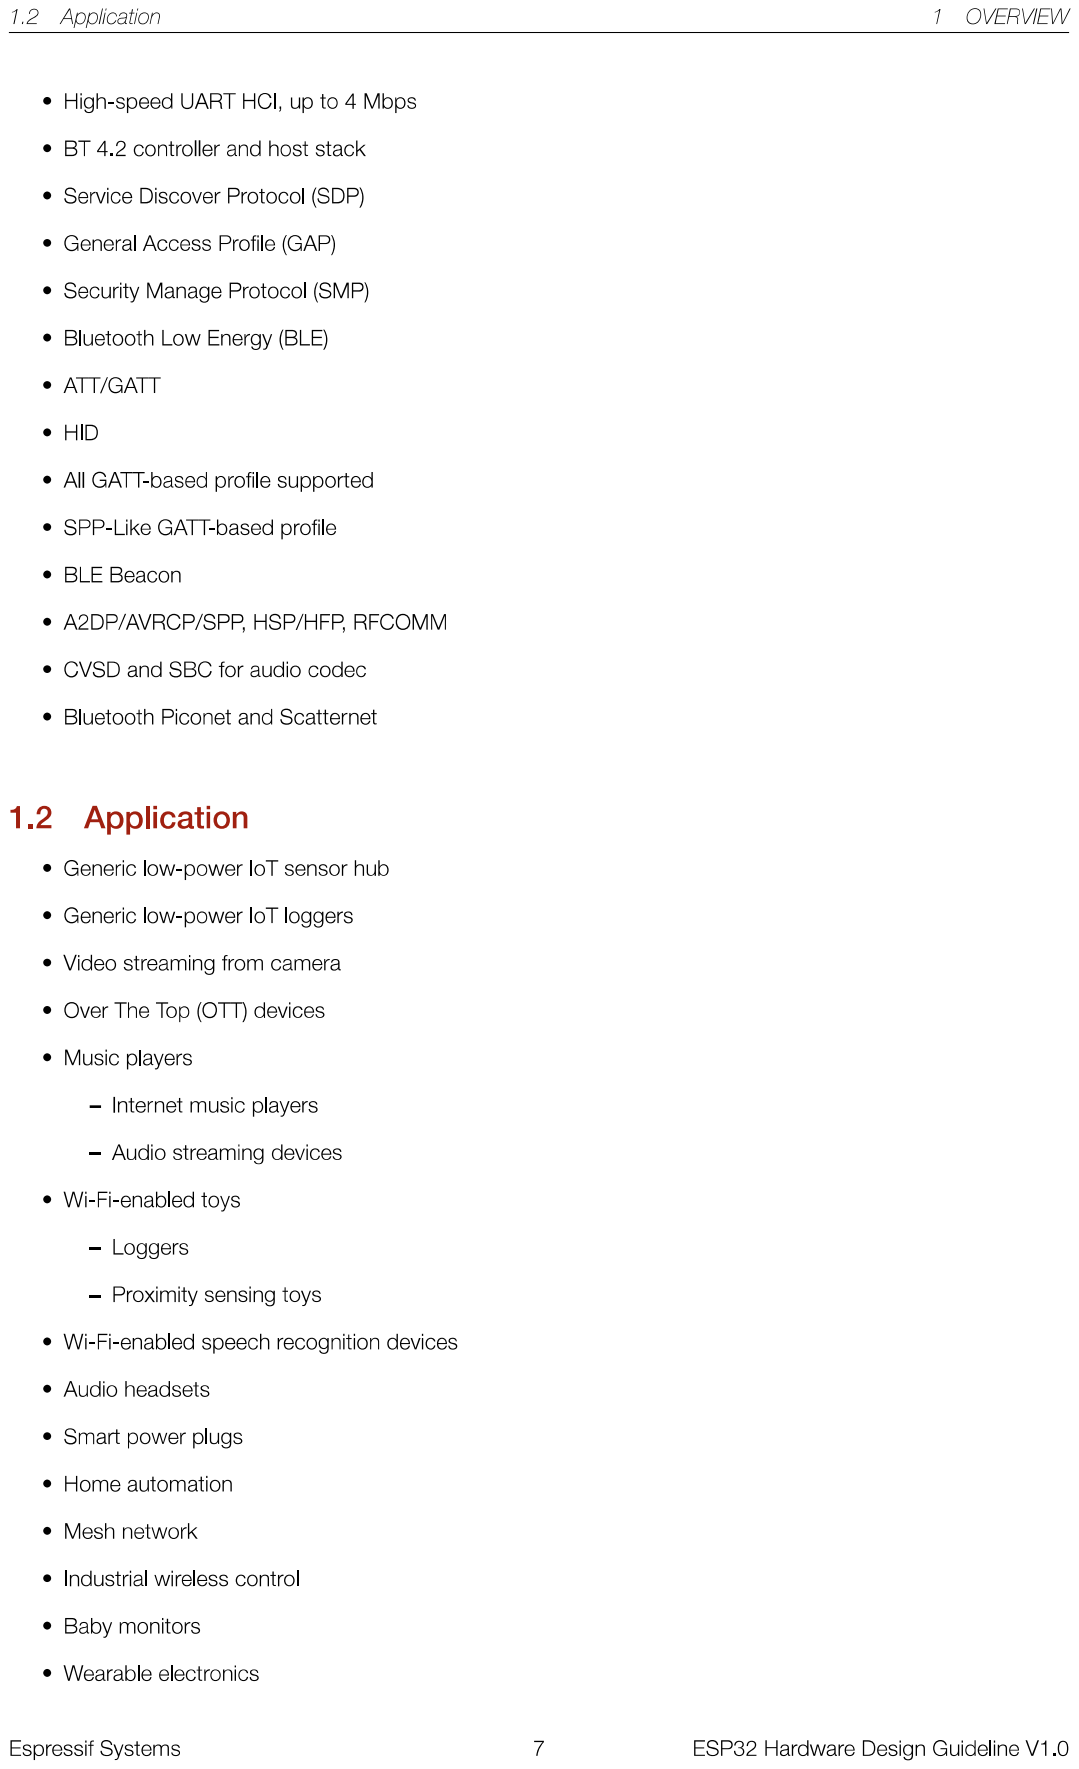
[picture p108: page 9]

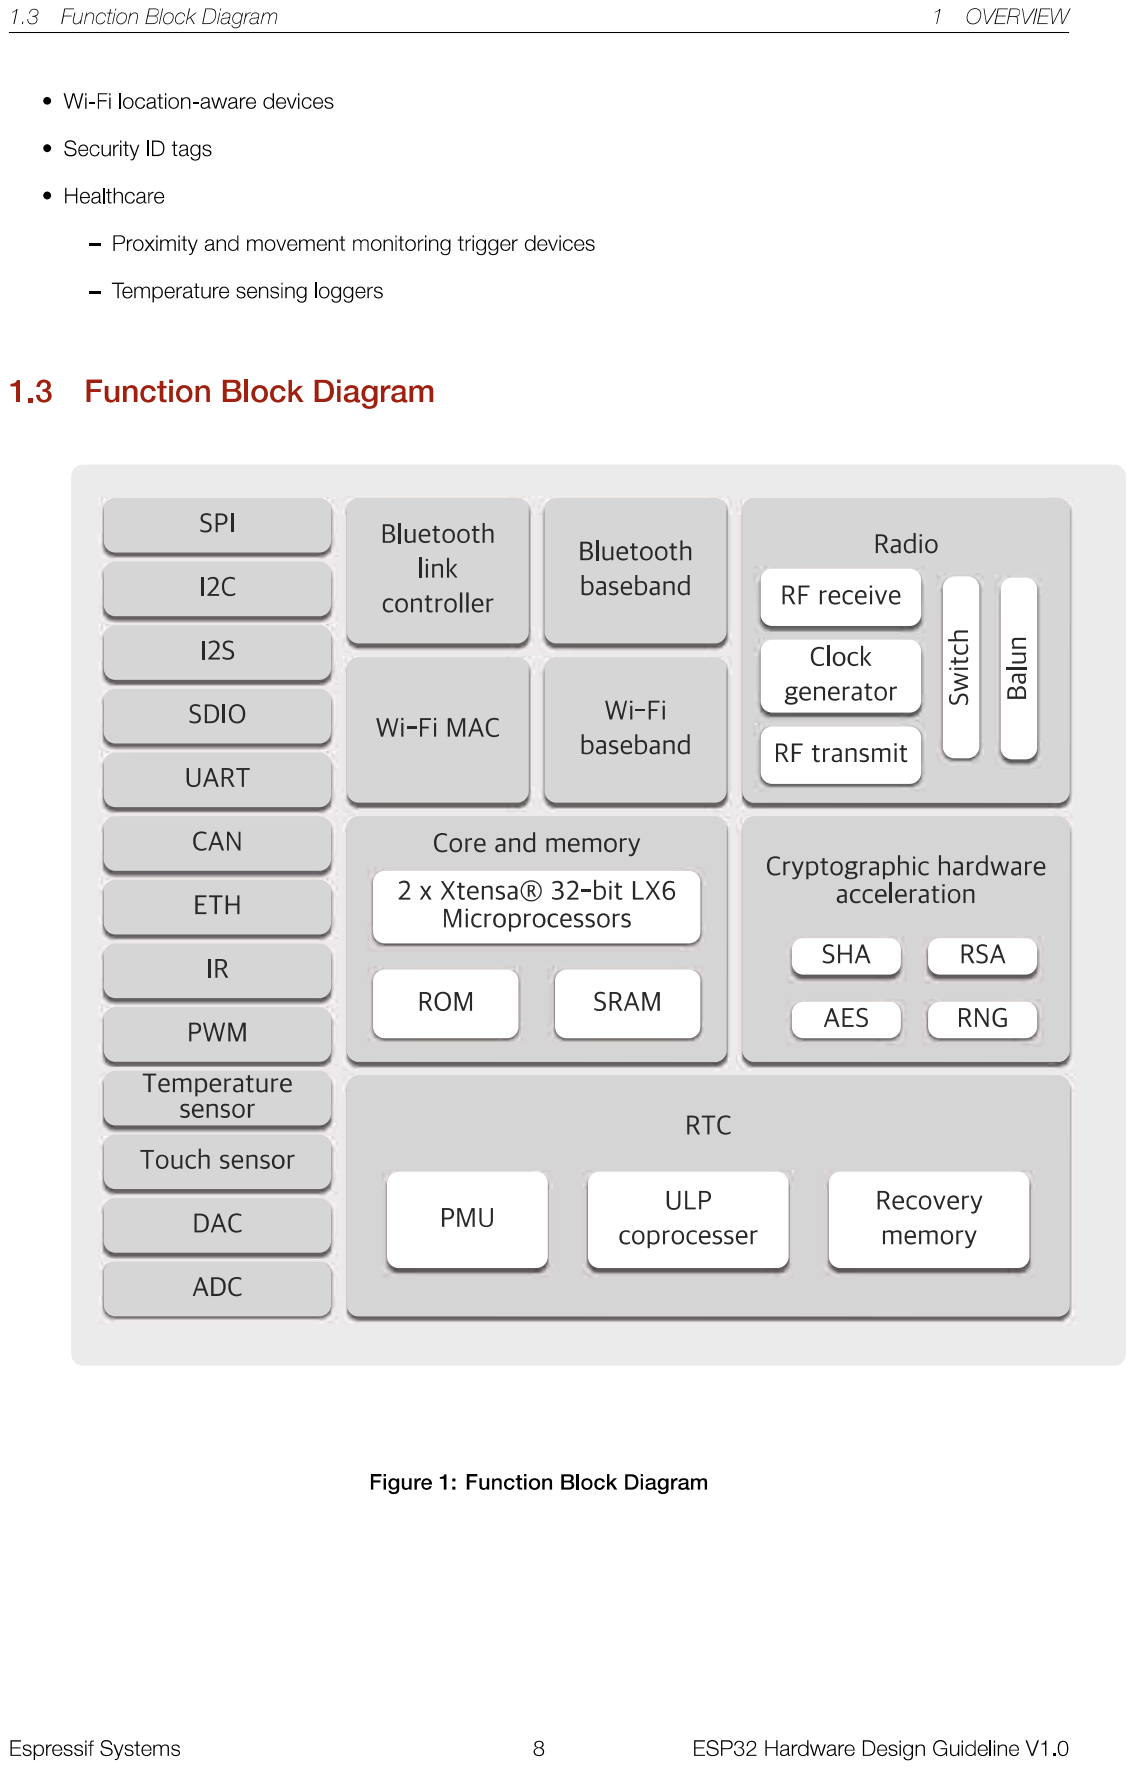
[picture p109: page 10]

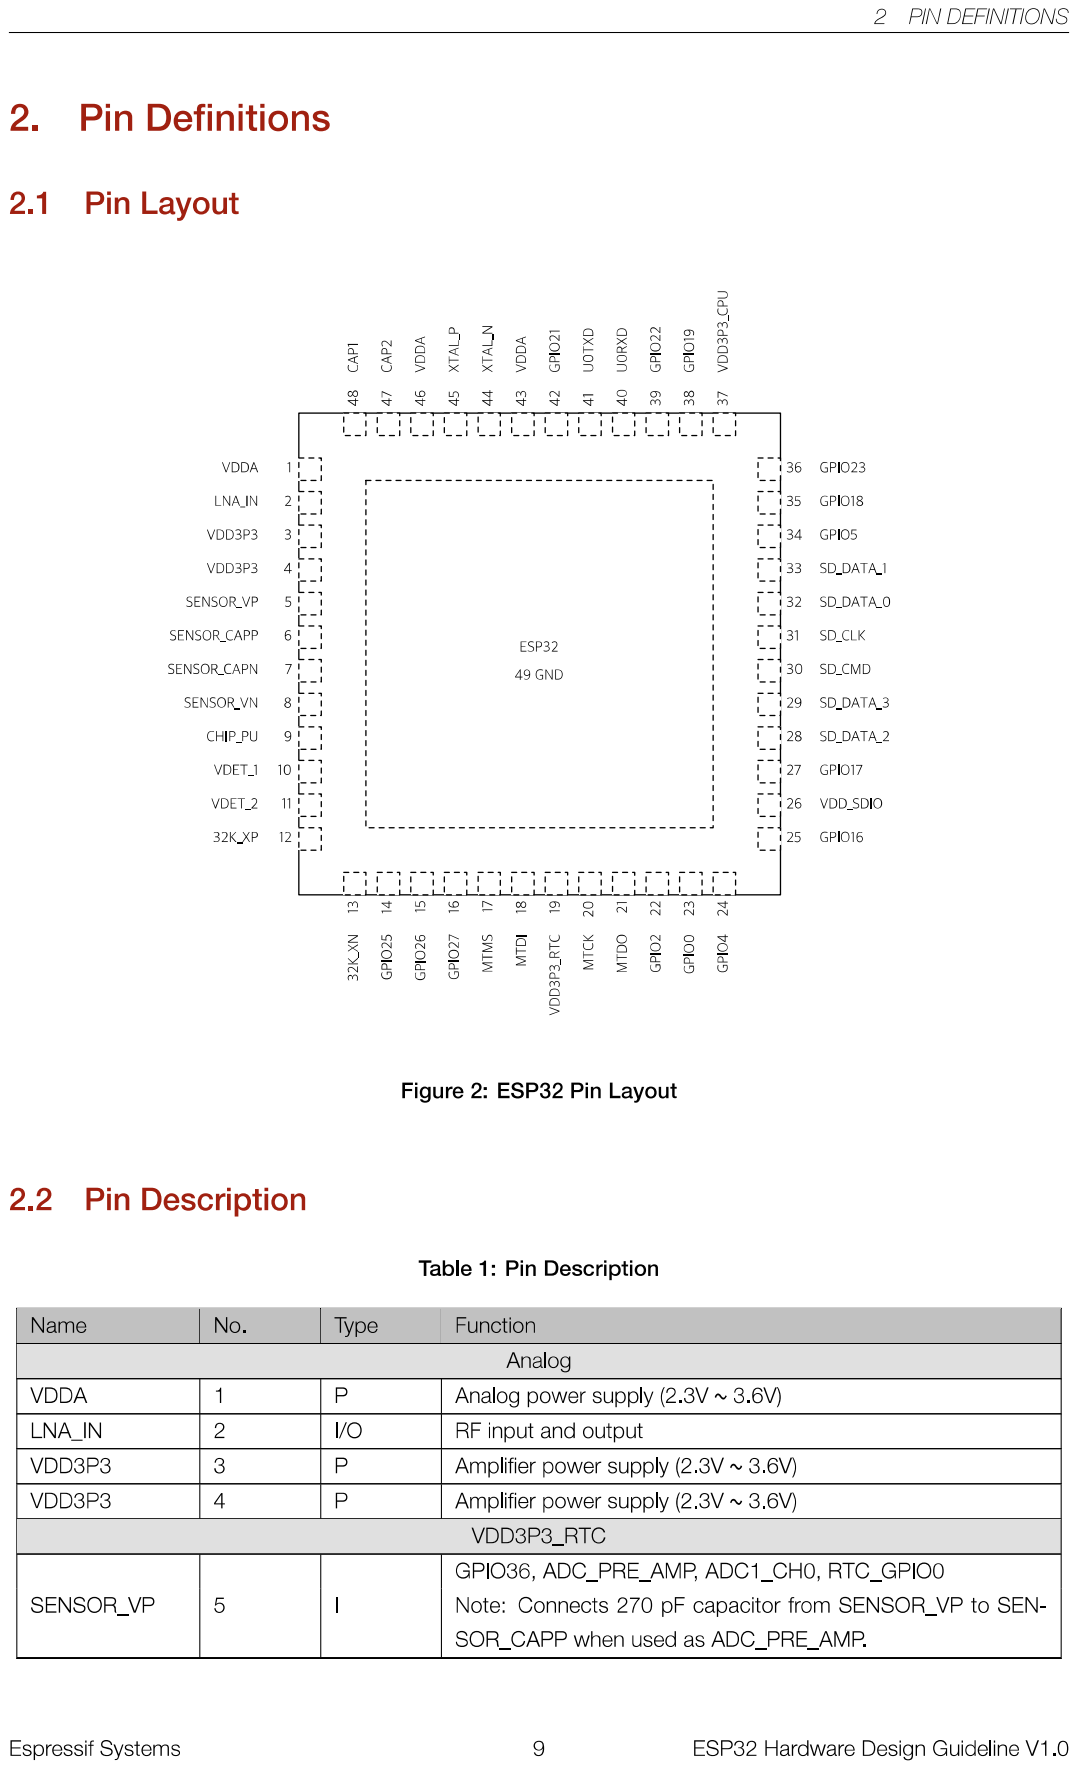
[picture p110: page 11]

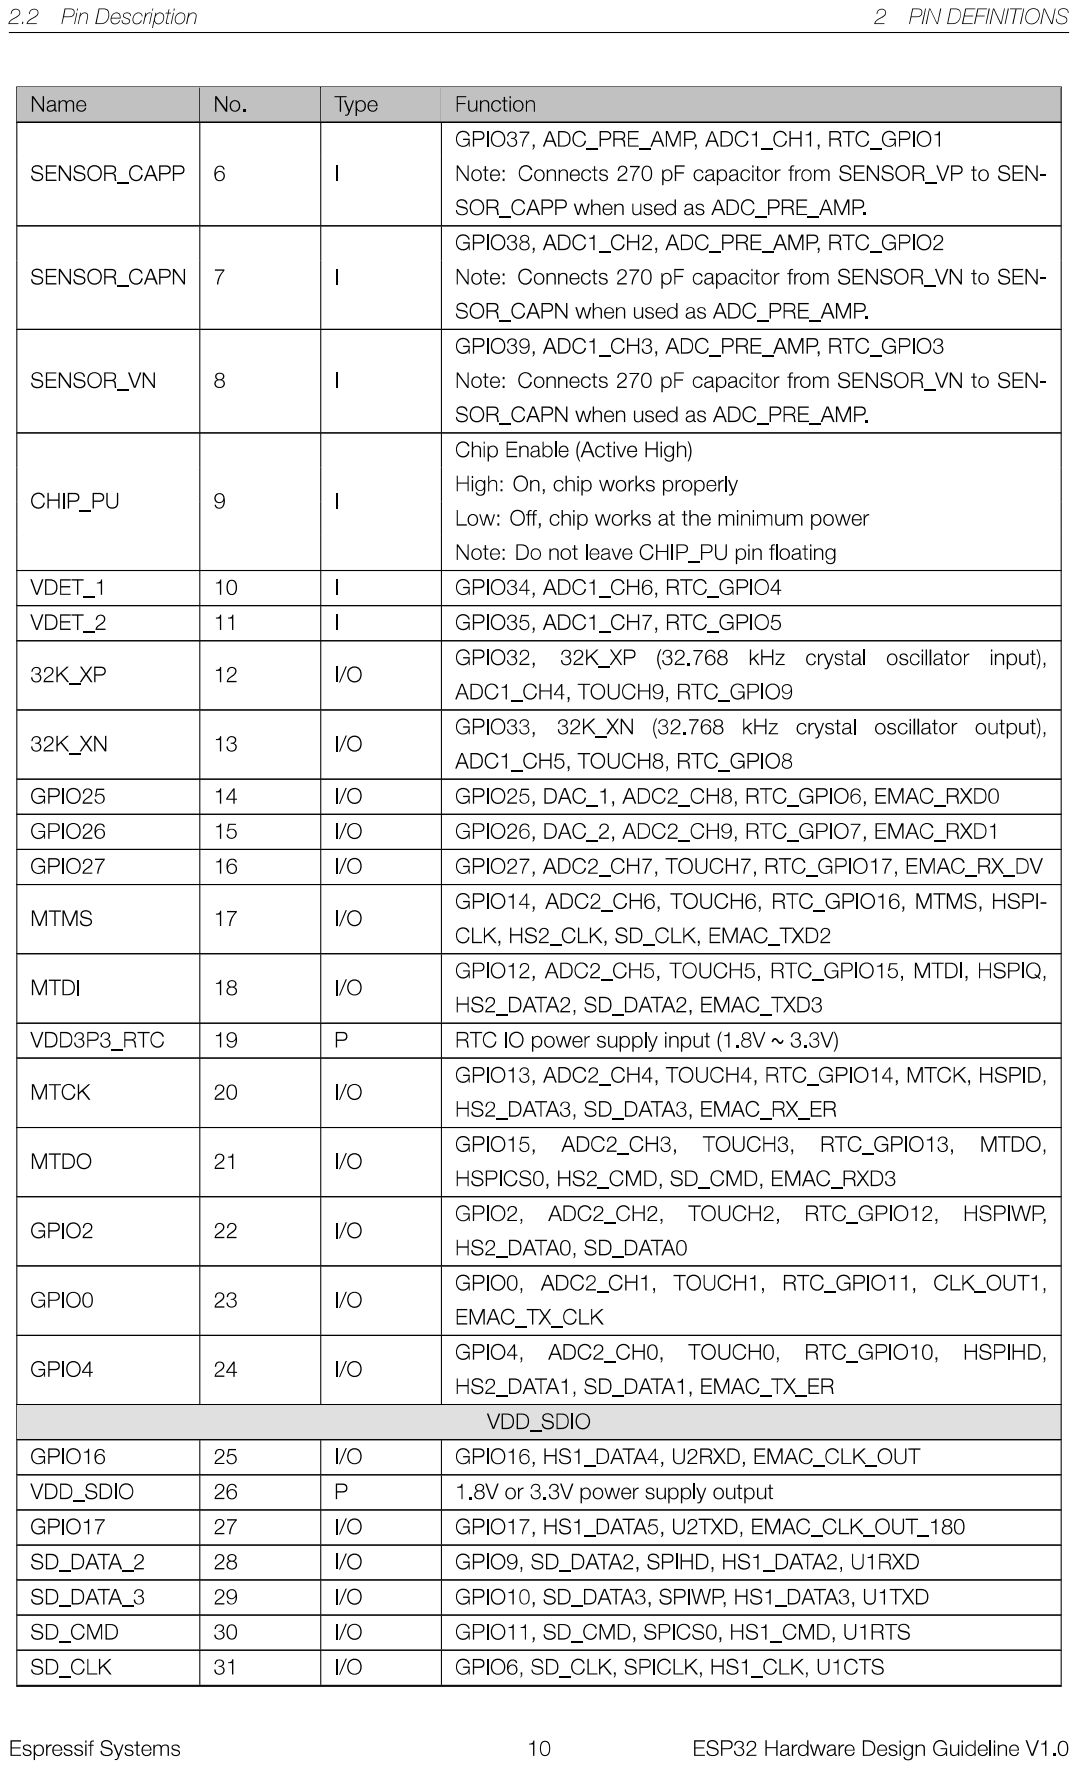
[picture p111: page 12]

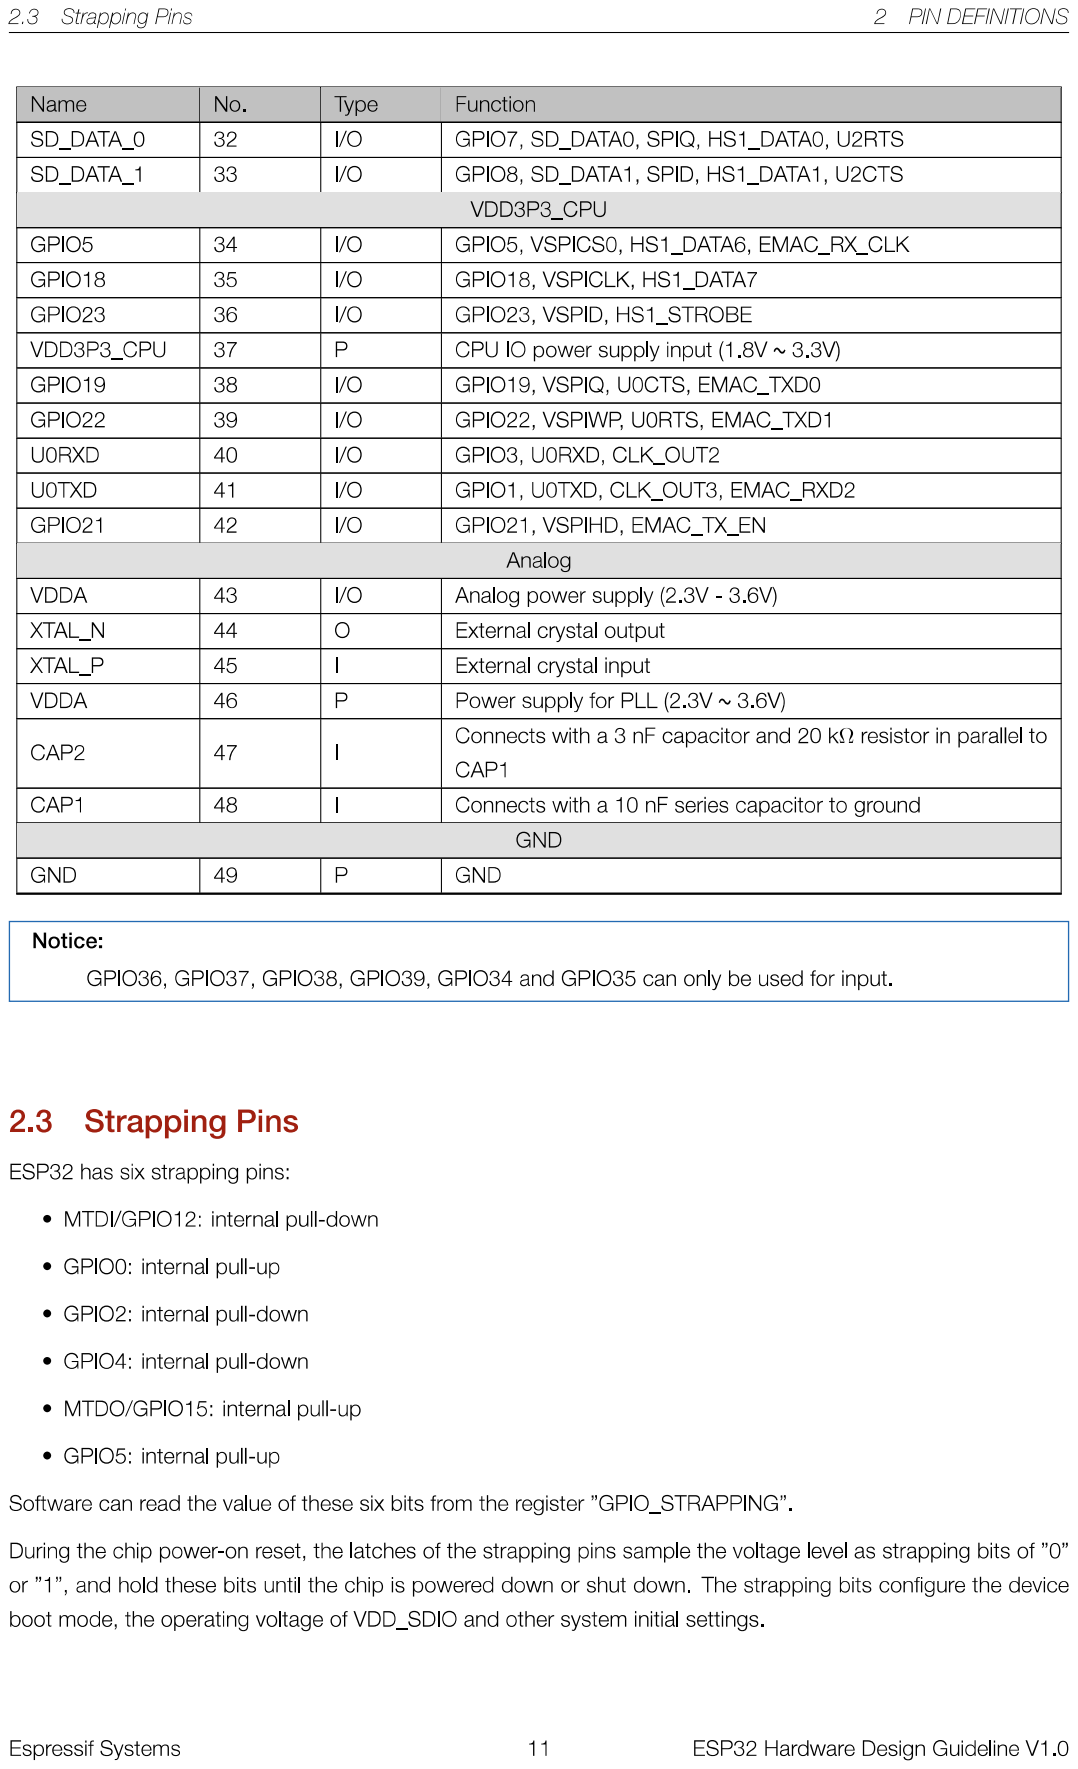
[picture p112: page 13]

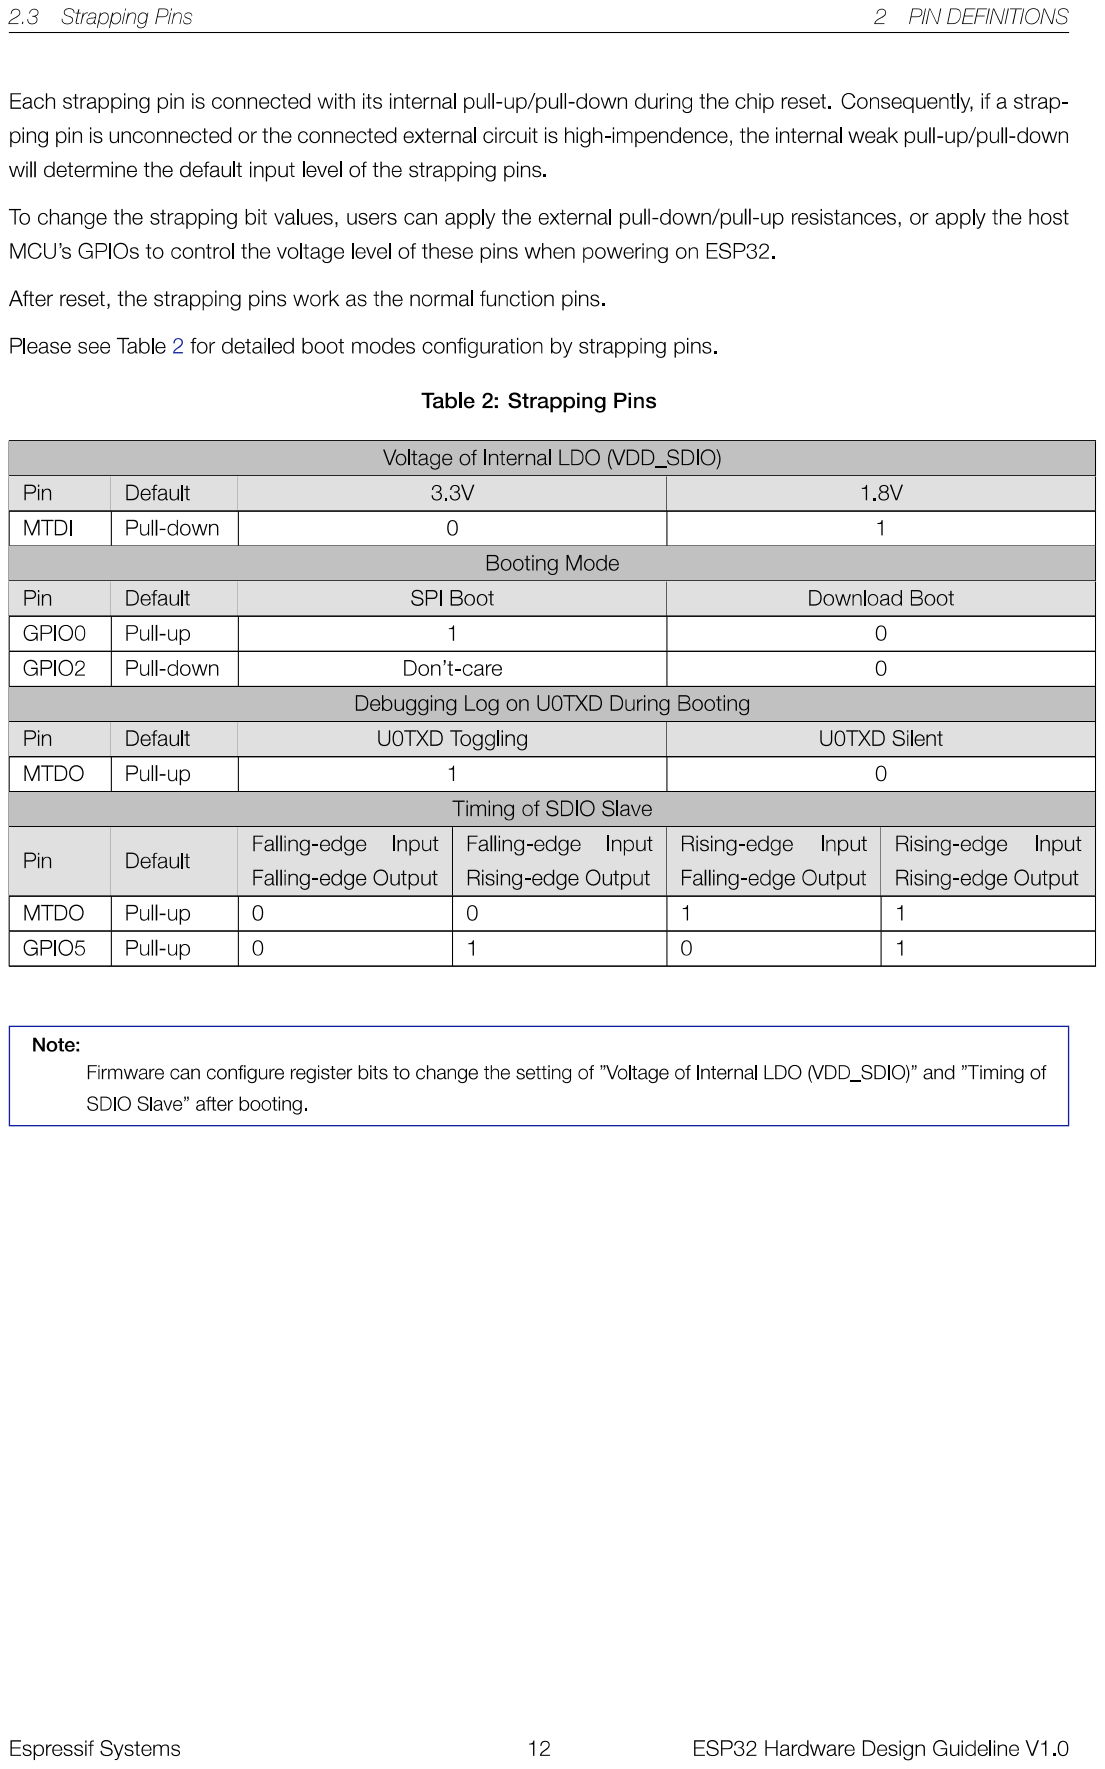
[picture p113: page 14]

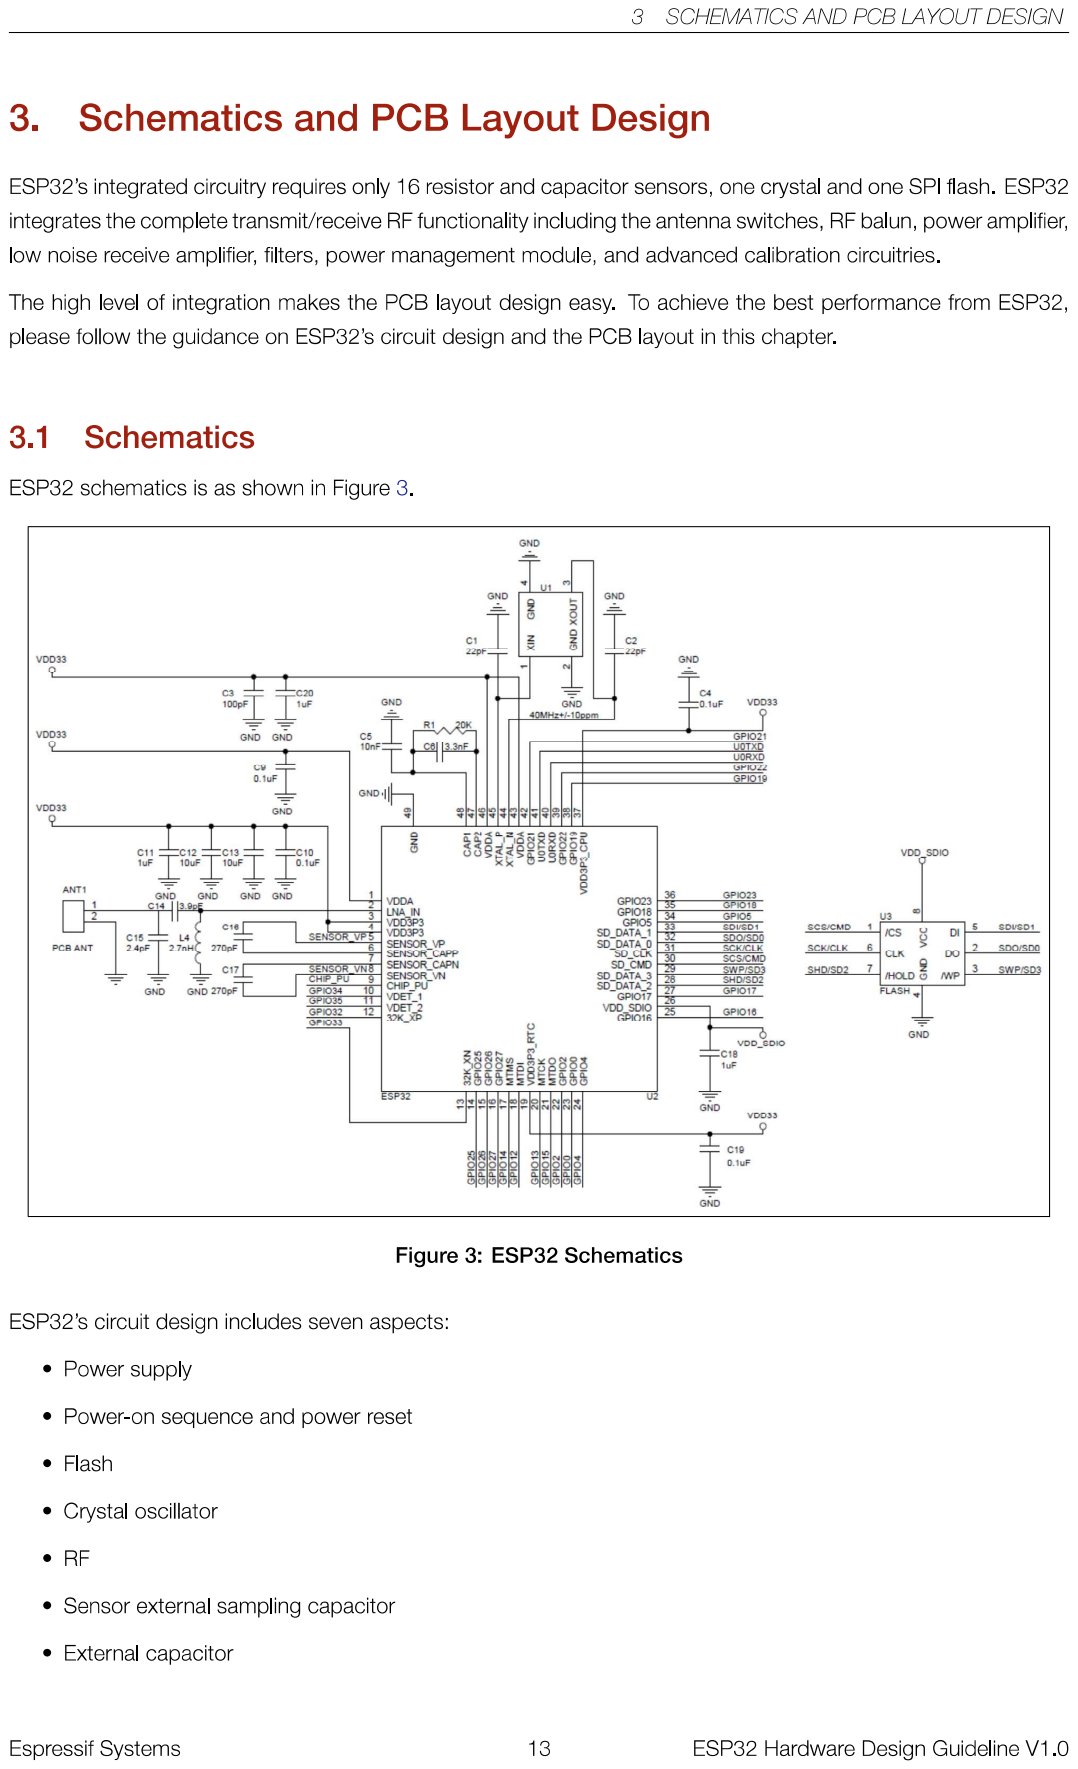
[picture p114: page 15]

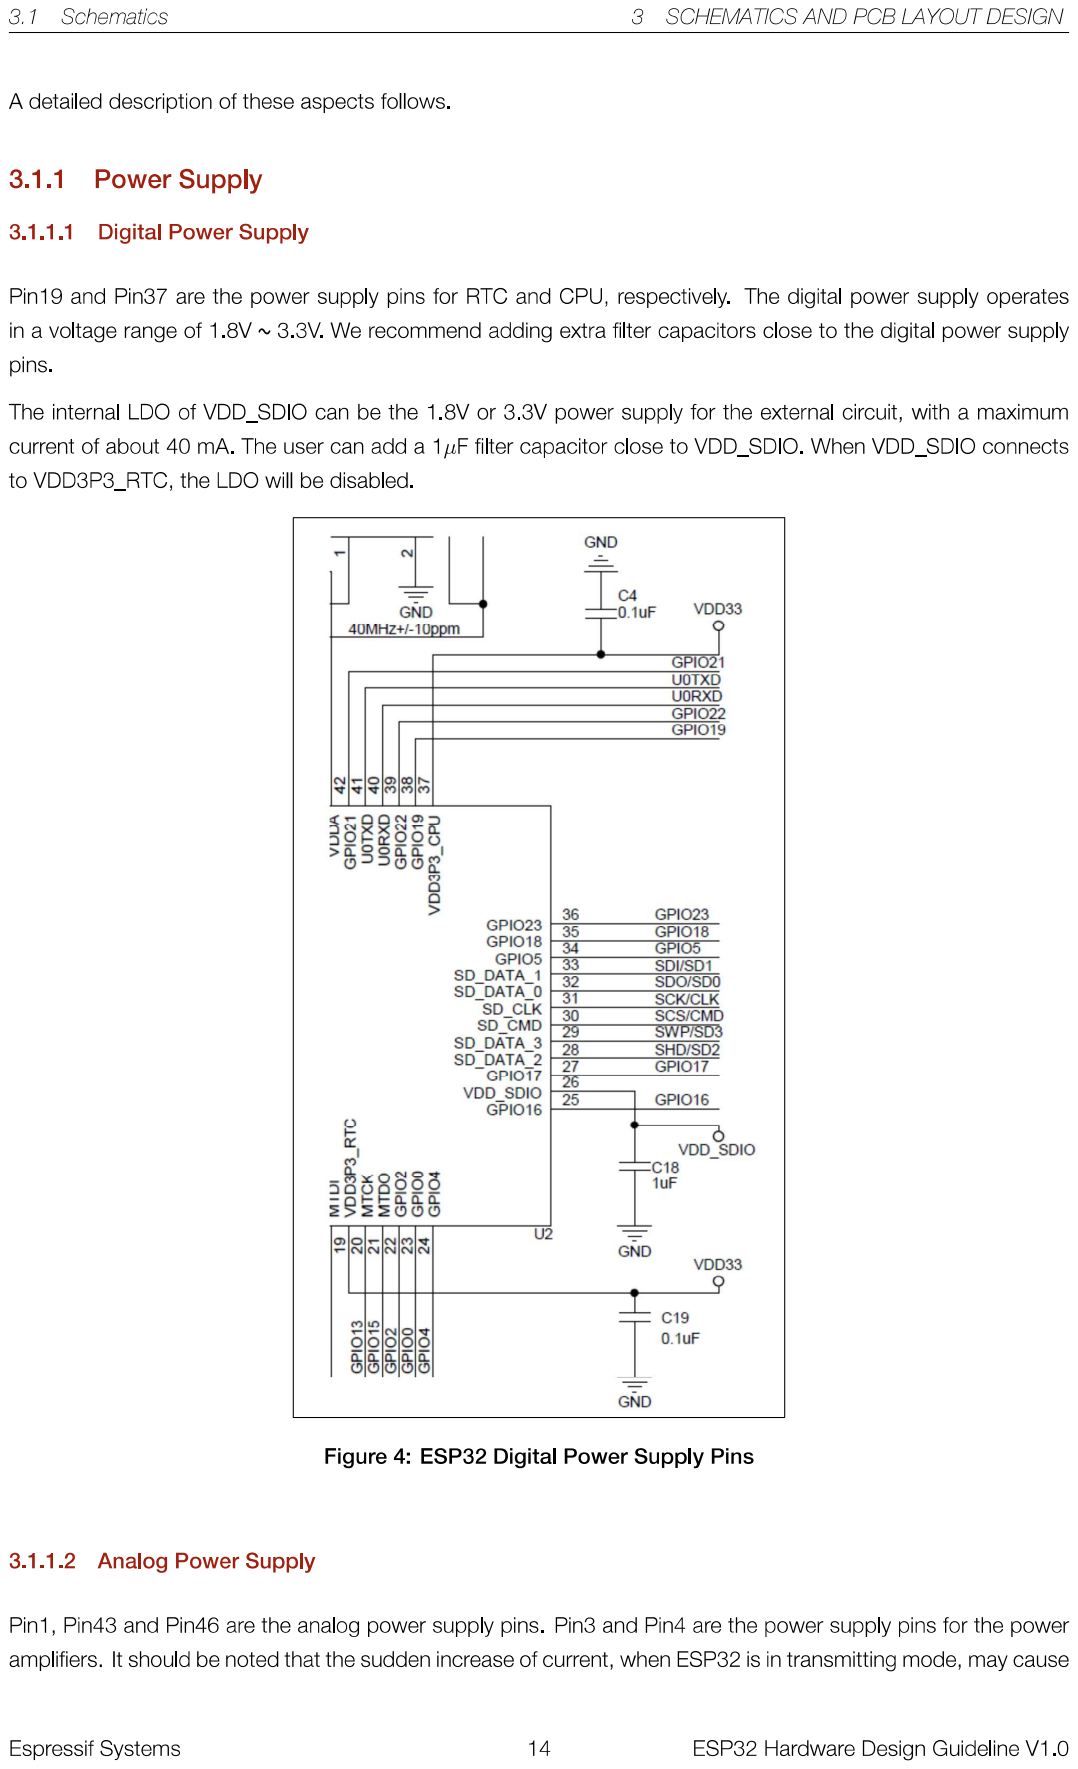
[picture p115: page 16]

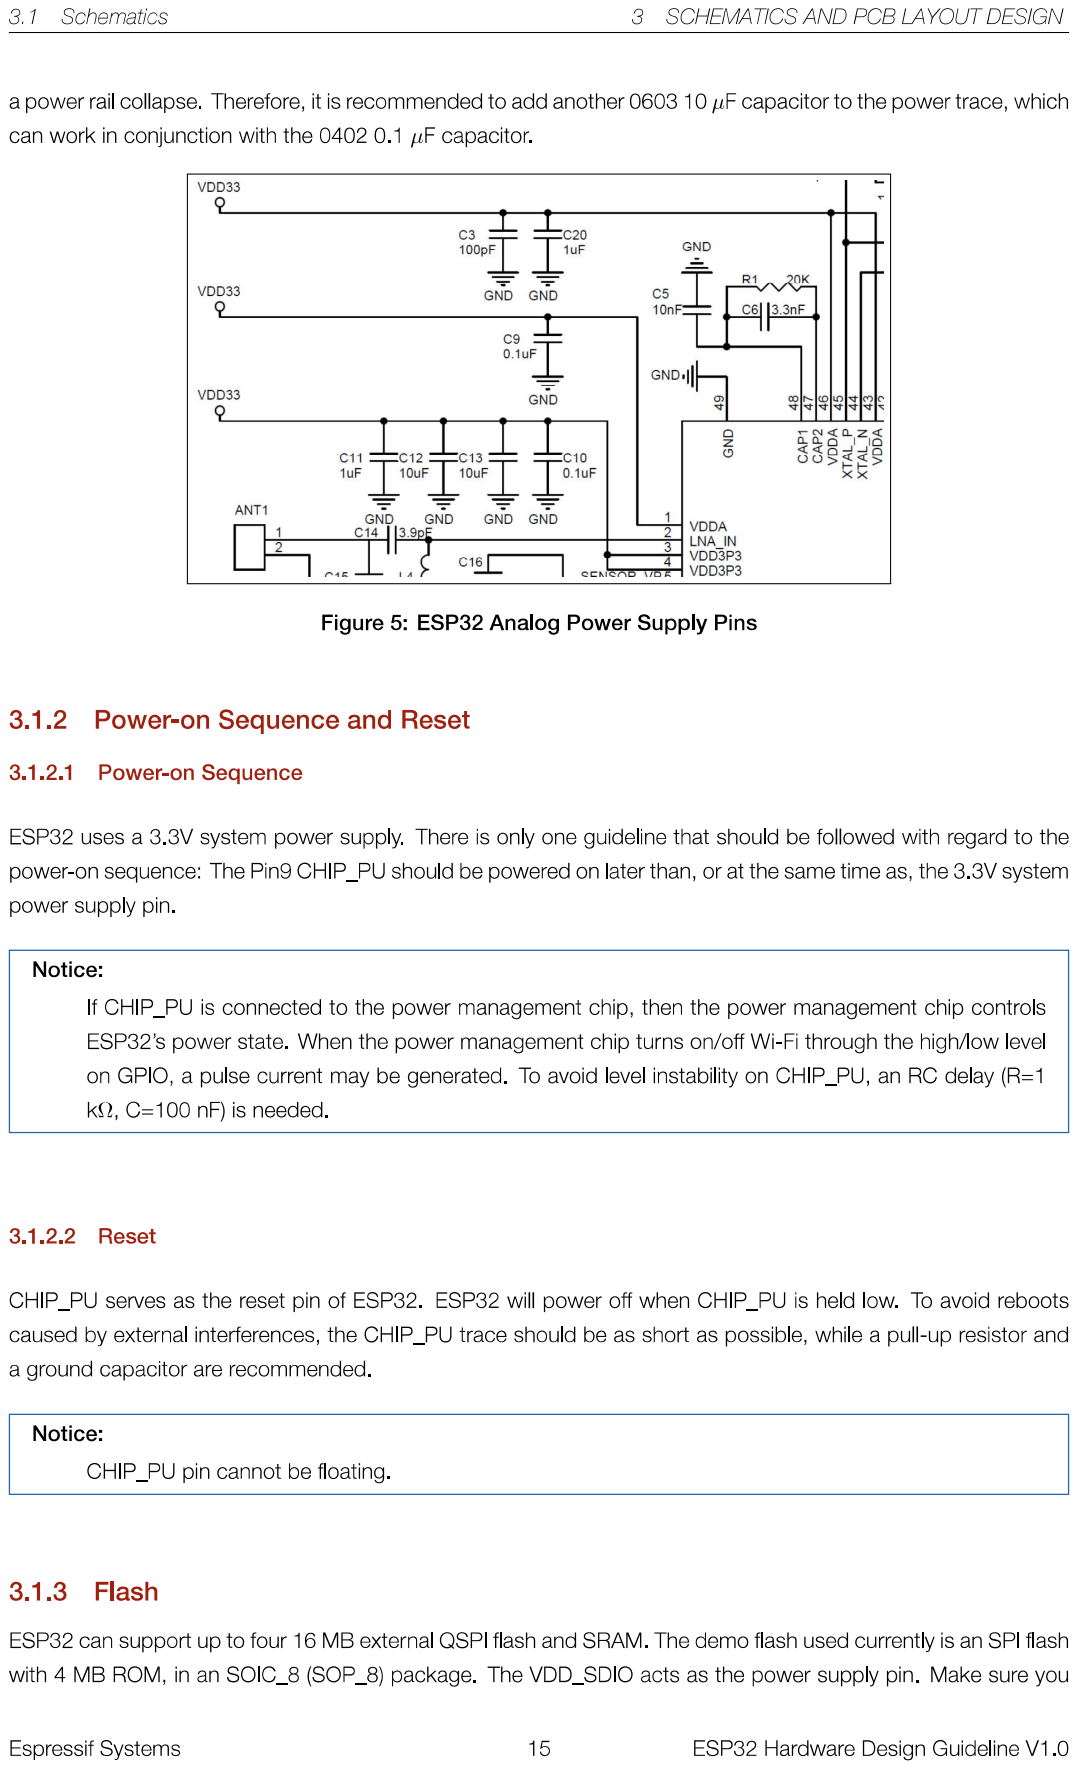
[picture p116: page 17]

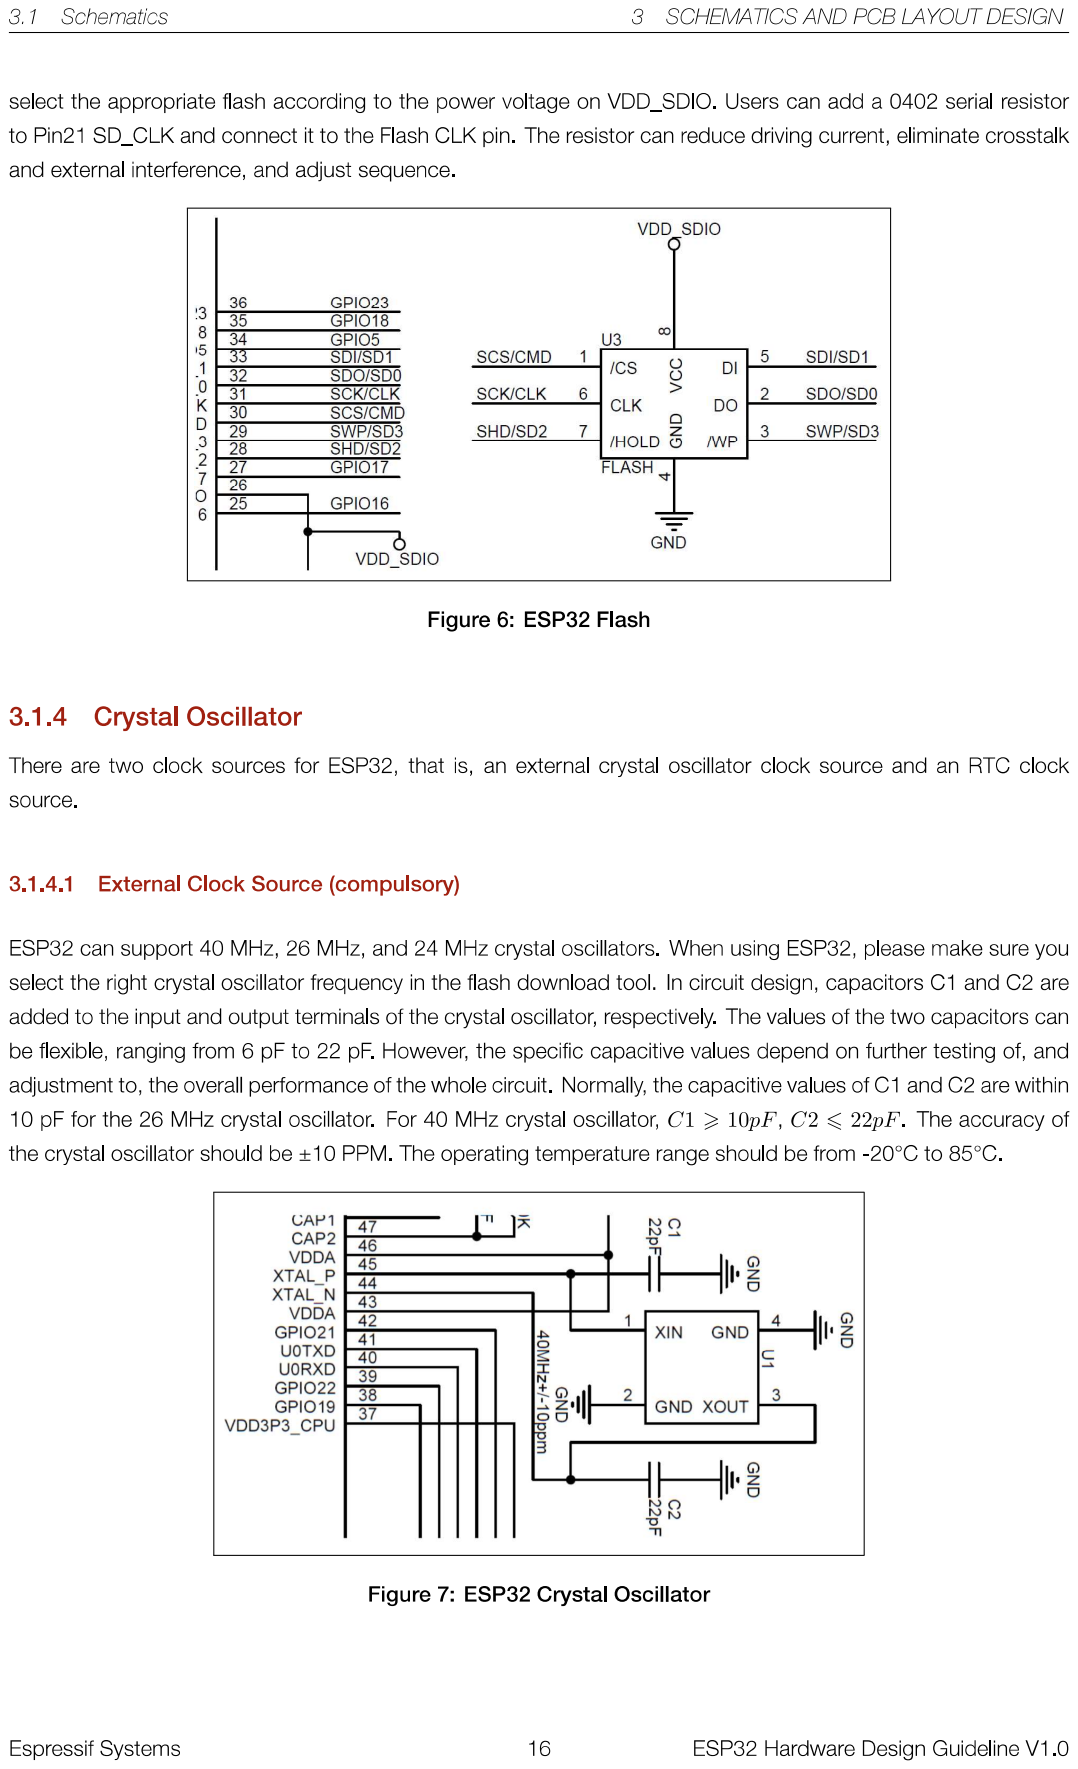
[picture p117: page 18]

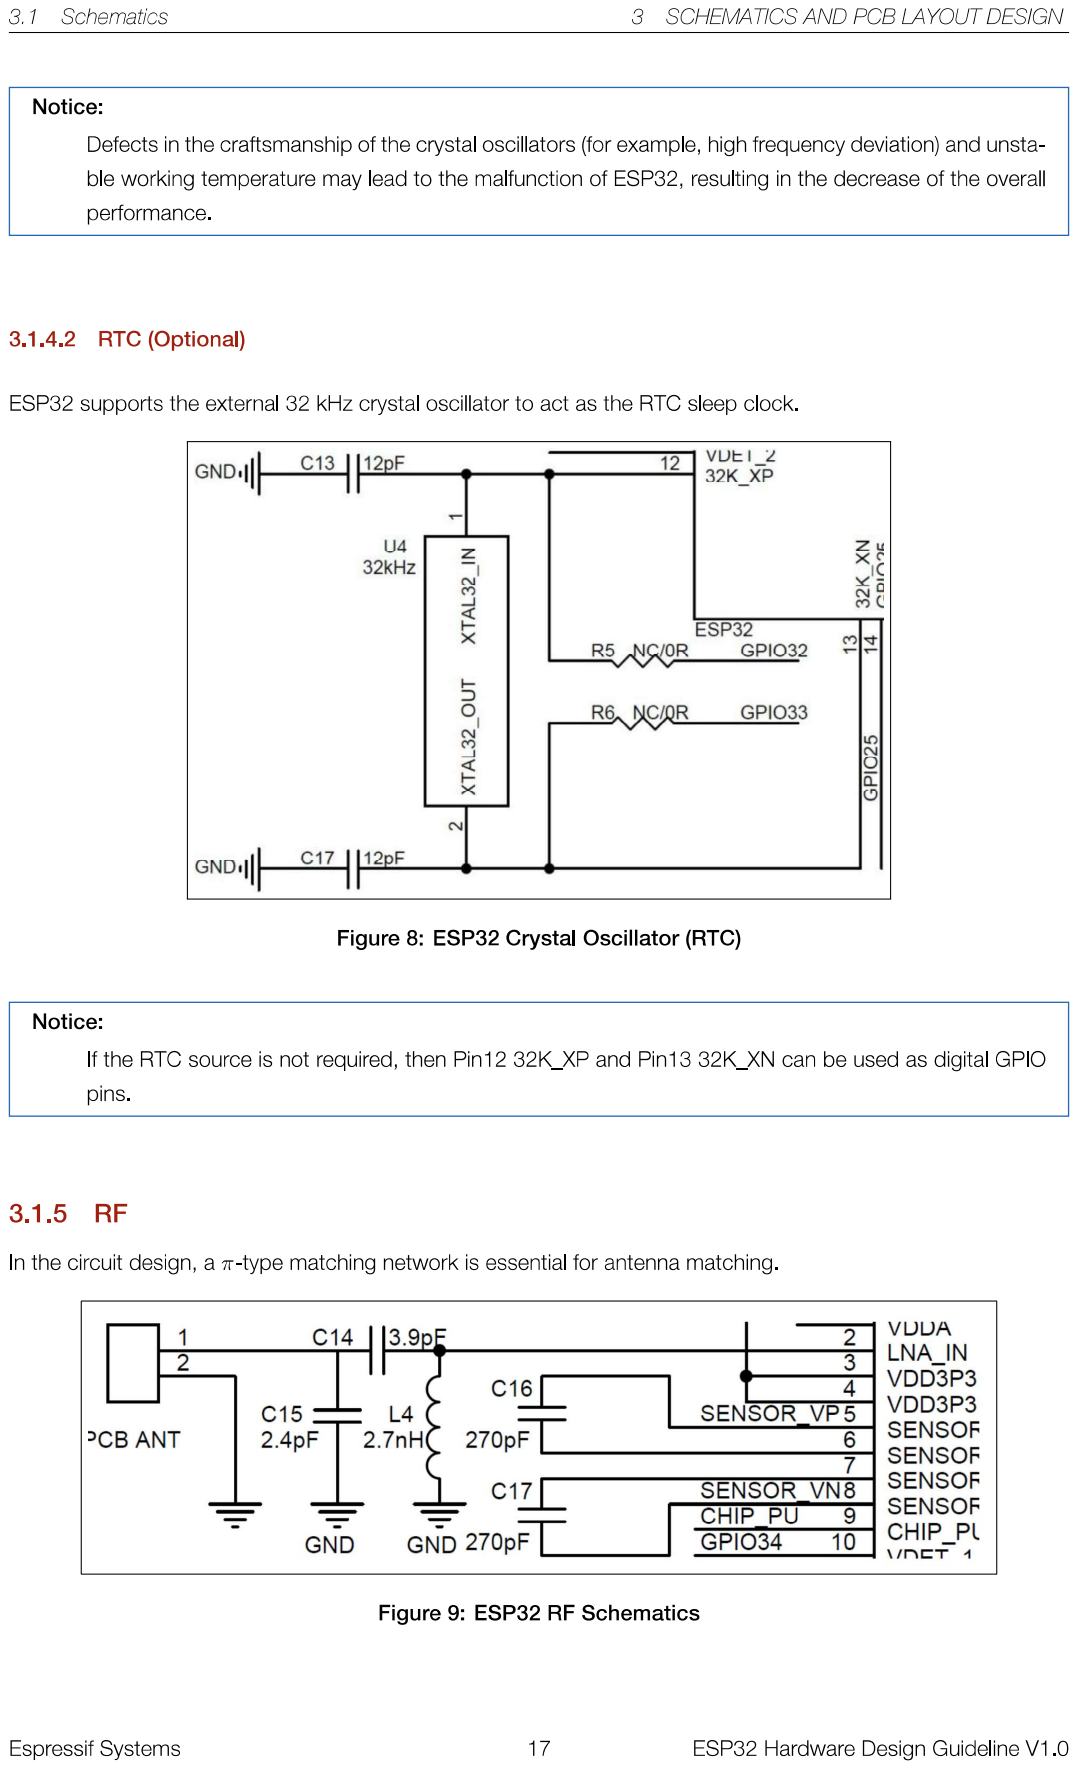
[picture p118: page 19]

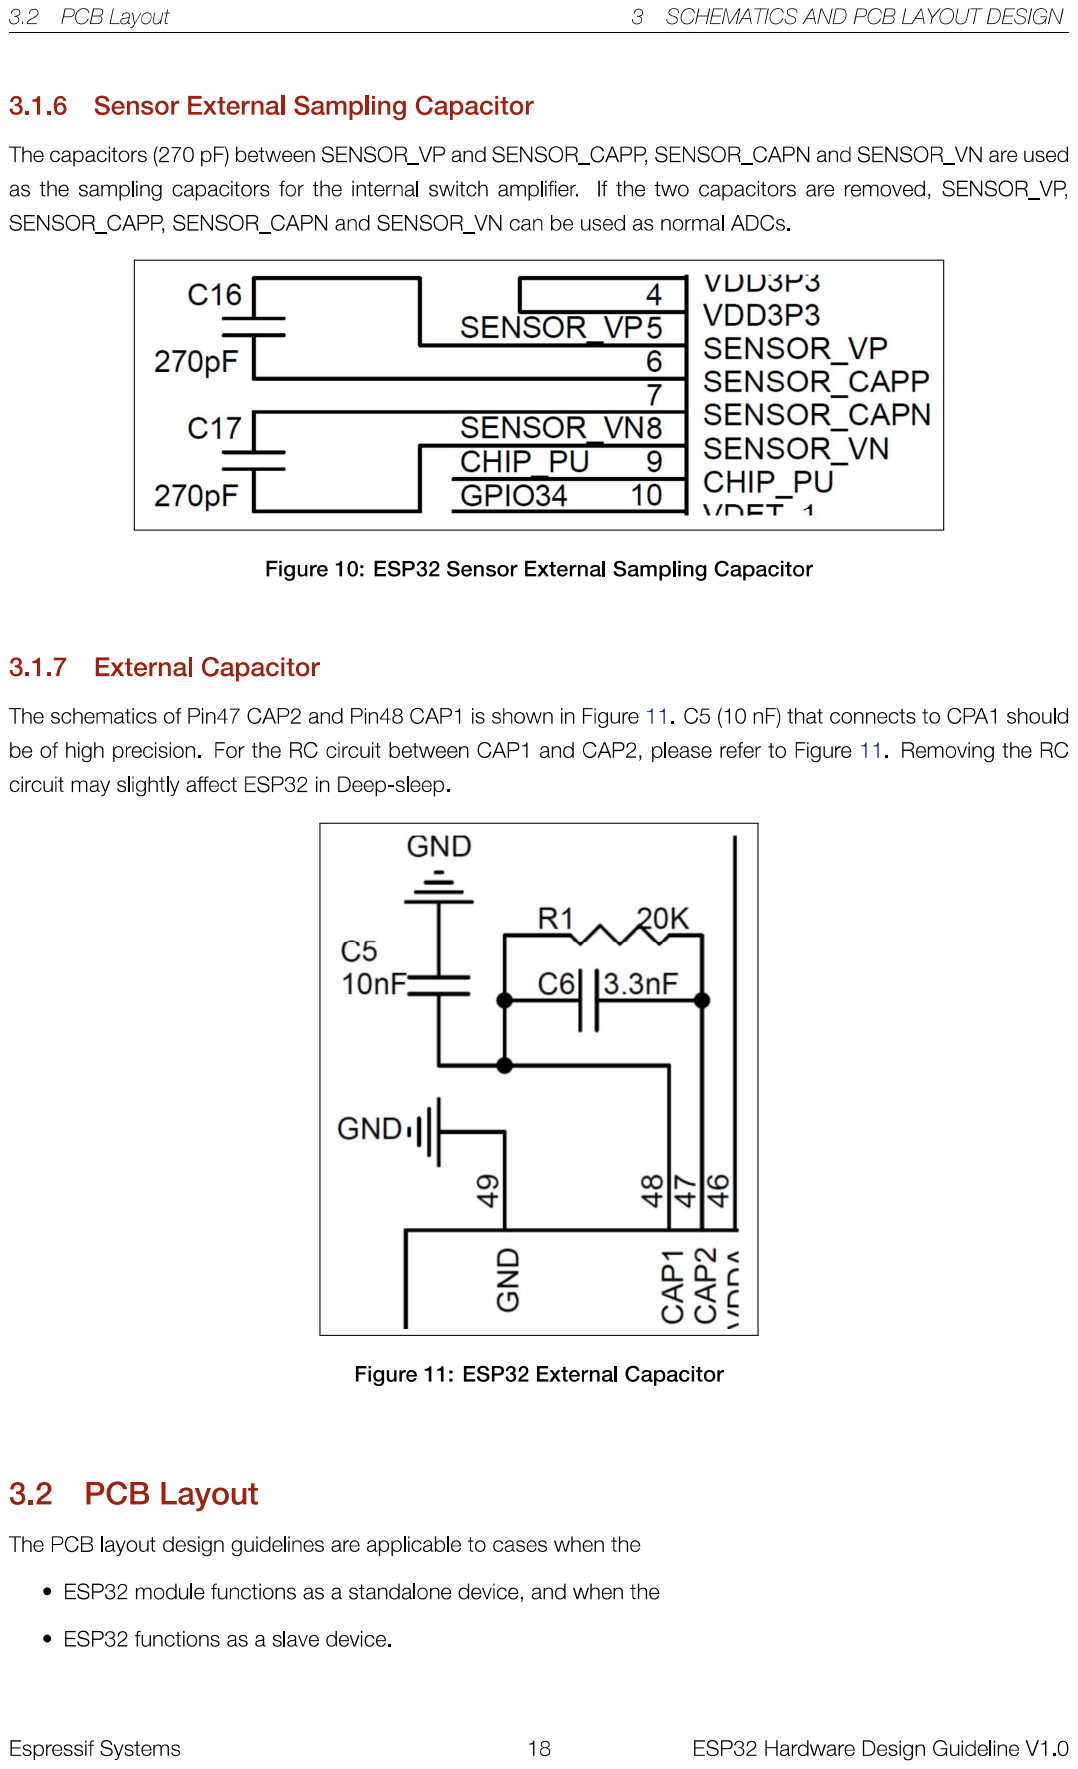
[picture p119: page 20]

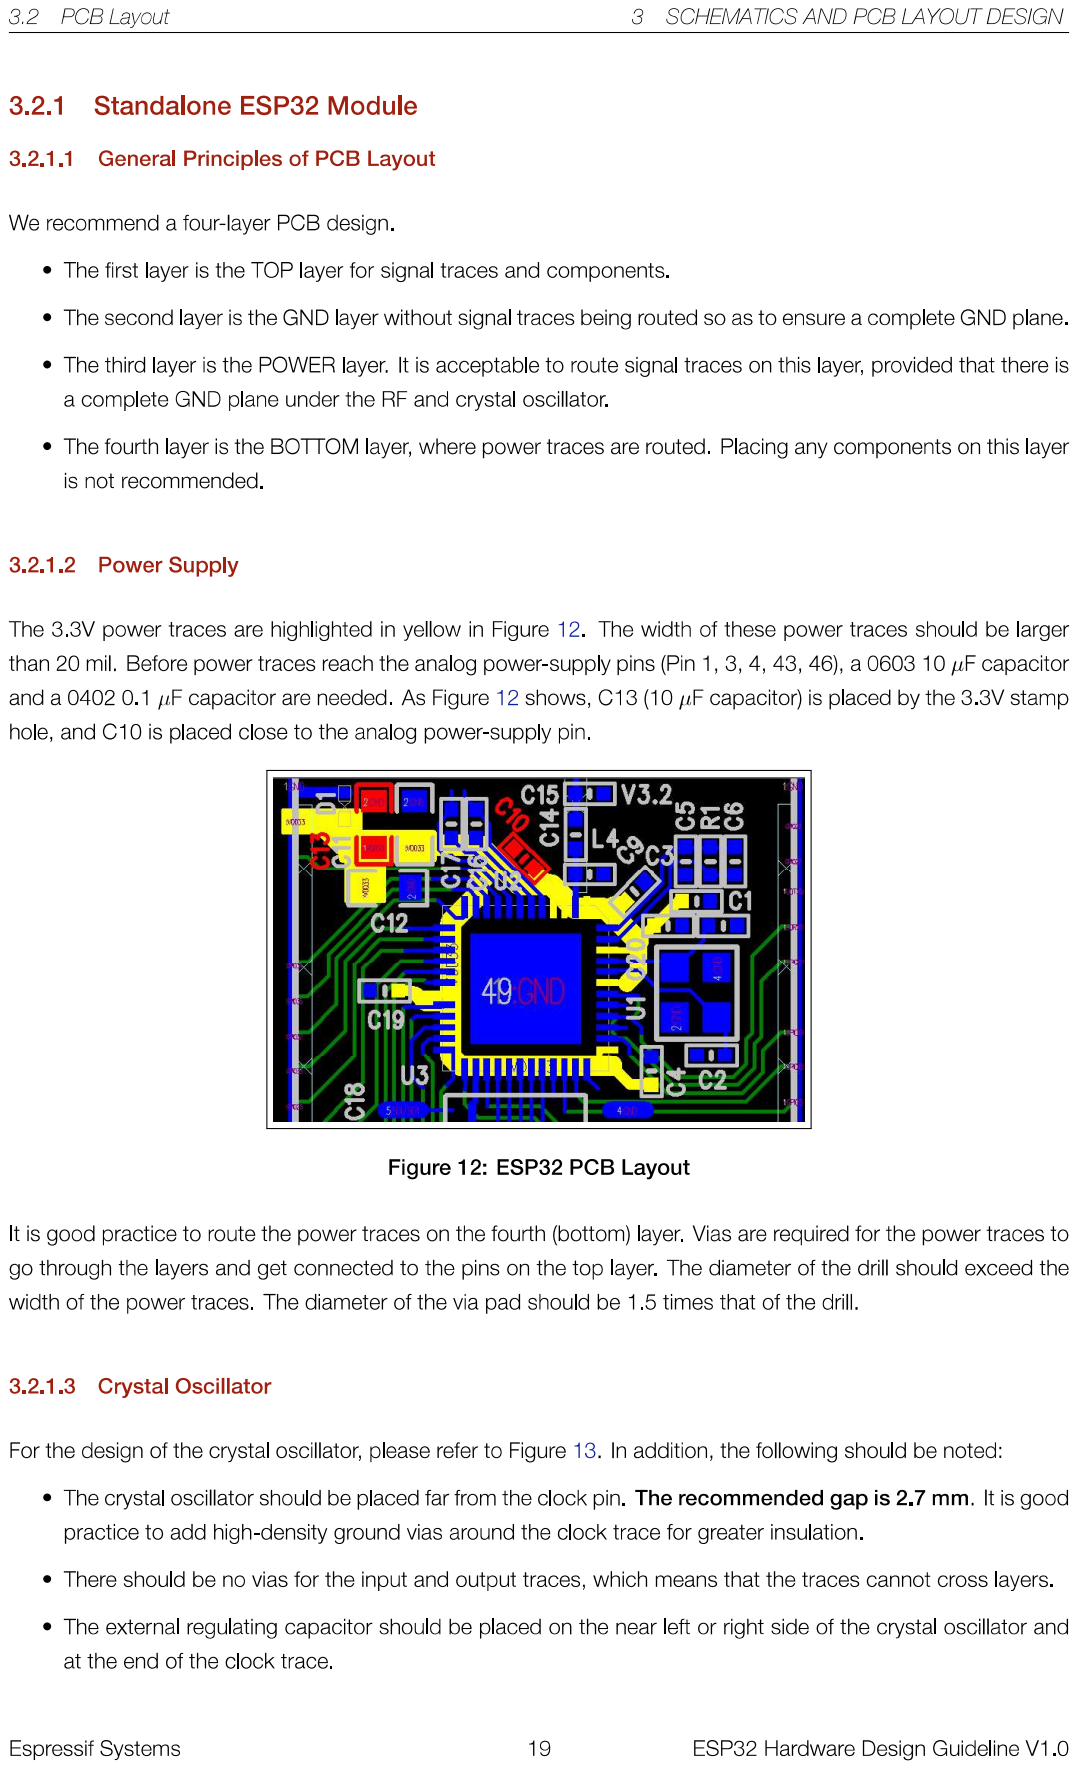
[picture p120: page 21]

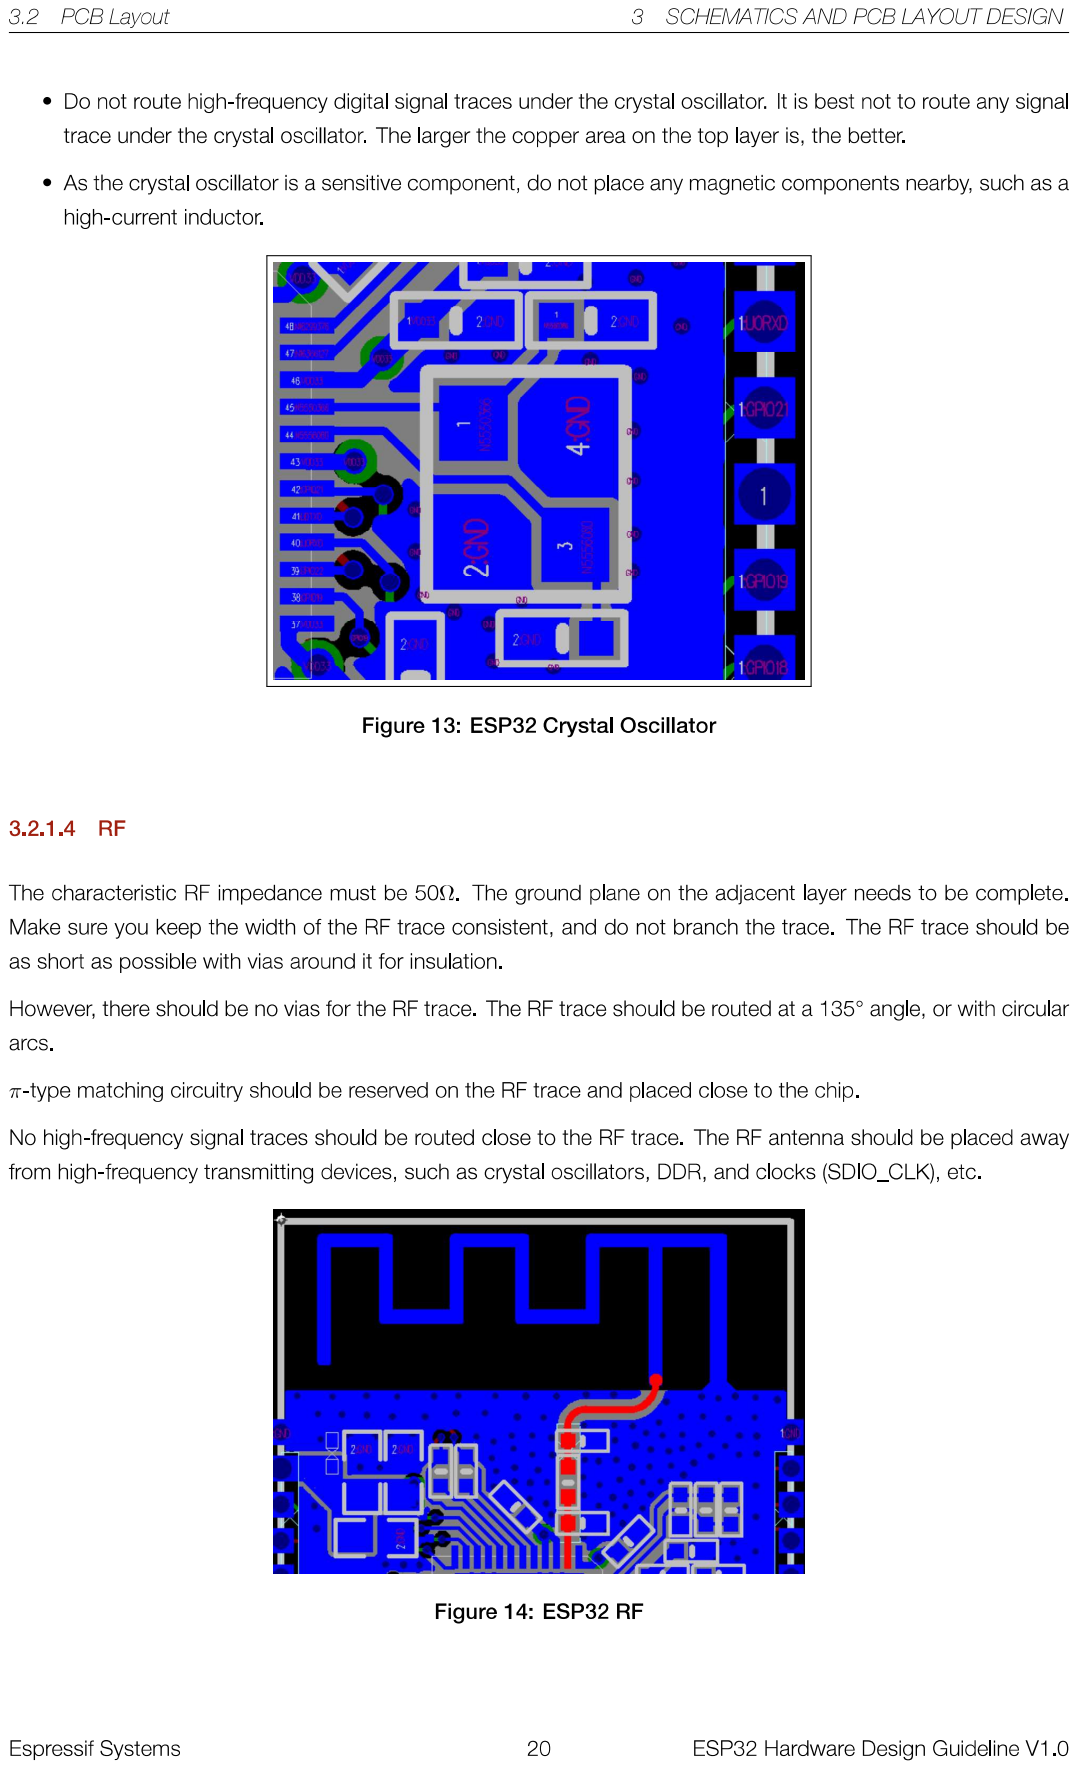
[picture p121: page 22]

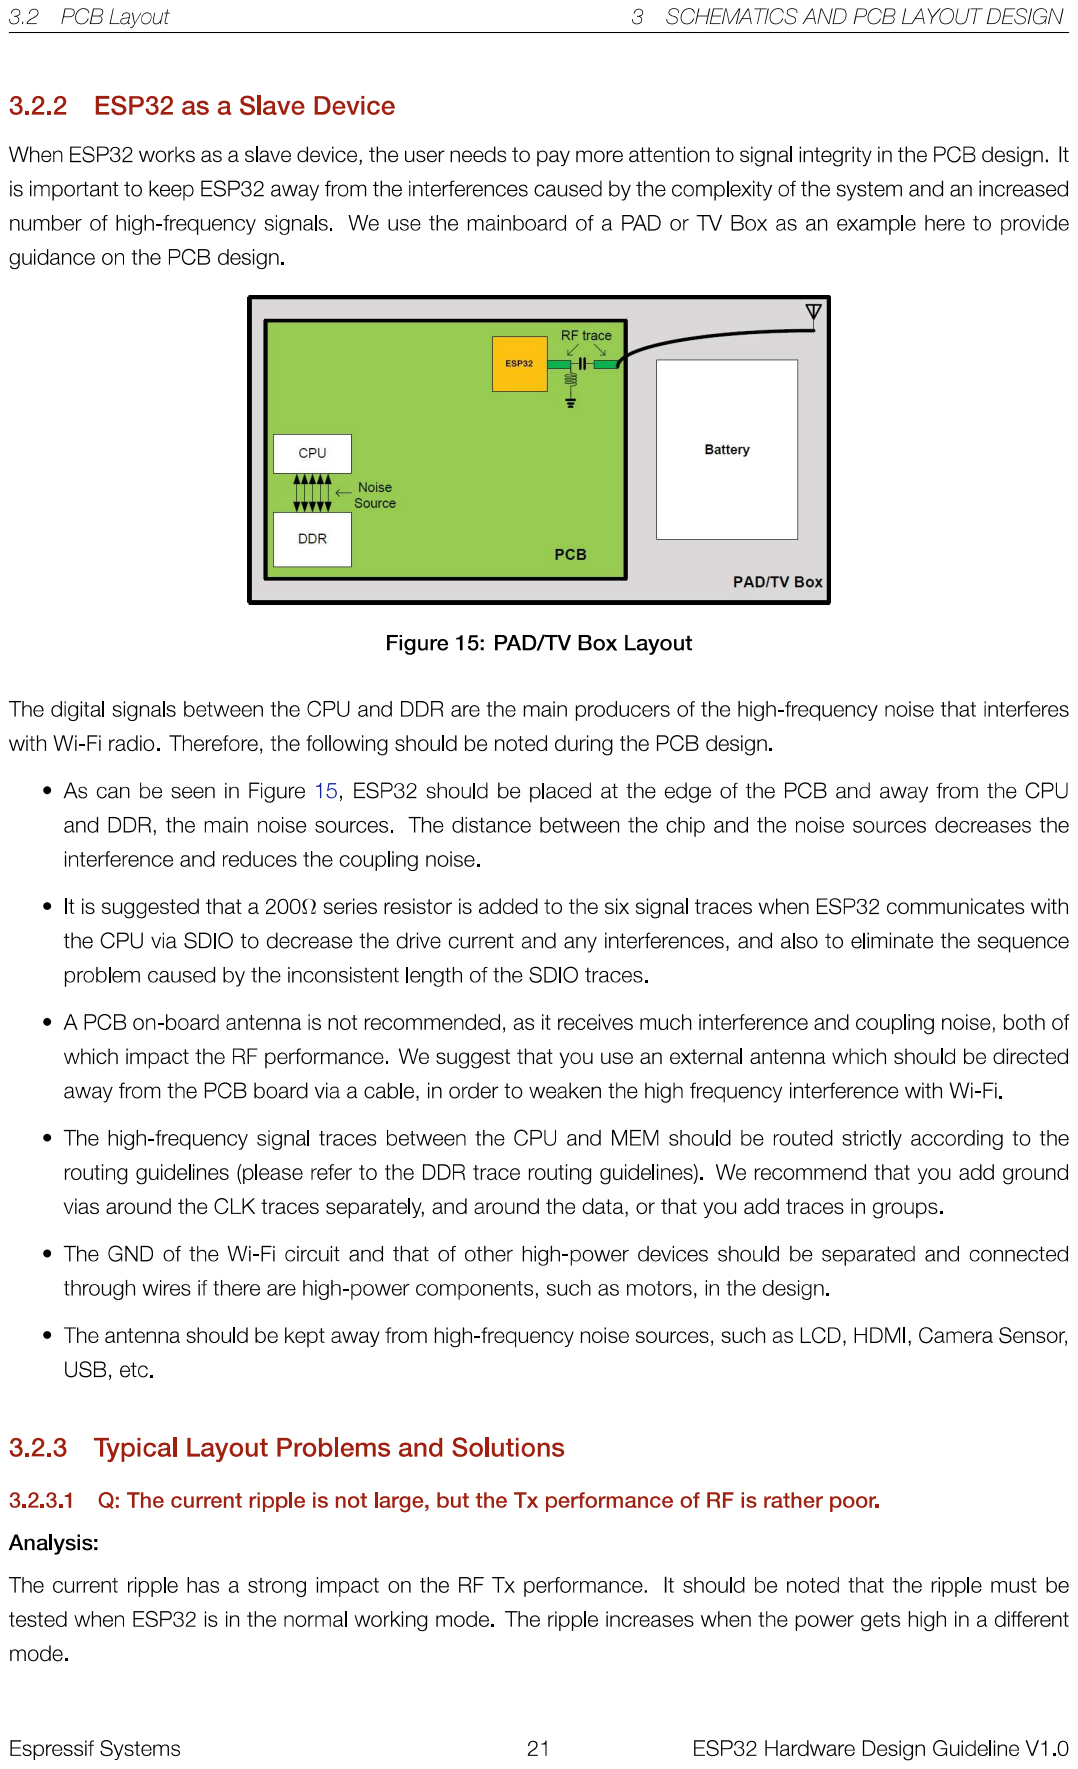
[picture p122: page 23]

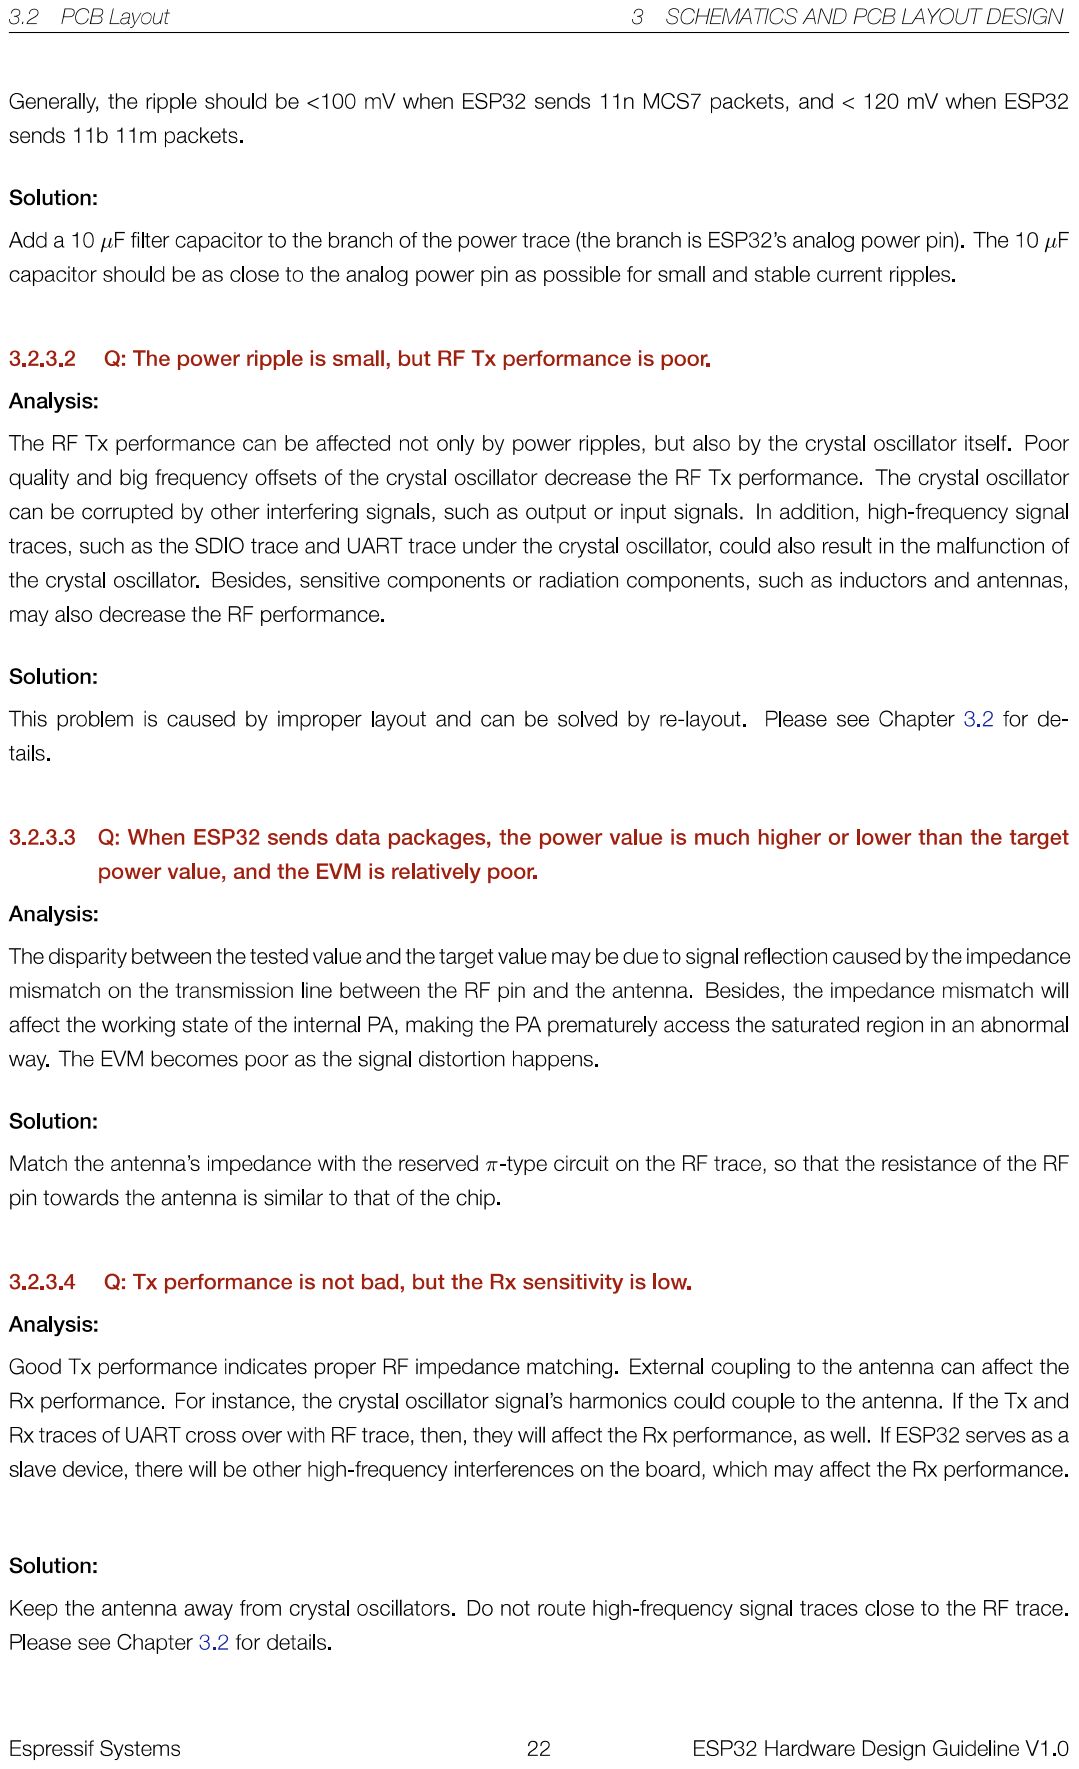
[picture p123: page 24]

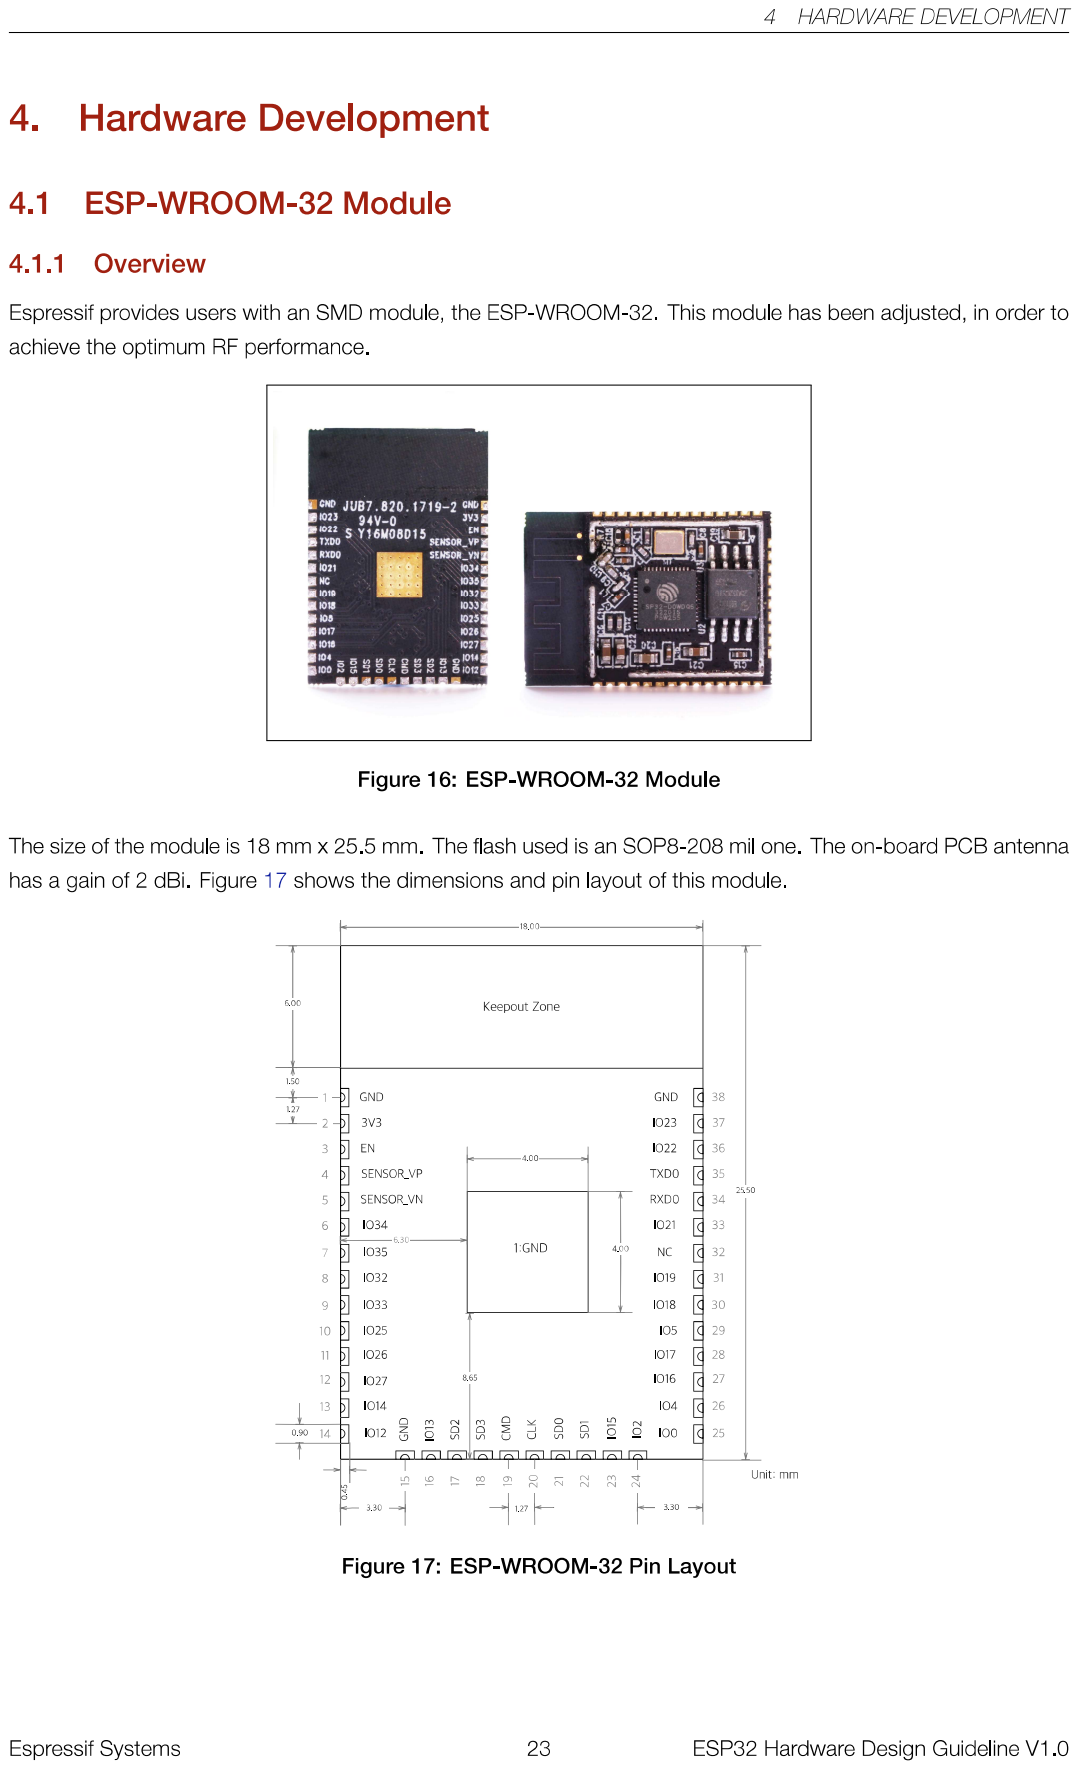
[picture p124: page 25]

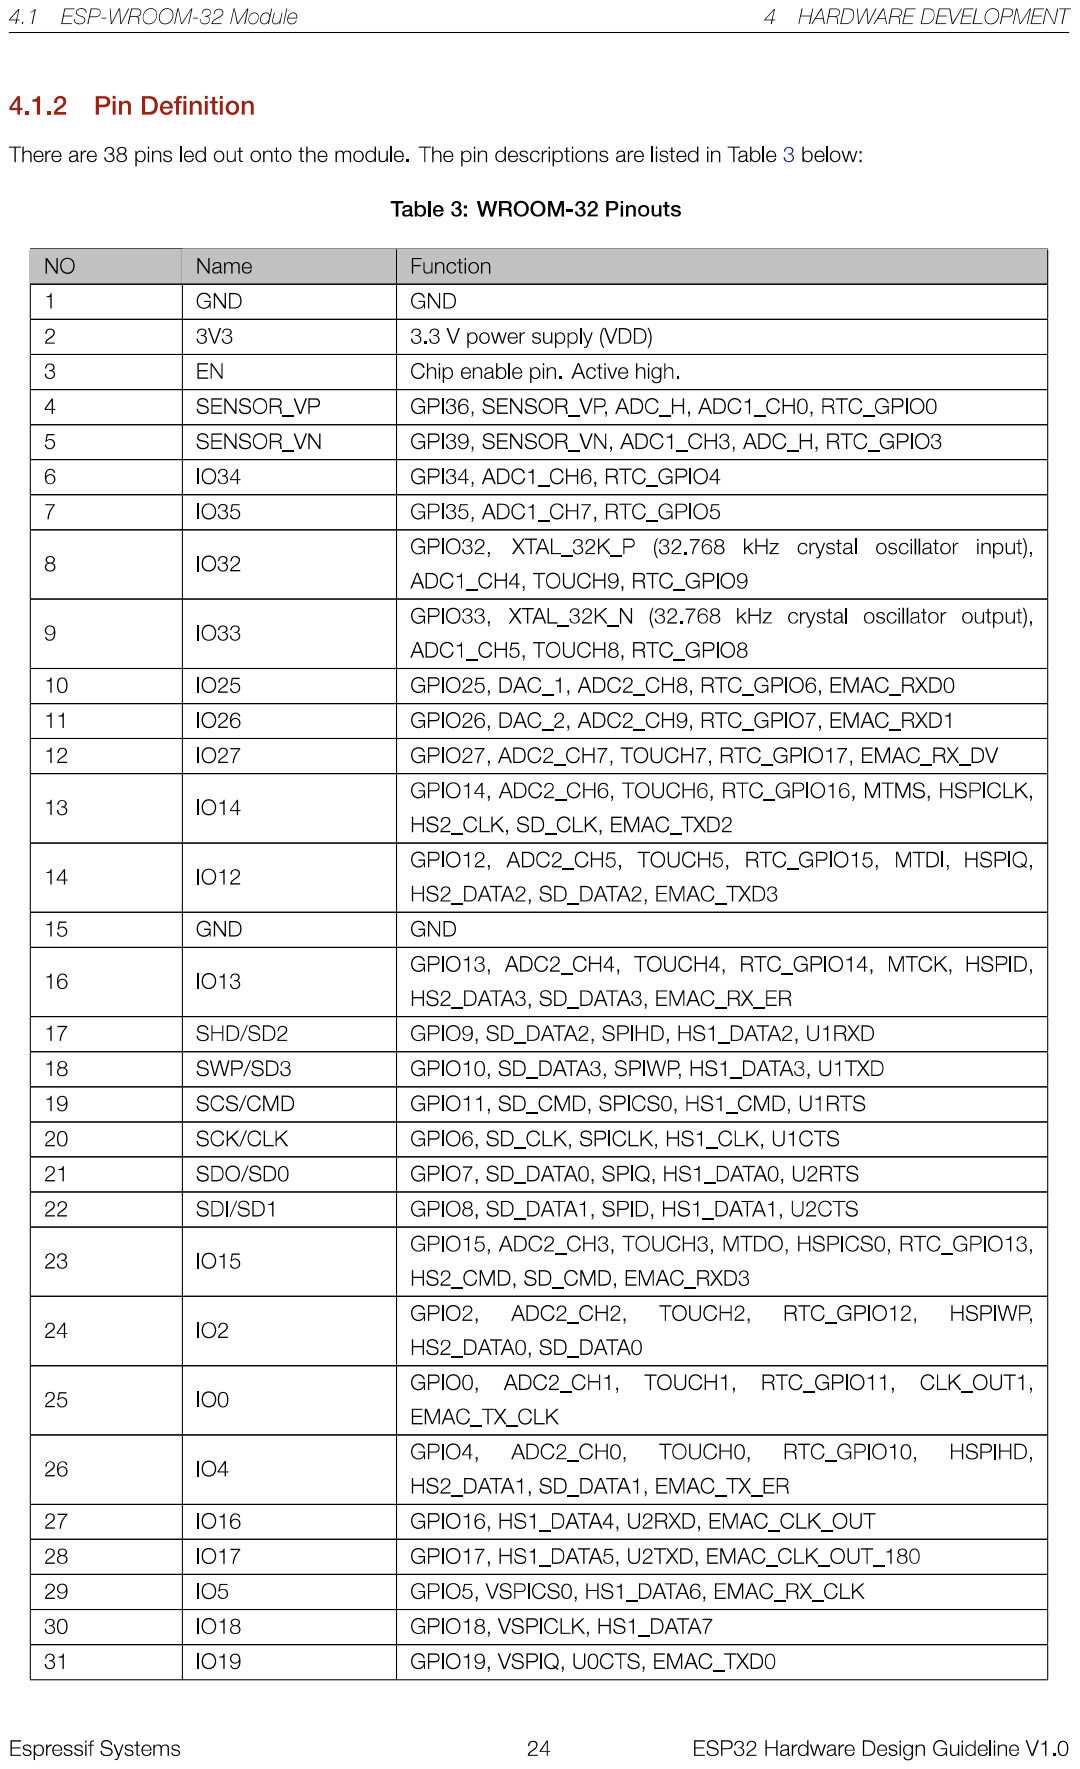
[picture p125: page 26]

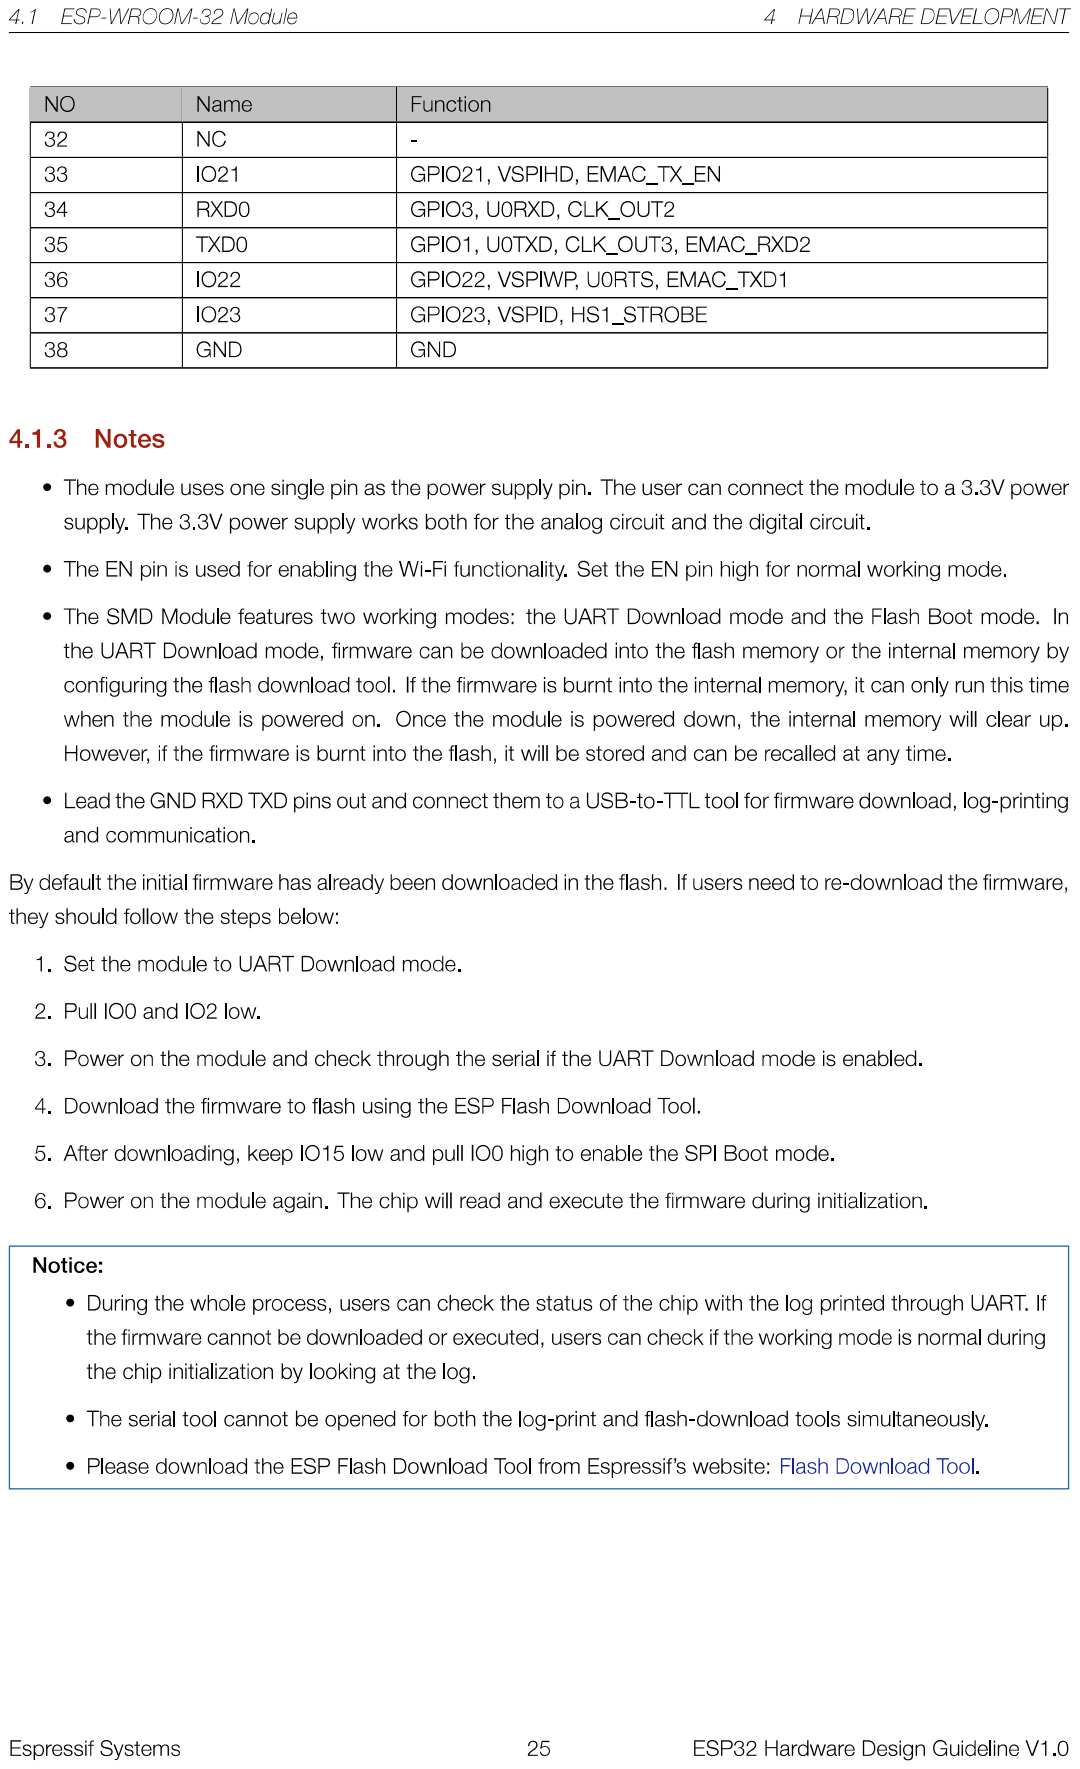
[picture p126: page 27]

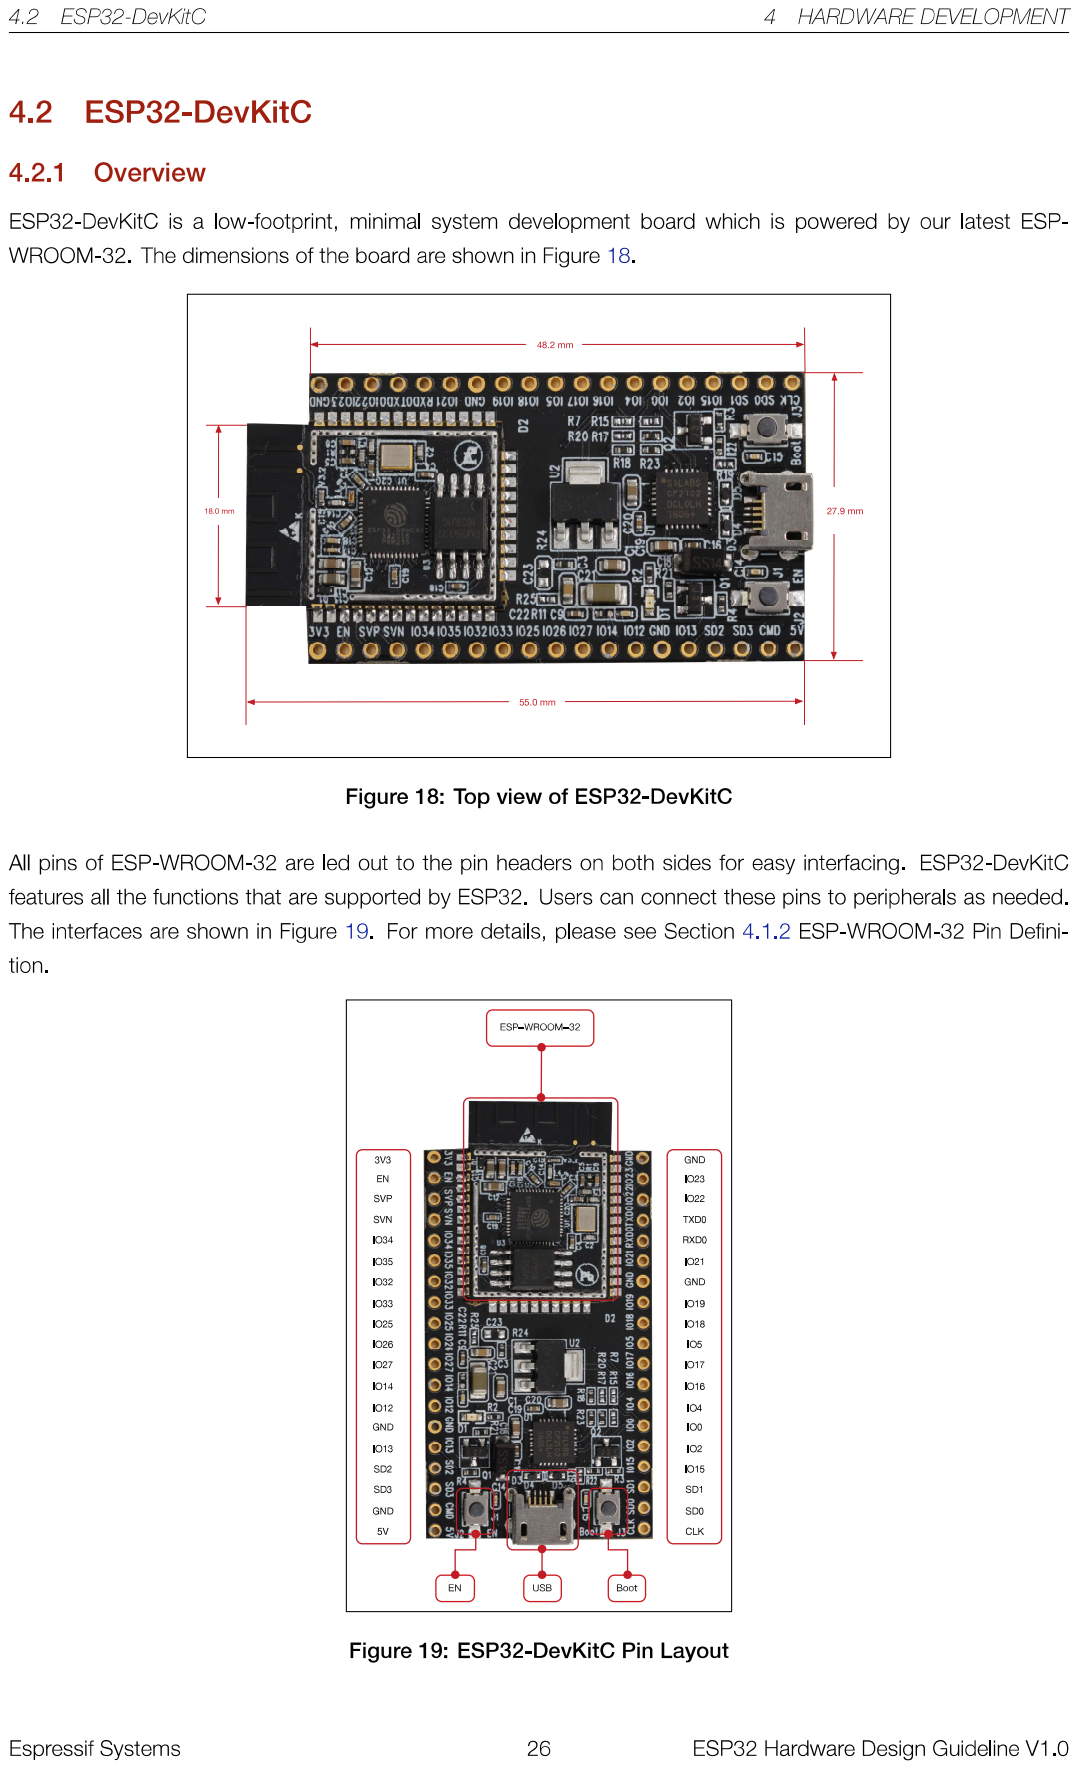
[picture p127: page 28]

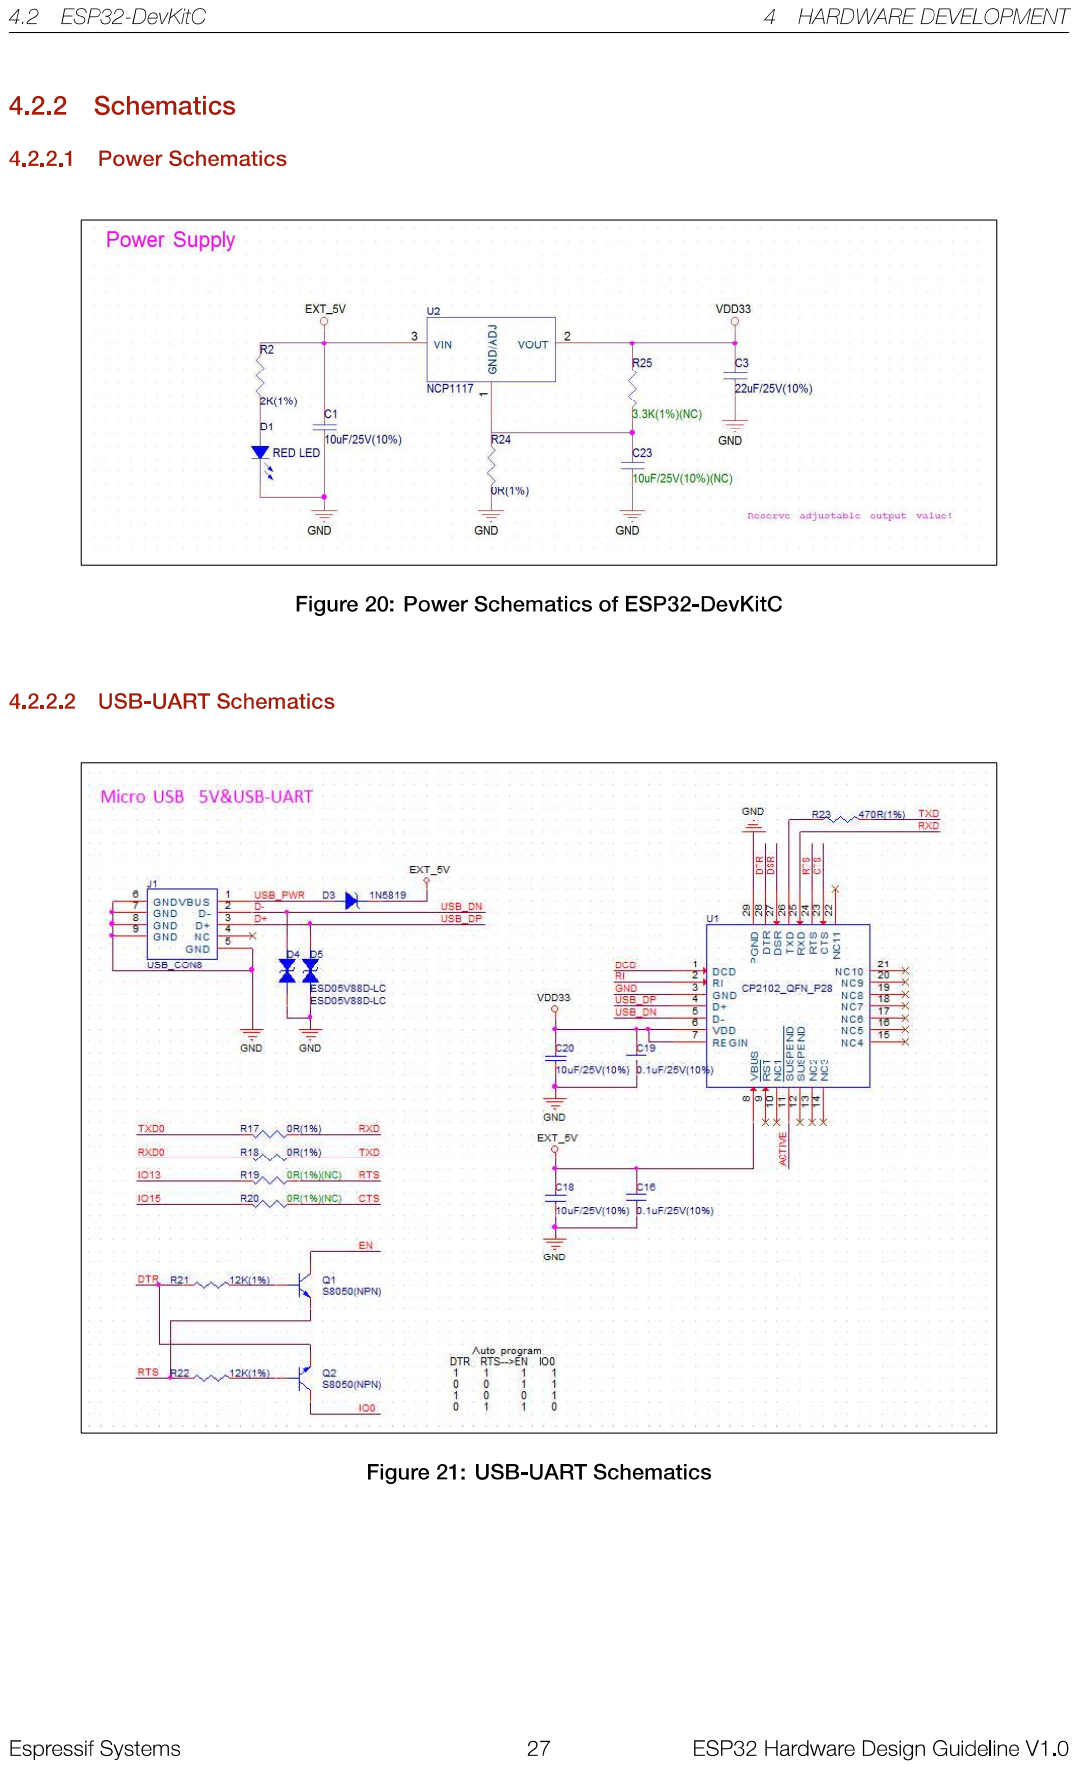
[picture p128: page 29]

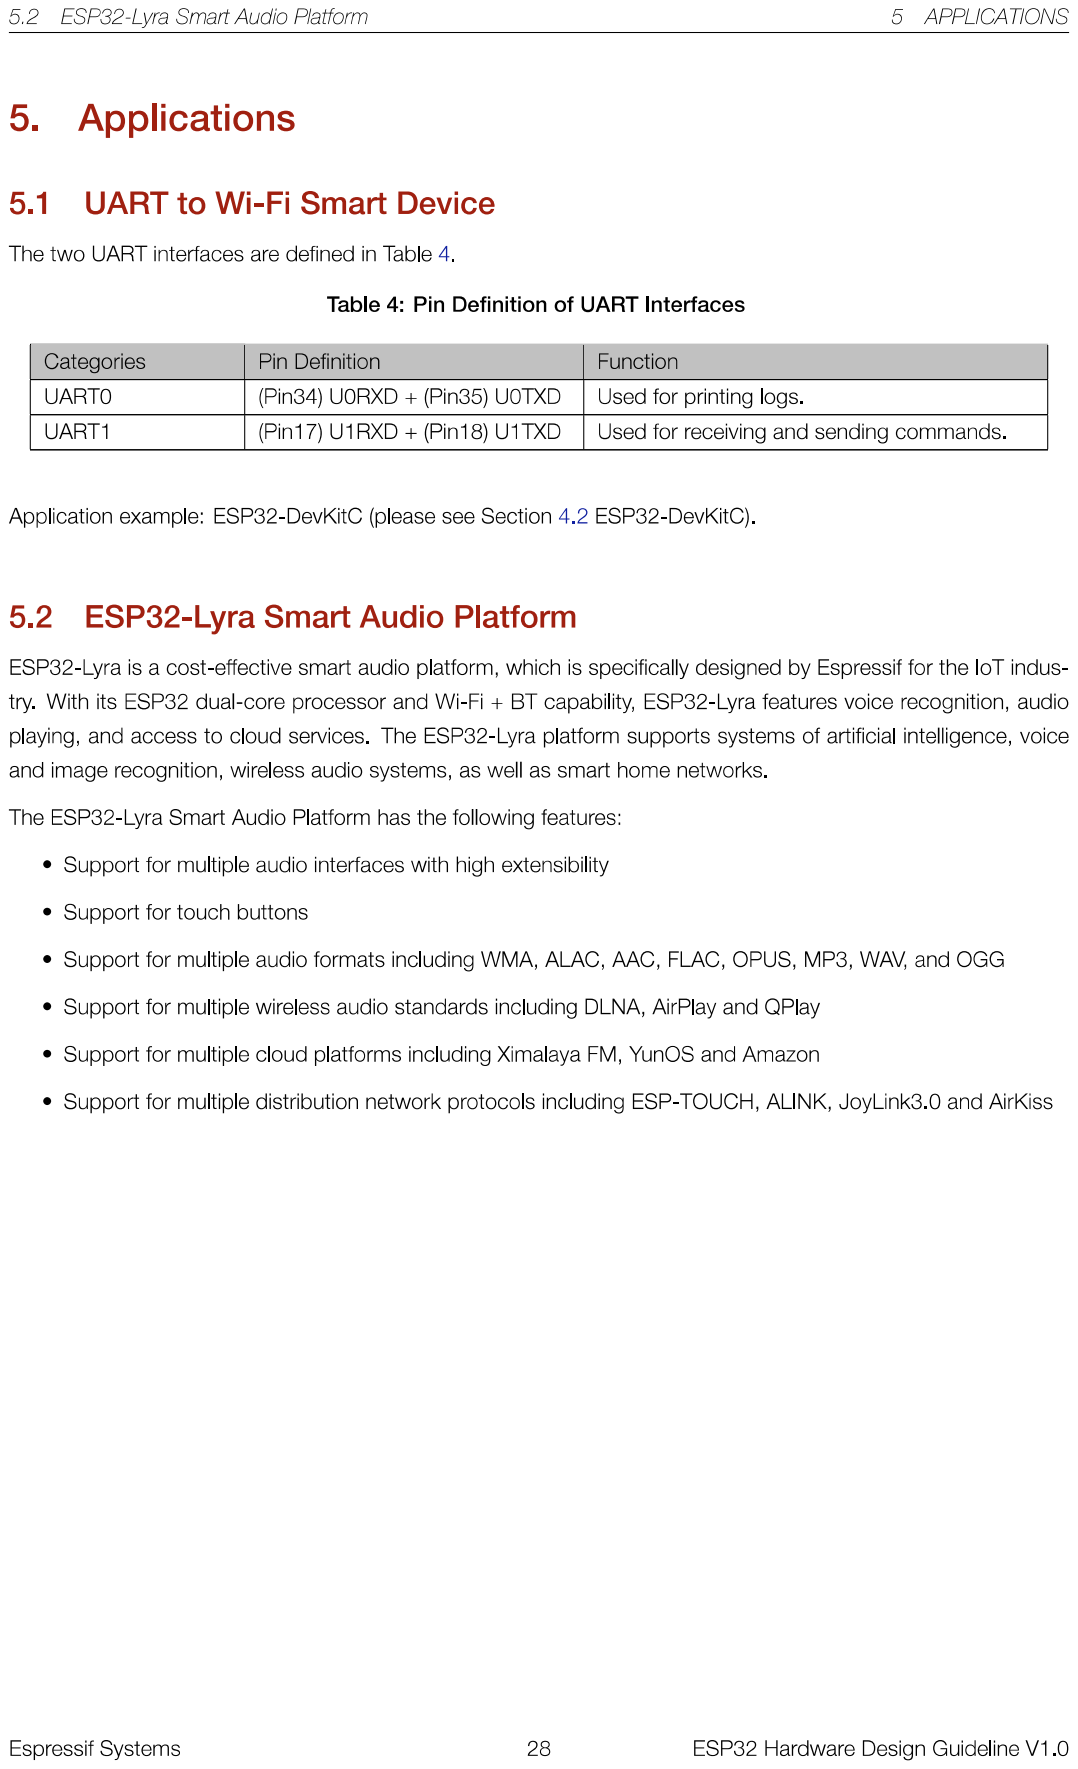
[picture p129: page 30]
